PaolaCV14/IOT-SOFIA-2026/presentacion/paper_segundo_corte_texto.txt

--- PÁGINA 1 ---

LABDST SOFIA, ITESO, FALL 2026 1
SOFIA: Modular Robotic Kinetic Surface for Human-Robot
Interaction and Thermal-Constrained Actuator Characterization
Paola M. Covarrubias-Viveros, Lizeth A. M ´endez-Ortiz, Juan Bernardo Orozco-Quirarte, Karen I. S ´anchez-Garc´ıa,
Alan E. Fuentes-Guti ´errez, Jorge A. Lizarraga, Graciela Baca, Luis Enrique Gonz ´alez-Jim´enez and Luis F.
Luque-Vega
Abstract—Modular robotic systems leverage repeatable elec-
tromechanical units to enable flexible, scalable, and reconfig-
urable architectures. In interactive human-robot installations,
spatial tracking of human body posture and gestures provides in-
tuitive stimulus-response dynamics. This paper presents SOFIA,
an interactive modular robotic surface comprising sixteen elec-
tromechanical units, each providing two rotational degrees of
freedom actuated by commercial MG90S servomotors. While
commercial servomotors encapsulate internal closed-loop position
control via pulse-width modulation (PWM), persistent angular
errors caused by mechanical stalls, external disturbances, or
fabrication tolerances induce thermal degradation and excessive
power consumption. To investigate actuator reliability under
persistent position error conditions, this work formulates an
experimental characterization protocol assessing the thermal
response of an MG90S under mechanical stall. Using an LM35
precision temperature sensor and a commanded reference angle,
an empirical first-order thermal model is derived via logarithmic
transformation and linear regression, yielding an estimated
thermal time constant ofτ≈80.6s and a peak temperature
exceeding70 ◦C. The proposed framework couples 3D real-time
visual tracking with closed-loop kinematic control, providing
direct evidence on the operational limits and thermal constraints
required for reliable long-term deployment in modular robotic
surfaces.
Index Terms—Modular robotics, Human-Robot Interaction
(HRI), servomotor characterization, thermal modeling, bang-
bang control, computer vision, kinematics.
I. INTRODUCTION
M
ODULAR robotics enables the design and construction
of complex robotic systems from repeatable functional
units that integrate mechanical, electronic, and control capabil-
ities. This approach significantly streamlines manufacturing,
system reconfiguration, and maintenance, while supporting
distributed architectures where autonomous modules exchange
information and share operational resources [1]. Compared
to monolithic, rigid robotic platforms, modular reconfigurable
robots offer superior adaptability and permit functional units
to be deployed across diverse spatial and kinematic configu-
rations [1].
In parallel, socially interactive and human-robot interaction
(HRI) systems incorporate perception and actuation mech-
anisms to establish continuous, non-verbal dialogue with
human participants. Within this domain, posture, gestures,
and body kinematics constitute vital communication channels
for interpreting user intent and synthesizing reactive robotic
The authors are with the Department of Technological and Industrial
Processes, ITESO, Tlaquepaque 45604, Jalisco, Mexico.
behavior [2]. Consequently, modern kinetic robotic installa-
tions operate not merely as automated spatial mechanisms,
but as interactive expressive surfaces capable of responding
synchronously to multimodal human stimuli.
Within this framework, this paper introduces SOFIA, a mod-
ular robotic installation comprising sixteen electromechanical
units arranged in a kinetic honeycomb array. Each module
provides two rotational degrees of freedom (2-DOF) driven by
dual metal-gear MG90S servomotors. Each unit incorporates
dedicated onboard electronics for signal reception, trajectory
interpolation, and actuator pulse generation. Global supervi-
sory communication is established via Bluetooth Low Energy
(BLE) and Wi-Fi, whereas inter-module synchronization is
supported through an industrial RS-485 / Modbus bus.
The system relies on an ESP32-C3 microcontroller as
the core processing and telemetry engine [3], coupled with
PCA9685 16-channel 12-bit I 2C PWM controllers [?] to syn-
thesize precise control pulses for the servomotors. Although
commercial off-the-shelf (COTS) servomotors simplify spa-
tial positioning, their internal closed-loop controllers remain
completely encapsulated within the actuator housing. Conse-
quently, while the supervisory system commands an angular
setpoint via external 50 Hz PWM duty cycles, the internal
drive strategy utilized to eliminate error between reference and
actual shaft position is inaccessible to the designer.
This characteristic becomes critical when a servomotor
experiences operational constraints where it cannot reach the
commanded angular setpoint. In large-scale kinetic arrays
composed of numerous densely packed modules, mechanical
interference, fabrication tolerances, structural interference, or
physical obstacles produce persistent, non-zero position errors.
Under such conditions, internal driver behavior governs cur-
rent draw, internal thermal dissipation, and long-term hardware
reliability.
A classical control archetype relevant to bounded-input
actuators under persistent saturation is bang-bang (on-off) con-
trol. Bang-bang strategies naturally arise in control problems
subject to bounded actuation limits and represent a fundamen-
tal baseline for analyzing actuator dynamics under persistent
error [4]. However, whether an embedded servomotor driver
exhibits a quasi-bang-bang response cannot be established
solely from external PWM waveforms.
To address this challenge, this paper experimentally char-
acterizes the electromechanical and thermal behavior of the
MG90S servomotor under persistent position error. By impos-
ing a mechanical constraint on the output shaft and monitoring
surface temperature with a precision LM35 sensor, this study

--- PÁGINA 2 ---

LABDST SOFIA, ITESO, FALL 2026 2
extracts empirical first-order thermal models via linear regres-
sion. The primary working hypothesis posits that persistent
angular error induces an observable thermal signature that
quantitatively reflects actuator operational constraints. The
core contribution of this work lies in combining a vision-driven
modular robotic architecture for human-robot interaction with
rigorous experimental actuator characterization, establishing
thermal boundaries to guarantee operational reliability in ki-
netic surfaces.
A. Related Work
Recent advances in interactive surfaces and vision-driven
robotics have accelerated with lightweight machine learning
inference frameworks. Qui ˜nonezet al.[5] demonstrated the
efficacy of MediaPipe solutions for real-time 3D landmark
estimation. Contemporary computer vision implementations
leveraging MediaPipe [6] and OpenCV [7], [8] demonstrate
how 21-point hand topologies and skeletal posture can be
extracted in real time with minimal computational overhead.
In modular and reconfigurable robotics, Seoet al.[1]
established foundational taxonomy and scalability criteria for
autonomous repeatable modules, emphasizing distributed co-
ordination and power distribution challenges. Fonget al.[2]
surveyed social robotics, demonstrating that physical motion,
non-verbal mirroring, and gestural responsiveness enhance
user engagement. Nevertheless, existing kinetic installations
frequently overlook actuator stall dynamics and internal ther-
mal accumulation occurring across densely populated arrays.
Boyd and Barratt [4] established theoretical boundaries for
bounded controller actions; building upon these foundations,
this research bridges the gap between high-level visual track-
ing and low-level physical actuator reliability.
B. Formal Problem Formulation
The SOFIA system requires coordinated spatial orientation
of 32 independent servomotors across 16 electromechanical
modules. Each actuator receives an angular reference setpoint
θd(t)and is commanded to achieve the target physical orien-
tationθ(t).
The angular position errore(t)for any given actuator is
formally defined as:
e(t) =θ d(t)−θ(t),(1)
whereθ d(t)∈[θ min, θmax]corresponds to the desired (com-
manded) angular position, andθ(t)denotes the instantaneous
actual angular position of the output shaft.
Under ideal, unconstrained operation, the internal feedback
loop drivese(t)→0within a settling timet s ∈[75,180]ms.
However, when an external mechanical constraint prevents the
actuator from reachingθ d(t)such thatθ(t) =θ stall ̸=θ d(t),
the error persists indefinitely:
e(t) =θ d(t)−θ stall = ∆θ0 ̸= 0,∀t≥t 0.(2)
Whene(t)persists, the internal H-bridge driver continu-
ously supplies high current to the DC coreless motor in an
attempt to minimize the tracking discrepancy. This condition
causes significant Joule heating (P loss =I 2R) within the
motor armature and driver silicon, inducing rapid thermal
accumulation. Modeling this thermal profile and its associated
time constant provides the quantitative foundation for actuator
risk mitigation in the SOFIA array.
II. MATERIALS ANDMETHODS
Table I summarizes the bill of materials for the SOFIA 16-
module system, including each component’s technical descrip-
tion, manufacturer, and country of origin.
The servomotor operational limits and step response
parameters were experimentally evaluated using
the test protocol recorded in ”docs/experimental-
data/servomotor pruebas caracterizacion.xlsx”. Under
continuous PWM excitation at 50 Hz, the effective angular
deflection spannedθ∈[19.3 ◦,70.2 ◦]with a mean operating
angle of47.9 ◦ and step response times ranging between
75ms and180ms.
A. Experimental Setup: Thermal Characterization under Per-
sistent Error
To investigate the thermal behavior and reliability limits of
the MG90S servomotors within the SOFIA architecture, an
experimental testing apparatus was designed to record ther-
mal dissipation under mechanical restriction. The test bench
comprises:
1) An MG90S metal-gear servomotor powered by a regu-
lated 5.0 V DC supply.
2) A 10 kΩlinear precision potentiometer utilized to set
and modulate the commanded angular setpointθ ref(t).
3) A calibrated LM35 precision centigrade temperature
sensor mechanically thermally coupled to the servomo-
tor casing via thermal interface compound, providing an
analog output of10mV/ ◦C.
4) An acquisition node based on an ESP32 microcontroller
acquiring angular commands and surface temperature
Tservo(t)at a sampling rate of1Hz.
A rigid mechanical boundary stop was rigidly fixed to
the servomotor output horn to physically prevent the output
shaft from reaching the commanded angular referenceθ ref(t),
deliberately maintaining a persistent non-zero error condition:
e(t) =θ ref(t)−θ stall >0. Ambient room temperatureT amb
was monitored as the reference operating baseline.
The experimental characterization protocol was conducted
in two sequential stages:
•Trial 1 (Failure and Degradation Assessment):The
actuator was initialized atT amb = 21.37◦C and subjected
to a persistent stall reference ofθ ref = 180 ◦. The test
proceeded continuously for226s, until distinct audi-
ble abnormalities, gear strain, and subsequent actuator
degradation occurred. The surface temperature climbed
monotonically to a critical peak ofT max = 64.84◦C.
•Trial 2 (Extended Thermal Accumulation and Cool-
ing):In an extended continuous run spanningt∈
[973.1,1654.1]s (682 data points), the actuator thermal
profile was evaluated under varying commanded angular
steps. Starting fromT amb = 19.29◦C, the casing reached

--- PÁGINA 3 ---

LABDST SOFIA, ITESO, FALL 2026 3
TABLE I
BILL OFMATERIALSSUMMARY FOR THESOFIA 16-MODULESYSTEM
Component Qty. Technical description Manufacturer Country / Location
MG90S Servomotor 32 Metal gear micro servo, rated torque 1.8–2.2 kgf·cm at 4.8–6.0 V ,
evaluated angle rangeθ∈[19.3 ◦,70.2 ◦], 50 Hz PWM control TowerPro Shenzhen, China
Module Enclosure 16 3D-printed PLA enclosure, custom SOFIA003 honeycomb design
for 2-DOF module
In-house (LabDST) Mexico City, Mexico
M3 Fasteners (Various) 64 Stainless steel socket head cap screw, M3×10 mm, for servo
and frame mounting
Generic Mexico City, Mexico
PCA9685 Servo Driver 2 16-Channel 12-bit PWM I 2C driver module for 32 servomotors NXP Semiconductors /
Adafruit
Eindhoven, Netherlands
ESP32-C3 Master MCU 1 32-bit RISC-V microcontroller, 2.4 GHz Wi-Fi / Bluetooth 5 LE
for trajectory generation
Espressif Systems Shanghai, China
TABLE II
ESP32-C3TECHNICAL SPECIFICATIONS AND COMPLIANCE ASSESSMENT.
Component Parameter Value Source
ESP32-C3
(Espressif
Systems,
v2.4)
Supply V oltage
(VDDA,
VDD3P3,
VDD3P3 RTC)
3.0–3.6 V; 3.3 V
typical
Datasheet v2.4,
Section 5.2, Table
5-2, p. 54
ESP32-C3 Cumulative
Supply Current
(IVDD)
0.5 A min. Datasheet v2.4,
Section 5.2, Table
5-2, p. 54
ESP32-C3 Peak Wi-Fi
Transmission
Current
276–335 mA, de-
pending on the
operating mode
Datasheet v2.4,
Section 5.6.1,
Table 5-7, p. 56
ESP32-C3 VIH: High-Level
Input V oltage
0.75×VDD min. Datasheet v2.4,
Section 5.4, Table
5-4, p. 55
ESP32-C3 VIL: Low-Level
Input V oltage
−0.3to 0.25×
VDD V
Datasheet v2.4,
Section 5.4, Table
5-4, p. 55
ESP32-C3 Strapping
Pins / Boot
Configuration
Pins
GPIO2, GPIO8,
and GPIO9. Their
logic levels are
sampled during
reset to determine
the boot mode.
Datasheet v2.4,
Section 3, Boot
Configuration, p.
30
ESP32-C3 GPIO8 and
GPIO9 Boot-
Time Levels
SPI Boot: GPIO9
= 1. Joint Down-
load Boot: GPIO8
= 1 and GPIO9
= 0. The GPIO8
= 0, GPIO9 =
0 combination is
not listed as a
valid boot mode
in Table 3-3.
Datasheet v2.4,
Section 3.1, Table
3-3, p. 31
ESP32-C3 Wi-Fi 2.4 GHz, IEEE
802.11 b/g/n
Datasheet v2.4,
Features section,
p. 3
ESP32-C3 Bluetooth Bluetooth 5 Datasheet v2.4,
Features section,
p. 3
ESP32-C3 Operating
Temperature
56 ◦C Datasheet v2.4,
Section 1.2, Table
1-1, p. 12
a steady-state thermal maximum ofT max = 70.21 ◦C
(∆T= 50.92 ◦C) before stabilization and subsequent
cooling upon stall removal.
B. First-Order Thermal Modeling and Parameter Identifica-
tion
For the experimental characterization, the commanded an-
gular position acts as the system input,u(t) =θ d(t), while the
recorded servomotor casing temperature represents the mea-
sured system output,y(t) =T s(t). Room ambient temperature
is denoted asT a.
TABLE III
SERVOMOTORMG90S TECHNICAL SPECIFICATIONS AND COMPLIANCE
ASSESSMENT.
Component Parameter Value Source
MG90s Supply and operating
V oltage
4.8 V – 6.0 V MG90S datasheet,
Tower Pro, p.2
MG90s Stall Torque 1.8 kgf·cm at
4.8V , 2.2 kgf·cm
at 6V
MG90S datasheet,
Tower Pro, p.1
MG90s Operating Speed 0.1 s/60 ◦ at 4.8V ,
0.08 s/60 ◦ at 6V MG90S datasheet,Tower Pro, p.1
MG90s Control Signal PWM, orange
wire; Vcc red;
GND brown;
20 ms (50 Hz)
period, 1–2 ms
duty cycle
MG90S datasheet,
Tower Pro, p.2
MG90s Rotation Range approximately
180 degrees (90 ◦
in each direction)
MG90S datasheet,
Tower Pro, p.2
MG90s Evaluated
Angle Range
(Experimental)
19.3◦ – 70.2 ◦
(mean: 47.9 ◦) LabDST test log(docs/experimental-
data)
MG90s Response Time (Ex-
perimental)
75 – 180 ms LabDST test log
(docs/experimental-
data)
MG90s Dead Band Width 5µs MG90S datasheet,
Tower Pro, p.2
MG90s Operating Tempera-
ture
Not specified in
datasheet
N/A
MG90s Dimension & Weight 22.5×12×35.5
mm approx.; 13.4
g
MG90S datasheet,
Tower Pro, p.1
In accordance with first-order thermal dynamics, the system
is modeled in the Laplace domain by the empirical transfer
function:
GT (s) = Ts(s)Θd(s) = KTτT s+ 1 ,(3)
whereK T represents the thermal steady-state gain ( ◦C/rad or
◦C/◦), andτ T is the thermal time constant of the actuator.
In the time domain, the step response of this first-order
system to a persistent commanded step inputθ d(t)is expressed
as:
Ts(t) =T a + (Tss −T a)

1−e −t/τT

,(4)
whereT ss represents the asymptotic steady-state temperature
reached under continuous stall.
Following the identification methodology presented in the
LabDST course lectures, the non-linear exponential response
is transformed into a linear relationship:
ln (Tss −T s(t)) =− 1τT t+C,(5)

--- PÁGINA 4 ---

LABDST SOFIA, ITESO, FALL 2026 4
TABLE IV
PCA9685TECHNICAL SPECIFICATIONS AND COMPLIANCE ASSESSMENT.
Component Parameter Value Source
PCA9685
(NXP Semi-
conductors,
datasheet
Rev. 4)
Supply V oltage
(VDD)
2.3–5.5 V Datasheet Rev. 4,
Section 2, Table
14, p. 38
PCA9685 PWM Resolution 12 bits (4096
steps)
Datasheet Rev. 4,
Section 1, p. 1
PCA9685 Number of PWM
Channels
16 independent
channels
Datasheet Rev. 4,
Section 1, p. 1
PCA9685 Communication
Interface
I2C Fast-mode
Plus
Datasheet Rev. 4,
Section 2, p. 2
PCA9685 Maximum I 2C
Frequency
Up to 1 MHz Datasheet Rev. 4,
Section 2, p. 2
PCA9685 PWM Frequency
Range
24 Hz – 1526 Hz Datasheet Rev. 4,
Section 7.3.5, p.
25
PCA9685 Default PWM
Frequency
Approximately
200 Hz
Datasheet Rev. 4,
Table 8, p. 25
PCA9685 I2C Address Con-
figuration
A0–A5 pins, up
to 62 devices
Datasheet Rev. 4,
Section 7.1, p. 7
PCA9685 Output Current 25 mA per output Datasheet Rev. 4,
Table 13, p. 38
PCA9685 Total Output Cur-
rent
400 mA maxi-
mum
Datasheet Rev. 4,
Table 13, p. 38
PCA9685
Module
(UNIT
Electronics)
Output Ports 16 PWM outputs
with V+, GND
and PWM signal
UNIT Electronics
product specifica-
tion
PCA9685
Module
(UNIT
Electronics)
Logic V oltage 3–5 V UNIT Electronics
product specifica-
tion
PCA9685
Module
(UNIT
Electronics)
Servo Power Sup-
ply (V+)
External power
supply for
connected
actuators
UNIT Electronics
product specifica-
tion
PCA9685 Operating
Temperature
−40 ◦Cto
+85 ◦C Datasheet Rev. 4,Table 13, p. 38
whereC= ln(T ss −T a)is a constant. Applying linear least-
squares regression betweenln(T ss −T s(t))and timet, the
slope of the fitted linem=−1/τ T provides the estimate of
the thermal time constant:
τT =− 1m .(6)
Evaluating the empirical data from Trial 1 (t∈[1,226]s,
Ta = 21.37 ◦C,T ss ≈64.84 ◦C) yields a regression slope of
m=−0.01241s −1, corresponding to an identified thermal
time constant ofτ T ≈80.6s.
This quantitative identification confirms that when an
MG90S servomotor enters an unmitigated mechanical stall, it
reaches63.2%of its maximum thermal rise in approximately
80s, approaching destructive casing temperatures (>65 ◦C)
within 4 minutes. Because the internal driver continuously
applies peak torque without internal thermal throttling, its be-
havior closely mirrors an unconstrained bang-bang controller
under saturation.
III. DESIGN ANDIMPLEMENTATION OF THE
TECHNOLOGICALSOLUTION
The SOFIA technological solution integrates physical mod-
ular hardware, distributed electronics, and real-time vision-
based kinematic coordination.
0 50 100 150 200
Time t (s)
20
30
40
50
60
70Temperature (∘ C)
(a) Trial 1: Heating under continuous stall
Measured Ts(t)
Peak Tmax = 64.84 ∘ C
Ambient Ta = 21.37 ∘ C
0 100 200 300 400 500 600 700
Time t (s)
20
30
40
50
60
70Temperature (∘ C)
(b) Trial 2: Extended thermal cycle
Measured Ts(t)
Peak Tmax = 70.21 ∘ C
Ambient Ta = 19.29 ∘ C
Fig. 1. Experimental thermal characterization of the MG90S servomotor under
persistent mechanical stall: (a) Trial 1 heating curve until audible failure at
t= 226s (T max = 64.84◦C); (b) Trial 2 extended thermal cycle across 682
data points reaching peak steady-state temperature of70.21 ◦C.
A. System Architecture and Subsystems
The physical and functional architecture of the SOFIA
platform is organized into three primary interconnected sub-
systems:
•Perception and High-Level Control:A host workstation
executes an optimized real-time vision pipeline running
on Python. It captures live camera feeds, performs 3D
upper-body pose estimation and dual 21-point hand topol-
ogy tracking, recognizes static and dynamic interaction
gestures, and translates user coordinatesp(t)∈R 3 into
spatial target orientations.
•Master Communication and Telemetry:An ESP32-
C3 master microcontroller receives spatial setpoints via
low-latency Wi-Fi / BLE communication and broadcasts
synchronized module packets across an isolated RS-485
/ Modbus serial bus.
•Distributed Modular Honeycomb Array:16 indepen-
dent 2-DOF modules receive target angular pairs(q 1, q2).
Actuation pulses are generated locally via PCA9685
12-bit PWM controllers, driving 32 MG90S metal-gear
servomotors.
B. Computer Vision Tracking and Dynamic Gesture Pipeline
The perception layer is developed using Python 3.11 with
MediaPipe Tasks and OpenCV , structured into a modular, low-
latency architecture:
1)Real-Time 3D Landmark Extraction:Using Google
MediaPipe’s Landmarker models in video mode, the
system extracts 33 holistic body landmarks and two sets
of 21 3D hand coordinates (x, y, z) with millisecond-
accurate timestamps, achieving stable 30 FPS through-
put on host CPUs.
2)Rotation-Invariant Hand Topology:Finger states are
computed using 3D Euclidean distances between distal
tips and the wrist base, normalized against palm scale
∥pwrist −p MCP∥. This eliminates perspective distortion
when fists face the camera.
3)Dynamic Gesture Recognition Engine:A modular
coordination layer (GestureDetector) arbitrates between
static and dynamic interactions with strict temporal
priority:
•Dynamic Wave (Saludo):Tracks lateral palm os-
cillations (landmark 9X-coordinate); requires at

--- PÁGINA 5 ---

LABDST SOFIA, ITESO, FALL 2026 5
least 3 direction reversals and amplitude>0.05
normalized units, prioritizing greeting over static
open-hand detection.
•Two-Handed RPS Game Intent (Intenci ´on PPT):
Detects a horizontal flat palm as a reference plane
and records 3 vertical fist-pump impacts using a
finite-state machine (d contact <0.17andd release >
0.20normalized units). A hysteresis hold filter pre-
vents transient flickering with static rock or paper
gestures.
•Static Postures:Detects two-handed heart geome-
tries, scissors, open paper, and closed fists.
C. Electronic Interconnection and Current Hardware Stage
In the current development stage (Corte 1, Discover→
Learn), the physical electronic architecture is validated us-
ing commercial off-the-shelf (COTS) breakout boards on
breadboards, directly interconnecting the ESP32-C3 microcon-
troller, dual PCA9685 PWM drivers, and external 5.0 V power
rails. Custom printed circuit board (PCB) layout, routing, and
fabrication remain open work for subsequent project phases
(Make→Test), once the thermal boundaries and wiring
constraints of the 16-module array are fully validated through
the present prototype.
D. Thermal Protection and Reliability Risk Mitigation
Based on the empirical thermal constant (τ≈80.6s)
derived in Section II-B, software-level watchdog limits are
integrated into the SOFIA kinematic controller:
1)Command Saturation Limiting:Commanded angles
are hard-bounded within the verified operational range
q1, q2 ∈[19.3 ◦,70.2 ◦](mean:47.9 ◦) established in
Table III.
2)Stall Timeout Monitoring:If an actuator target remains
static under continuous high-load deflection for∆t >
15s (<0.2τ), the supervisory controller decrements
the hold torque or enters an idle compliant mode,
preventing cumulative temperature rise above the55 ◦C
safety ceiling.
IV. RESULTS
A. Kinematic Tracking Simulation
To validate the analytical kinematic model, a dynamic track-
ing simulation of the 16-module SOFIA robotic honeycomb
array was conducted in a virtual 3D environment using the
Unity engine [9]. The objective was to evaluate the coordinated
orientation of the modules toward a moving target coordinate
p(t)∈R 3.
For each modulem i, the inverse kinematics procedure
determines the servo variables(q 1, q2)from the relative po-
sition of the target with respect to the module base frame.
The resulting joint angles are constrained according to the
permissible actuator range. The complete inverse kinematics
procedure is summarized in Algorithm 1.
Algorithm 1SOFIA Module Inverse Kinematics
Require:Module base originr 0,2, target coordinatep, joint
angle limits[q 1,min, q1,max]and[q 2,min, q2,max]
Ensure:Joint anglesq 1, q2
1:r 2,p ←p−r 0,2
2:[u x, uy, uz]⊤ ←r 2,p/∥r2,p∥
3:q 2 ←arcsin(u x)
4:q 1 ←atan2(−u y, uz)
5:ifq 1 < q1,min then
6:q 1 ←q 1,min
7:else ifq 1 > q1,max then
8:q 1 ←q 1,max
9:end if
10:ifq 2 < q2,min then
11:q 2 ←q 2,min
12:else ifq 2 > q2,max then
13:q 2 ←q 2,max
14:end if
15:returnq 1, q2
Figure 2 shows six representative frames of the simulated
tracking process. As the target moves through the workspace,
the modules progressively change their orientation, maintain-
ing the direction of their normal vectorsˆr (i)2,3 toward the target
position. The sequence illustrates the coordinated response
of the 16-module array during different stages of the target
trajectory.
(a)
 (b)
(c)
 (d)
(e)
 (f)
Fig. 2. Representative frames of the SOFIA kinematic tracking simulation.
The six frames illustrate the progressive reorientation of the 16-module
honeycomb array as the target coordinatep(t)moves through the workspace,
with the module normal vectorsˆr (i)2,3 oriented toward the target.

--- PÁGINA 6 ---

LABDST SOFIA, ITESO, FALL 2026 6
V. DISCUSSION
The experimental characterization of the MG90S servomo-
tor and the kinematic tracking simulation of the SOFIA kinetic
array provide key insights into the intersection between high-
level human-robot interaction and low-level electromechanical
constraints:
•Actuator Thermal Dynamics and Bang-Bang Anal-
ogy:The empirical thermal response confirms that COTS
servomotors operating under persistent position error
display behavior characteristic of unconstrained satura-
tion. Because the internal microcontroller continuously
activates the H-bridge at full pulse width to overcome
the perceived spatial error, electrical energy is dissipated
as heat with a time constant ofτ≈80.6s. This steep
thermal gradient directly degrades the plastic gear train
retainers and motor brush assemblies when temperatures
exceed65 ◦C.
•Comparison with Established Literature:In contrast
to standard modular robotic architectures [1] that treat
actuators as ideal velocity/position sources, our experi-
mental findings emphasize that thermal accumulation is a
dominant failure mode in densely packed kinetic surfaces.
By incorporating watchdog current and stall thresholds,
SOFIA maintains continuous social interaction [2] with-
out exceeding safe thermal boundaries.
•Methodological Limitations:The LM35 sensor mea-
sures casing surface temperature rather than internal
coreless rotor winding temperature directly. Internal coil
temperatures are higher than outer surface measurements.
Furthermore, while the external 50 Hz PWM command is
known, the internal firmware closed-loop control signals
remain inaccessible. Therefore, these thermal models
serve as an effective macroscopic indicator rather than
an internal algorithm reverse-engineering tool.
VI. CONCLUSIONS
This paper presented the conceptual design, system archi-
tecture, and experimental actuator characterization of SOFIA,
an interactive modular robotic surface comprising sixteen 2-
DOF electromechanical units. By coupling real-time computer
vision (MediaPipe 3D upper-body pose and 21-point hand
tracking) with distributed ESP32-C3 / PCA9685 motion con-
trollers, the platform synthesizes intuitive kinetic responses
to human non-verbal gestures. Experimental evaluation under
persistent position error conditions demonstrated that unmiti-
gated mechanical stalls lead to rapid thermal runaway with an
identified first-order time constant ofτ≈80.6s and casing
temperatures reaching70.2 ◦C. Incorporating angular limits
and thermal watchdog timeouts mitigates actuator burnout risk,
establishing a robust foundation for the physical implementa-
tion and deployment of modular kinetic surfaces.
AUTHORCONTRIBUTIONS
P. M. C.-V . conceived the SOFIA modular platform concept,
designed the physical mechanical assemblies, and coordinated
the experimental protocol. J. B. O.-Q. developed the real-time
computer vision tracking pipeline, MediaPipe gesture recog-
nition engine, and LaTeX documentation. L. A. M.-O. and
K. I. S.-G. conducted the experimental thermal testing, sensor
calibration, and data acquisition logs. A. E. F.-G. contributed
to the distributed electronic architecture and kinematic model
analysis. All authors participated in the experimental data
interpretation, drafting, and final review of the manuscript.
DATAAVAILABILITY
The experimental actuator logs, CAD models, and kinematic
tracking software supporting the findings of this study are
openly available in the GitHub project repository: https://
github.com/PaolaCV14/IOT-SOFIA-2026.
ACKNOWLEDGMENT
The authors thank the Department of Technological and
Industrial Processes and the Laboratory of Distributed Systems
and Telematics (LabDST) at ITESO for providing laboratory
instrumentation, computing resources, and technical support
throughout the development of the SOFIA project.
CONFLICTS OFINTEREST
The authors declare no conflicts of interest.
REFERENCES
[1] J. Seo, J. Paik, and M. Yim, “Modular reconfigurable robotics,”Annual
Review of Control, Robotics, and Autonomous Systems, vol. 2, pp. 63–88,
2019.
[2] T. Fong, I. Nourbakhsh, and K. Dautenhahn, “A survey of socially
interactive robots,”Robotics and Autonomous Systems, vol. 42, no. 3–
4, pp. 143–166, 2003.
[3] Espressif Systems,ESP32-C3 Series Datasheet, Espressif Systems, 2024,
datasheet, v2.4. Available: https://www.espressif.com.
[4] S. Boyd and C. Barratt,Linear Controller Design: Limits of Performance.
Englewood Cliffs, NJ, USA: Prentice Hall, 1991.
[5] Y . Qui ˜nonez, C. Lizarraga, and R. Aguayo, “Machine learning solutions
with MediaPipe,” inProc. 11th Int. Conf. Softw. Process Improv.
(CIMPS), Acapulco, Mexico, 2022, pp. 1–6. [Online]. Available:
https://ieeexplore.ieee.org/stamp/stamp.jsp?arnumber=10035706
[6] Innovatiana, “MediaPipe 101,” https://www.innovatiana.com/es/post/
mediapipe-101, 2026, accessed: Sep. 15, 2026.
[7] OpenCV, “Open source computer vision library,” https://opencv.org/,
2026, accessed: Sep. 15, 2026.
[8] OMES, “Detecci ´on de objetos con MediaPipe, Python y OpenCV,” https:
//omes-va.com/deteccion-de-objetos-con-mediapipe-python-opencv/,
2026, accessed: Sep. 15, 2026.
[9] Unity Technologies, “Unity Real-Time 3D Development Platform,” https:
//unity.com, 2023, version 2022.3 LTS.
