PaolaCV14/IOT-SOFIA-2026/Correcciones Corte 1.docx

Graficas:

Arcchivo: Datos_5grados (representa el servo con un cambio de 2 a 5 grados), de manera repentina:

Archivo: Datos_CHIDOS_DE_FORZADO, representa los datos con el servo forzado a llegar a su posición, se ve como se muere el servo:

Archivo_ datos_901, representa el servo movido de manera rápida a 90 grados:
