PaolaCV14/IOT-SOFIA-2026/presentacion/SOFIA_LabDST_Presentacion.pptx

LABDST · ITESO · EVALUACIÓN DE SEGUNDO CORTE (OTOÑO 2026)

SOFÍA: la pared que te mira

Pared robótica interactiva de paneles que te siguen y hacen rutinas

Diseño 3D de paneles móviles en panal

Equipo 1 · Ingeniería ITESO

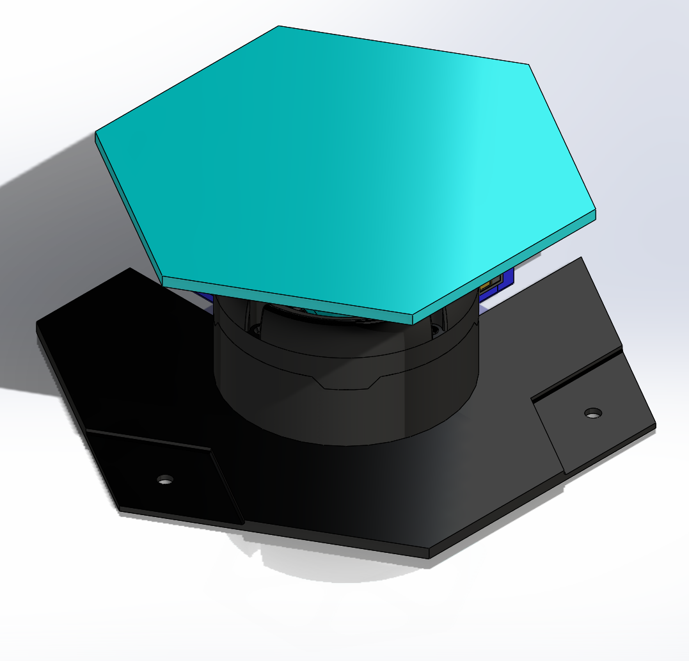
[picture p11: figure]

Prototipo físico montado y funcional

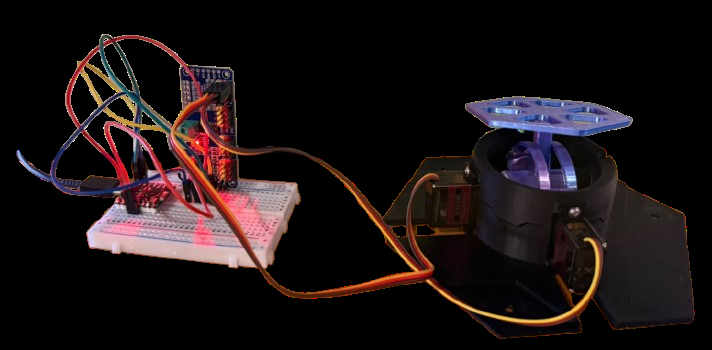
[picture p12: figure]

Notes: Tiempo: 15 s
Buenos días profesores y evaluadores. Presentamos SOFÍA: una pared robótica interactiva con paneles tipo panal que te siguen con la mirada y responden a tus gestos en vivo, junto con nuestras pruebas para operarla de forma segura.

## Slide 2

RÚBRICA: PLANTEAMIENTO Y MARCO (20%)

Las paredes interactivas cuestan millones y se queman

Piezas impresas en 3D

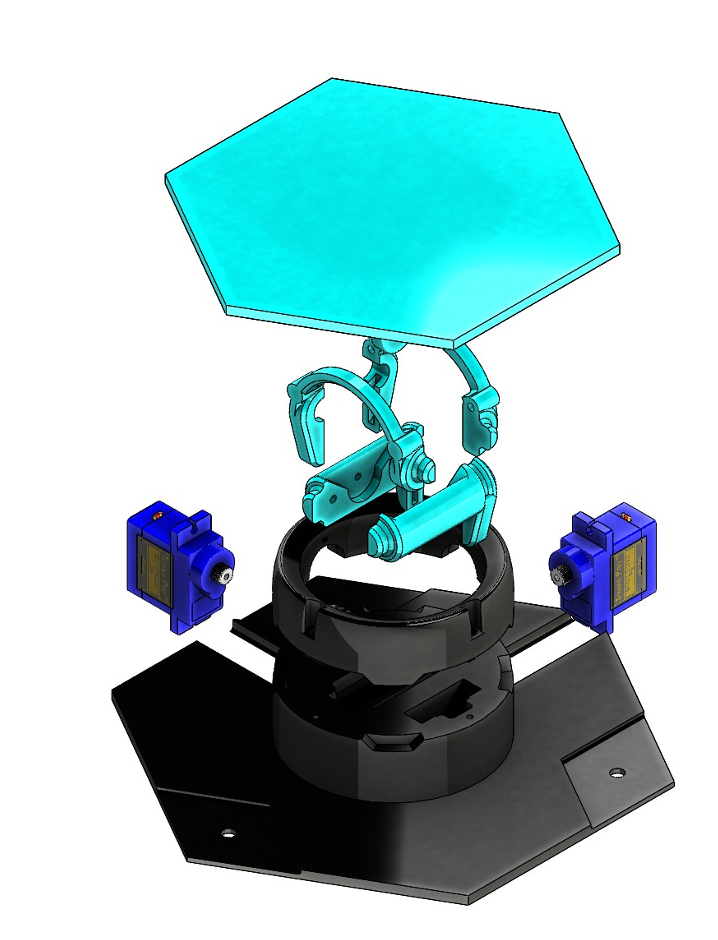
[picture p13: figure]

💰 Carísimas

Cuestan millones

🔒 Motores cerrados

Mecánica inaccesible

🔥 Se sobrecalientan

Riesgo al detenerse

Objetivo: crear una pared robótica accesible que te siga en tiempo real y sea segura.

▸ Paneles modulares en 3D

▸ Sigan y reaccionen a gestos

▸ Protegerse del sobrecalentamiento

Corte 1: Diseño ➔ Corte 2: Prototipo [ESTAMOS AQUÍ] ➔ Corte 3: Pared completa

Materiales: 16 módulos PLA SOFIA003, 32 servos MG90S, 64 tornillos M3, 2 PCA9685, 1 ESP32-C3 y cámara.

2/10

Notes: Tiempo: 45 s
Las paredes cinéticas en museos o aeropuertos cuestan millones de pesos y si alguien las toca se queman. Nuestro objetivo es crear una pared modular accesible que te siga con la mirada y se autoproteja de sobrecalentamientos.

## Slide 3

RÚBRICA: PLANTEAMIENTO Y MARCO (20%)

Hermosas, caras y sin ojos

MIT inFORM

Mesas cinéticas motorizadas

▸ 900 barras móviles
▸ Millones de pesos en costo
▸ Atadas a un laboratorio

Arte Comercial

Esculturas en aeropuertos

▸ Coreografía en bucle fijo
▸ Cero interacción viva
▸ No te ven ni te siguen

SOFÍA (ITESO)

Pared interactiva inteligente

⭐ Te ve y te sigue en vivo
⭐ Modular en 3D (16 módulos)
⭐ Sin sensor interno: medido con láser y osciloscopio

3/10

Notes: Tiempo: 40 s
Las obras existentes como inFORM del MIT o las esculturas de aeropuertos son carísimas o solo repiten videos sin verte. SOFÍA te ve en vivo, es modular y accesible. Nuestro diferenciador clave es el estudio térmico: como el servomotor comercial NO tiene sensor interno de temperatura, medimos su calentamiento en laboratorio con termómetro láser y osciloscopio para diseñar su corte preventivo.

## Slide 4

RÚBRICA: DISEÑO DE LA INVESTIGACIÓN (20%)

Tres cosas medidas, tres líneas rojas

📷 Cámara web

30 FPS

💻 Software PC

Detecta tu mano

📶 Bluetooth

Sin cables LE

⚡ ESP32 + 2x PCA

Control 32 canales

🌸 16 Paneles

32 servos MG90S

1. Qué medimos

▸ Velocidad de cámara
▸ Respuesta al saludo
▸ Calor del motor

2. Con qué

▸ Cámara web HD (30 FPS)
▸ Termómetro láser y osciloscopio
▸ Sin sensor en motor (banco con tope)

3. Aprobamos si

⭐ > 30 FPS y < 100 ms
⭐ Bajo 55 °C
⭐ Corte antes de 15 s

4/10

Notes: Tiempo: 50 s
Medimos velocidad de cámara, respuesta a gestos y calor del motor con termómetro láser, osciloscopio e instrumentos mecatrónicos. Nuestros criterios de aprobación son claros: más de 30 cuadros por segundo, respuesta en menos de 100 milisegundos y corte de seguridad en menos de 15 segundos si algo se atora.

## Slide 5

RÚBRICA: DESARROLLO Y RESULTADOS (20%)

Te sigue la mano a más de 30 cuadros por segundo

Estación de control en tiempo real (PySide6)


30+ FPS

Visión fluida en tiempo real

Gestos reconocidos:

👋 Saludo · 💖 Corazón · 👊 Puño


5/10

Notes: Tiempo: 45 s
Nuestra estación de control procesa la mano a más de 30 cuadros por segundo en tiempo real. Reconoce gestos como saludos y corazones, y simulamos los 16 paneles en Unity para que se muevan coordinados sin chocar.

## Slide 6

RÚBRICA: DESARROLLO Y RESULTADOS (20%)

Saludas, y el panel te contesta

1. Módulo físico

⏱️ Cámara + BLE: ~45–50 ms

2. Gesto detectado

3. Panel oscilando

4. Retorno a centro

🛡️ Corte < 15 s diseñado

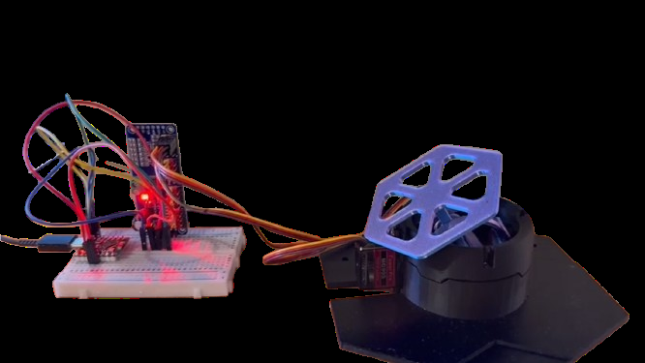
[picture p14: figure]
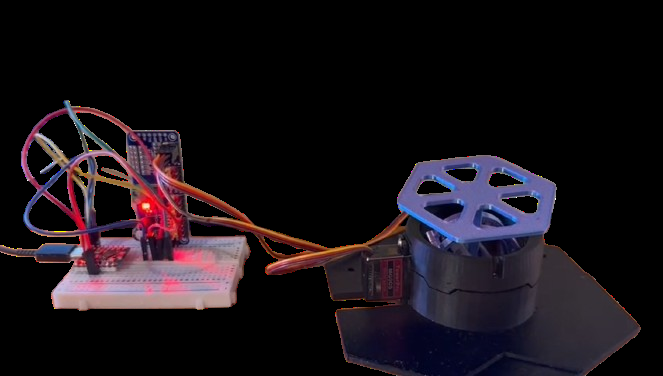
[picture p15: figure]
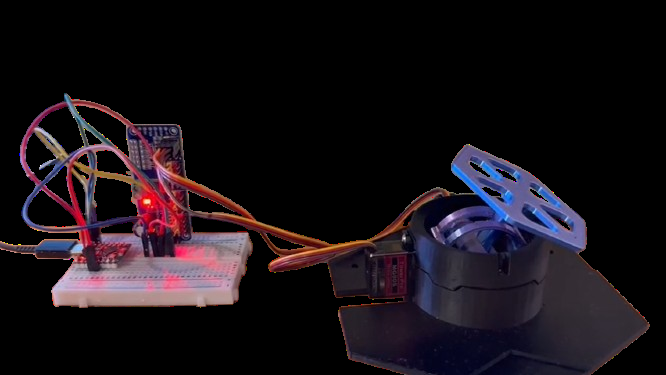
[picture p16: figure]

🔄 Ensayos repetidos (N=10)

6/10

Notes: Tiempo: 40 s
Aquí vemos el prototipo físico real. Cámara y Bluetooth tardan 45 a 50 milisegundos, y el servo 75 a 180 ms en moverse. Ensayos repetidos con N=10 validan la fluidez.

## Slide 7

RÚBRICA: DESARROLLO Y RESULTADOS (20%)

Si un panel se atora, en menos de 4 minutos se quema

Medición en banco con termómetro láser y osciloscopio (el motor no tiene sensor interno)

64.8 °C

a los 226 s (engrane forzado)

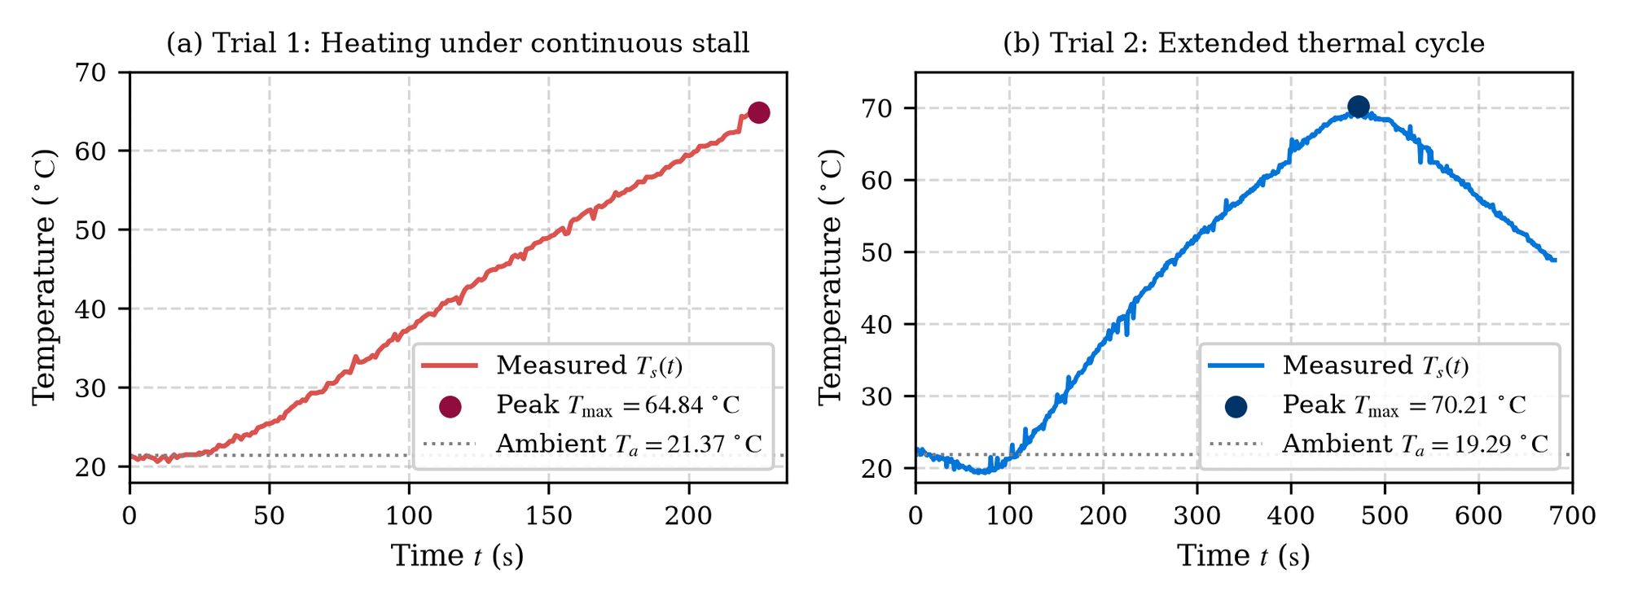
[picture p17: figure]

13 °C/min

a 3 min: 55 °C límite seguro

Con corte a 15 s: sube solo ~3 °C

7/10

Notes: Tiempo: 50 s
Este es nuestro hallazgo experimental más importante: sin carga el motor no se calienta. Pero atorado con un tope, sube unos 13 grados por minuto hasta llegar a 64.8 grados en menos de cuatro minutos; a los 3 minutos ya pasa de 55 grados, entrando a zona de riesgo. Con corte a 15 segundos solo sube unos 3 grados.

## Slide 8

RÚBRICA: BRECHA CON EL ENTORNO REAL (20%)

El laboratorio es fácil. Un museo no

Hoy en Laboratorio

Exigencia de un Museo

👤 1 persona quieta

👥 Multitud de visitantes cruzando manos

💡 Luz controlada

☀️ Sol directo, reflejos y sombras dinámicas

📏 Distancia fija a 1 m

📐 Público pasando a 3 o 5 metros

💻 Laptop con cables

📦 Sistema embebido oculto en el marco

8/10

Notes: Tiempo: 40 s
¿Por qué SOFÍA todavía no puede operar en un museo? En el laboratorio probamos con 1 persona a 1 metro y luz controlada. En un museo hay multitud de personas cruzando manos, luz solar cambiante y se necesita un sistema embebido dentro del marco.

## Slide 9

RÚBRICA: BRECHA CON EL ENTORNO REAL (20%)

10 minutos vs 12 horas

Nuestros Datos de Prueba

Exigencia de un Museo

⏱️ Pruebas de 10 min

⏳ 8 a 12 horas diarias ininterrumpidas

🚫 Nadie toca la pared

👶 Niños jalando pétalos (atasco: 0.9 A y 4.6 W)

🔌 1 módulo probado

⚡ 32 motores: ~23 A al arrancar (fuente 25 A)

🛠️ Reinicia un ingeniero

🔄 Se auto-recupera sola ante fallas

9/10

Notes: Tiempo: 40 s
La segunda brecha se basa en nuestros datos: un museo opera 12 horas seguidas, los niños van a jalar los pétalos demandando 0.9 amperes y disipando 4.6 watts de calor. Los 32 motores piden hasta 23 amperes al arrancar juntos requiriendo fuente de 25 amperes. Aun sin público, los pétalos se rozan por tolerancias de impresión (±0.4 mm); falta un acople mecánico que ceda sin romper engranes.

## Slide 10

RÚBRICA: REVISIÓN Y PASOS (10%)

De prototipo a pared completa

Corregimos del Corte 1

▸ Objetivos claros y delimitados
▸ Mediciones reales: 682 lecturas, 0.9 A atorado
▸ Comparativa con MIT y comercial

Para el Corte 3

▸ PCB de potencia definitiva (25 A)
▸ Apagado automático por software
▸ Colmena completa de 16 paneles

Diseño PCB de potencia para 32 motores

¿Preguntas?

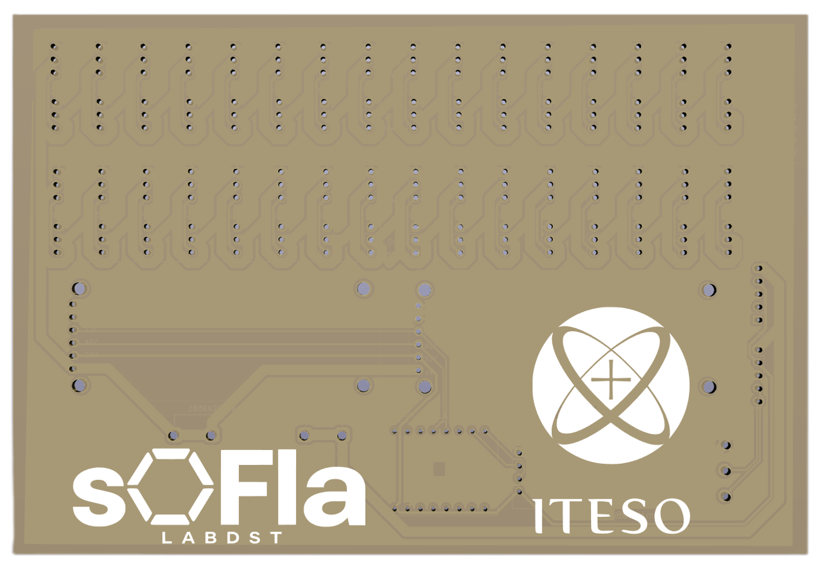
[picture p18: figure]

github.com/PaolaCV14/IOT-SOFIA-2026

10/10

Notes: Tiempo: 40 s
Atendimos las observaciones del Corte 1 con objetivos delimitados y mediciones reales de calor. Para el Corte 3 fabricaremos la PCB de potencia, el corte automático y montaremos los 16 paneles. Muchas gracias, abrimos la sesión de preguntas.

--- PREGUNTAS PROBABLES DE LOS JUECES Y RESPUESTAS BREVES ---
1. ¿Por qué el servomotor MG90S?
R: Por engranaje metálico, bajo costo comercial, accesibilidad y facilidad de reemplazo modular en 32 actuadores.

2. ¿Cómo detecta el atasco si el motor no tiene sensor de temperatura?
R: El motor comercial NO tiene sensor térmico interno ni avisa que está forzado. En laboratorio caracterizamos su curva con termómetro láser y osciloscopio mecatrónico. En la pared final, la placa monitorea la corriente y el ESP32 corta la señal PWM tras 15 s para proteger la estructura de PLA.

3. ¿Cuánto cuesta frente a una pared comercial?
R: Una instalación comercial cuesta cientos de miles de pesos; SOFÍA cuesta una fracción gracias a impresión 3D y componentes IoT accesibles.

4. ¿Qué pasa con varias personas frente a la cámara?
R: Hoy prioriza a la persona más cercana al centro del encuadre; la siguiente etapa filtrará por usuario dominante.

5. ¿Cómo cierran la brecha hacia el espacio público real?
R: Con la PCB de potencia para 25 A, acoples mecánicos de desacople seguro y firmware con auto-recuperación.
