PaolaCV14/IOT-SOFIA-2026/paper/Equipo 1 - segundo corte/documents/Equipo1_Diferenciador.html

# Asignación: Diferenciador tecnológico del proyecto: PAOLA MONSERRAT COVARRUBIAS VIVEROS

A diferencia de sistemas de interacción robótica que utilizan detección de objetos mediante bounding boxes y control discreto de los actuadores, SOFIA integra la estimación geométrica de la mano mediante MediaPipe Hand Landmarker con el control de módulos mediante servomotores MG90S. Además, se analiza experimentalmente si la respuesta de estos servomotores corresponde realmente a un comportamiento bang-bang al seguir cambios de posición. El diferenciador se demostrará mediante pruebas de seguimiento, comparando la posición de la mano, el objetivo calculado y la respuesta angular y temporal de los servomotores.
