PaolaCV14/IOT-SOFIA-2026/plantilla_respuesta_LabDST/Equipo 0 - segundo corte/Equipo 0 - segundo corte.pdf

LABDST ROBOCOFFEE, ITESO, FALL 2026 | 1

# A Load-Cell Cup Detection Module for the RoboCoffee Delivery

# Fleet

Student A, Student B, Student C, Jorge A. Lizarraga and Graciela Baca

Abstract—This paper presents a cup detection module for the RoboCoffee intralogistics fleet. The module measures the load on the cup holder with a strain-gauge load cell and reports placement and removal events to the central platform. A threshold rule with hysteresis is proposed, and a preliminary test of 20 placement–removal cycles is reported.

Index Terms—Service robots, intralogistics, load cell, object detection, mobile robots.

I. INTRODUCTION
D
IFFERENTIAL-DRIVE mobile robots are a mature platform for indoor service tasks, since their kinematics and odometry are well understood [1]. In a coffee-delivery service, however, the robot must also know whether the order is still on board: a delivery is only complete when the client removes the cup.
When several robots share the same pool of orders, the waiting time of each client depends on how quickly a robot is released after each delivery, which can be analyzed with queueing models [2]. A robot that cannot confirm the removal of the cup either waits a fixed time, which wastes fleet capacity, or leaves too early, which risks returning with an undelivered order.
This work addresses the following research question: can a single load cell under the cup holder detect cup placement and removal reliably enough, and fast enough, to release the robot automatically at the end of each delivery?
The contributions of this paper are: (i) a low-cost detection module that uses a load cell and an ESP32 microcontroller; (ii) a threshold rule with hysteresis that rejects the vibration produced while the robot moves; and (iii) a test protocol that quantifies detection reliability and latency.

II. RELATED WORK
Radio-frequency identification (RFID) is a common way to detect tagged objects [3]. However, RFID requires a tag on every cup, which is not compatible with the disposable cups used in a cafeteria. Measuring the weight of the cup does not require any tag and also distinguishes an empty holder from a full or an empty cup.

III. MATERIALS AND METHODS
The architecture of the module is shown in Fig. 1. A 1 kg strain-gauge load cell supports the cup holder; an HX711 amplifier converts its signal at 80 Hz, and an ESP32 applies the detection rule and sends events to the central platform over Wi-Fi.

The authors are with the Department of Technological and Industrial Processes, ITESO, Tlaquepaque 45604, Jalisco, Mexico.

Load cell
1 kg

HX711
80 Hz

ESP32
rule (1)

Central
platform

Wi-Fi

Fig. 1. Architecture of the cup detection module.

TABLE I
TEST PROTOCOL
Cups tested | empty (12 g), full (250 g)
Cycles | 20 (this cut), 100 (next cut)
Metrics | detection rate, false events, latency

Let mk be the filtered mass at sample k. The state sk of 45 the holder changes only when the mass crosses one of two 46
thresholds: | 47

sk =

1, | mk > mon,
0, | mk < moff,
sk−1, otherwise,
(1) 48

with mon = 40 g and moff = 20 g. The gap between both 49 thresholds prevents false events caused by the vibration of the 50
holder while the robot moves. | 51
The test protocol is summarized in Table I. Each cycle 52 consists of placing a cup, moving the robot 3 m, and removing 53 the cup; the latency is the time between the removal and the 54
event received by the platform. | 55
IV. PRELIMINARY RESULTS | 56

In the 20 preliminary cycles with a full cup, all placements 57 and removals were detected and no false events occurred while 58 the robot was moving. The mean removal latency was 0.31 s. 59 These results correspond to a single cup type and a single 60 robot; the complete campaign of 100 cycles with both cup 61
types will be reported in the next cut. | 62
V. DISCUSSION AND LIMITATIONS | 63

An empty disposable cup (12 g) lies below moff, so the 64 current rule cannot distinguish an empty cup from an empty 65 holder. Camera-based detection could identify the cup inde- 66 pendently of its weight, but it would add an image-processing 67 pipeline and lighting requirements outside the scope of this 68
module; it is therefore left as future work. | 69
VI. CONCLUSIONS | 70

A load-cell module with a hysteresis rule detected cup 71 placement and removal in all preliminary cycles with a sub- 72 second latency, which supports its use to release RoboCoffee 73
robots automatically after each delivery. | 74

LABDST ROBOCOFFEE, ITESO, FALL 2026 2

75

REFERENCES

76 | [1] R. Siegwart, I. R. Nourbakhsh, and D. Scaramuzza, Introduction to
77 | Autonomous Mobile Robots, 2nd ed. Cambridge, MA, USA: MIT Press,
78 | 2011.
79 | [2] L. Kleinrock, Queueing Systems, Volume 1: Theory. | New York, NY,
80 | USA: Wiley, 1975.
81 | [3] R. Want, “An introduction to RFID technology,” IEEE Pervasive Com-
82 | puting, vol. 5, no. 1, pp. 25–33, 2006.
