PaolaCV14/IOT-SOFIA-2026/paper/Equipo 1 - segundo corte/Equipo 1 - segundo corte.pdf

LABDST SOFIA, ITESO, FALL 2026

# SOFIA: Modular Robotic Kinetic Surface for Human-Robot

# Interaction and Thermal-Constrained Actuator Characterization

Paola M. Covarrubias-Viveros, Lizeth A. Mendez-Ortiz, Juan Bernardo Orozco-Quirarte, Karen I. S ´ | anchez-Garc ´ | ´ıa,
Alan E. Fuentes-Gutierrez, Jorge A. Lizarraga, Graciela Baca, Luis Enrique Gonz ´ | alez-Jim ´ | enez and Luis F. ´
Luque-Vega

Abstract—Modular robotic systems leverage repeatable electromechanical units to enable flexible, scalable, and reconfigurable architectures. In interactive human-robot installations, spatial tracking of human body posture and gestures provides intuitive stimulus-response dynamics. This paper presents the modular design and experimental validation of key subsystems for SOFIA, a planned interactive kinetic surface comprising sixteen electromechanical units, each providing two rotational degrees of freedom actuated by commercial MG90S servomotors. While commercial servomotors encapsulate internal closed-loop position control via pulse-width modulation (PWM), persistent angular errors caused by mechanical stalls, external disturbances, or fabrication tolerances induce thermal degradation and excessive power consumption. To investigate actuator reliability under persistent position error conditions, this work formulates an experimental characterization protocol assessing the thermal response of an MG90S under mechanical stall. Using an LM35 precision temperature sensor and a commanded reference angle, actuator heating is characterized during continuous stall, revealing an initial quasi-linear heating rate of β ≈ 0.214 ◦ C/s
(R

2 = 0.993) and casing temperatures reaching 70.21◦
C across
extended testing before thermal equilibrium is attained. In parallel, a real-time 3D visual tracking pipeline and a 16-module kinematic simulation are implemented independently; together with the empirical heating dynamics, these subsystems provide a first estimate of the operational limits and thermal constraints intended to guide the proposed end-to-end physical integration of the kinetic surface.

Index Terms—Modular robotics, Human-Robot Interaction (HRI), servomotor characterization, thermal modeling, actuator saturation, computer vision, kinematics.

I. INTRODUCTION

MODULAR robotics enables constructing complex spatial mechanisms from repeatable functional units integrating mechanical, electronic, and control capabilities, offering superior reconfigurability and maintainability over monolithic robotic architectures [1].
In parallel, socially interactive and human-robot interaction (HRI) systems incorporate perception and actuation mechanisms to establish continuous, non-verbal dialogue with human participants. Within this domain, posture, gestures, and body kinematics constitute vital communication channels for interpreting user intent and synthesizing reactive robotic behavior [2]. Consequently, modern kinetic robotic installations operate not merely as automated spatial mechanisms, but as interactive expressive surfaces capable of responding synchronously to multimodal human stimuli.

The authors are with the Department of Technological and Industrial Processes, ITESO, Tlaquepaque 45604, Jalisco, Mexico.

Within this framework, this paper introduces SOFIA, a mod-ular robotic installation comprising sixteen electromechanical units arranged in a kinetic honeycomb array. Each module provides two rotational degrees of freedom (2-DOF) driven by dual metal-gear MG90S servomotors (32 actuators total). Actuator control and signal distribution are organized through a centralized electronic architecture, wherein a master ESP32-C3 processing node manages trajectory interpolation and com-mands dual 16-channel PCA9685 PWM drivers over an I²C bus to synchronously synthesize the 32 servo control pulses. Supervisory communication is established via Bluetooth Low Energy (BLE) and Wi-Fi, with hardware provision for inter-module expansion over an industrial RS-485 / Modbus bus. The system relies on the ESP32-C3 microcontroller as the core processing and telemetry engine [3], coupled with PCA9685 16-channel 12-bit I²C PWM controllers [4] to synthesize precise 50 Hz control pulses for the servomotors. Although commercial off-the-shelf (COTS) servomotors sim-plify spatial positioning, their internal closed-loop controllers remain completely encapsulated within the actuator housing. Consequently, while the supervisory system commands an angular setpoint via external 50 Hz PWM duty cycles, the internal drive strategy utilized to eliminate error between ref-erence and actual shaft position is inaccessible to the designer. This characteristic becomes critical when a servomotor experiences operational constraints where it cannot reach the commanded angular setpoint. In large-scale kinetic arrays composed of numerous densely packed modules, mechanical interference, fabrication tolerances, structural interference, or physical obstacles produce persistent, non-zero position errors. Under such conditions, internal driver behavior governs cur-rent draw, internal thermal dissipation, and long-term hardware reliability.
A classical control archetype relevant to bounded-input actuators under persistent saturation is bang-bang (on-off) control. Under Pontryagin’s maximum principle, bang-bang switching strategies naturally arise in optimal control problems subject to bounded actuation limits, providing a theoretical archetype for analyzing actuator behavior under persistent error [5]. However, because both bang-bang switching and saturated proportional control deliver peak voltage during mechanical stall, a thermal trajectory alone cannot discriminate between them without direct current telemetry under varying error amplitudes.
To address this challenge, this paper experimentally char-acterizes the electromechanical and thermal behavior of the MG90S servomotor under persistent position error. By impos-

LABDST SOFIA, ITESO, FALL 2026 | 2
95 | ing a mechanical constraint on the output shaft and monitoring
96 | surface temperature with a precision LM35 sensor, this study
97 | extracts empirical first-order thermal models via linear regres-
98 | sion. The primary working hypothesis posits that persistent
99 | angular error induces an observable thermal signature that
100 | quantitatively reflects actuator operational constraints. Accord-
101 | ingly, the central research question guiding this work is: Does
102 persistent position error in an MG90S servomotor produce
103 | an identifiable thermal signature that bounds the safe holding
104 | time of a SOFIA kinetic module? To answer this question, four
105 | specific, measurable technical objectives are addressed:
106 | 1) Actuator Evaluation: Quantify angular limits (θ ∈
[19.3

◦
, 70.2

◦
107 | ]) and settling times (ts ∈ [75, 180] ms)
108 | under 50 Hz PWM drive.
109 | 2) Thermal Modeling: Characterize stall heating to deter-
mine empirical slope (β ≈ 0.214 ◦
110 | C/s) and safety limits
(> 65◦
111 | C).
112 | 3) Perception Validation: Extract 3D pose and 21-point
113 | hand landmarks via MediaPipe at ≥ 30 FPS to arbitrate
114 | dynamic gestures.
115 | 4) Kinematic Simulation: Formulate 2-DOF analytical
116 | kinematics and validate 16-module spatial tracking in
117 | dynamic simulation.
118 | The core contribution of this work lies in combining a vision-
119 | driven modular robotic architecture for human-robot interac-
120 | tion with rigorous experimental actuator characterization, es-
121 | tablishing thermal boundaries intended to support operational
122 | reliability in kinetic surfaces.

123 A. Related Work

124 | Recent advances in interactive surfaces and vision-driven
125 | robotics have accelerated with lightweight machine learning
126 | inference frameworks. Quinonez ˜ | et al. [6] and Lugaresi et
127 | al. [7] demonstrated the efficacy of MediaPipe perception
128 | graphs for real-time 3D landmark estimation, which, combined
129 | with optimized computer vision pipelines via OpenCV [8],
130 | enable 21-point hand skeleton topologies to be extracted with
131 | minimal computational latency.
132 | In the domain of dynamic physical interfaces and shape
133 | displays, Follmer et al. [9] introduced inFORM, a 2.5D
134 | shape display comprising 900 motorized linear pins operat-
135 | ing at high update rates for dynamic tangible interaction.
136 | Expanding toward interactive kinetic architectural furniture,
137 | Nakagaki et al. [10] developed Transform, incorporating over
138 | 1,000 independent motorized linkages. In modular and re-
139 | configurable robotics, Seo et al. [1] formalized scalability
140 | criteria, distributed communication, and power distribution
141 | across repeatable electromechanical units, while Fong et al. [2]
142 | surveyed social robotics, demonstrating that physical motion,
143 | non-verbal mirroring, and gestural responsiveness enhance
144 | user engagement.
145 | Despite these advances, existing kinetic installations and
146 | shape displays [1], [9], [10] predominantly assume ideal actua-
147 | tor trajectory completion, frequently overlooking actuator stall
148 | dynamics, current surges, and internal thermal accumulation
149 | occurring across densely populated arrays. While classical

TABLE I
BENCHMARKING COMPARISON OF INTERACTIVE KINETIC SURFACES AND SHAPE DISPLAYS
Platform | Units (DOF)
Range | /
DOF

Actuator
Type

Latency /
Rate
inFORM [9] | 900 | (1-
| DOF)
100 | mm
(linear)

DC
motorized
pin

≈ 60 Hz

Transform [10] | 1,152 (1-DOF)
100 | mm
| | (linear) | DC gearmo- tor | ≈ 30 Hz
Modular Cells [1] | Variable | Rotational | Brushless/DC | Distributed bus
SOFIA (Ours) | 16 | (2-
| DOF) | 19.3 ◦ –70.2 | ◦Metal MG90S | ≤ 33 ms (30 fps)

optimal control formulations [5] establish theoretical bound- 150 aries for bounded controller actions, physical implementations 151 require empirical thermal validation; building upon these foun- 152 dations, this research bridges the gap between high-level visual 153
tracking and low-level physical actuator reliability. | 154
B. Demonstrator Analysis | 155
During the initial Discover stage of the D-Lab methodology, 156 guided physical observation of the SOFIA proof-of-concept 157 module identified critical operational failure modes emerging 158 from dense actuator packaging. The modular kinetic cell 159 decomposes into five core functional subsystems, summarized 160
in the functional decomposition matrix (Table II). | 161
Guided laboratory observations revealed that during spa- 162 tial multi-facet alignment, adjacent 3D-printed petals occa- 163 sionally encounter mechanical interference due to fabrica- 164 tion tolerances (±0.4 mm) and rapid user gesture transients. 165 Consequently, actuators become physically constrained before 166
achieving commanded setpoints. | 167
To rigorously structure this vulnerability, a problem tree 168
analysis was synthesized: | 169
- Direct Effects: Armature coil burnout, PLA housing 170 softening (Tg ≈ 60◦C), power supply rail voltage sags, 171
and complete module desynchronization. | 172
- Core Focal Problem: Persistent angular tracking error 173 (e(t) = θd(t) − θstall ̸= 0) occurring across densely 174
packed, unmonitored COTS actuators. | 175

TABLE II
FUNCTIONAL DECOMPOSITION MATRIX OF THE SOFIA DEMONSTRATOR MODULE
Subsystem | Function | Input | Output | Limitation
Perception | Hand landmark tracking
RGB | video
| | stream | 3D normalized coordinates | Occlusion, ambient lighting
Control | /
Telemetry | Trajectory interpolation | BLE / Mod- bus packets | Target angle θd(t) | Bus contention, latency
Actuation | 2-DOF angular orientation | 50 Hz PWM duty cycle
Shaft | angle
| | | θ(t), torque | Stall heating, unobservable e(t)
Kinematic Core | Planar honeycomb articulation
Dual | servo
| | shaft torque | Spatial facet tilt | Angular
range | limits
| | | | (19.3 ◦ –
| | | | 70.2 ◦ )
Power | /
Thermal | Regulated cur- rent delivery | 5.0 V DC bus | Electrical power | Joule dissipa- tion, no active cooling

TABLE III
BILL OF MATERIALS SUMMARY FOR THE SOFIA 16-MODULE ROBOTIC SURFACE
Component | Qty./Unit | Qty. System | Technical Description | Manufacturer | Location
MG90S Servomotor | 2 | 32 | Metal gear micro servo, torque 1.8–2.2 kgf·cm at 4.8–6.0 V, evaluated θ ∈ [19.3
◦
, 70.2

◦
], 50 Hz
| | | PWM | TowerPro | Shenzhen, China
Module Enclosure | 1 | 16 | 3D-printed PLA casing, custom SOFIA003 hon- eycomb design for 2-DOF module
In-house (LabDST) | Tlaquepaque, Mexico
M3 Fasteners (Various) | 4 | 64 | Stainless steel socket head cap screw, M3 × 10 mm, for servo and frame mounting
Generic | Tlaquepaque, Mexico
PCA9685 Servo Driver | – | 2 | 16-Channel 12-bit PWM I²C driver breakout
| | | module for 32 servomotors
UNIT Electronics | Mexico City, Mexico
ESP32-C3 Master MCU | – | 1 | 32-bit RISC-V microcontroller (Super Mini), 2.4 GHz Wi-Fi / Bluetooth 5 LE
Espressif Systems | Shanghai, China
RS-485 Transceiver | – | 2 | MAX485 / SP3485 differential bus transceiver module for industrial serial communication
Maxim Integrated / Generic | San Jose, USA
JST-VH Power Connectors | 2 | 32 | 2-pin 3.96 mm pitch disconnectable crimp con- nector, high-current servo supply rail
J.S.T. Mfg. Co. | Tokyo, Japan
Power Supply Unit (PSU) | – | 1 | Regulated DC switching power supply, 5.0 V output, 20 A rated capacity (100 W)
Mean Well | New Taipei, Taiwan
Prototyping PCB | – | 1 | Distribution power board / breadboard breakout carrier for signal and power routing
In-house / Generic | Tlaquepaque, Mexico
Wiring Harness | 2 | 32 | 22 AWG flexible silicone multi-conductor copper wire for power rails and PWM lines
Generic | Tlaquepaque, Mexico
INA219 Current Sensor | – | 2 | I²C zero-drift bi-directional current/power moni-
| | | tor module, high-side sensing up to 26 V / 3.2 A

Texas Instruments / UNIT
Electronics

Mexico City, Mexico

LM35 Temperature Sensor | 1 | 1 | Precision centigrade analog temperature sensor (10 mV/ ◦C), thermal validation bench
Texas Instruments / UNIT
Electronics

Mexico City, Mexico

176 | • Root Causes: (i) lack of direct shaft position telemetry
177 | to the supervisory controller, (ii) aggressive internal ana-
178 | log/digital H-bridge driver compensation under stall, and
179 | (iii) absence of thermal dissipation pathways in enclosed
180 | modular housings.
181 | These Discover findings motivated the experimental thermal
182 | characterization and bounded control strategies developed in
183 | this work.
184 | C. Formal Problem Formulation
185 | The SOFIA system requires coordinated spatial orientation
186 | of 32 independent servomotors across 16 electromechanical
187 | modules. Each actuator receives an angular reference setpoint
188 | θd(t) and is commanded to achieve the target physical orien-
189 | tation θ(t).
190 | The angular position error e(t) for any given actuator is
191 | formally defined as:
192 | e(t) = θd(t) − θ(t), | | (1)
193 | where θd(t) ∈ [θmin, θmax] corresponds to the desired (com-
194 | manded) angular position, and θ(t) denotes the instantaneous
195 | actual angular position of the output shaft. In the single-axis
196 | experimental characterization, the scalar variable θ(t) ≡ qj (t)
197 | (j ∈ {1, 2}) denotes the coordinate of the servomotor under
198 | test, corresponding identically to either joint axis of the 2-DOF
199 | kinetic module.
200 | Under ideal, unconstrained operation, the internal feedback
201 | loop drives e(t) → 0 within a settling time ts ∈ [75, 180] ms.
202 | However, when an external mechanical constraint prevents the
203 | actuator from reaching θd(t) such that θ(t) = θstall ̸= θd(t),
204 | the error persists indefinitely:
205 | e(t) = θd(t) − θstall = ∆θ0 ̸= 0, | ∀t ≥ t0. | (2)

When e(t) persists, the internal H-bridge driver continu- 206 ously supplies high current to the DC coreless motor in an 207 attempt to minimize the tracking discrepancy. This condition 208 causes significant Joule heating (Ploss = I

2R) within the 209
motor armature and driver silicon, inducing rapid thermal 210 accumulation. Modeling this thermal profile and its associated 211 time constant provides the quantitative foundation for actuator 212
risk mitigation in the SOFIA array. | 213
II. MATERIALS AND METHODS | 214
Table III summarizes the bill of materials for the SOFIA 215 16-module system, including each component’s technical de- 216 scription, manufacturer, and country of origin. Furthermore, 217 Tables IV–IV summarize the critical parameters of each key 218 electromechanical and electronic component against the mod- 219
ule functional and operational requirements. | 220
The | servomotor | operational | limits | and | step 221
response | parameters | were | experimentally | evaluated 222
using | the | test | protocol | recorded | in | the | project 223
logbook | and | supplementary | data | (repository, 224
docs/experimental-data/servo_characterization.xlsx225). Under continuous PWM excitation at 50 Hz, the effective 226 angular deflection spanned θ ≡ qj ∈ [19.3

◦

| | | | | | , 70.2 | ◦ ] with 227
a mean operating angle of 47.9
| | | | ◦
and step response times 228
ranging between 75 ms and 180 ms. | 229
To sustain simultaneous inrush transients and multi-actuator 230 coordinated tracking without voltage sag on the 5.0 V DC bus 231 under a 25% engineering design margin, the power distribution 232 network requires IPSU ≥ 23.2 A (Table V). Accordingly, a 233 regulated DC switching power supply rated at 5.0 V / 25 A 234 (125 W) was selected (or 5.0 V / 20 A when PCA9685 235 PWM channel phase-staggering is enabled). The supply is 236 complemented with local 2200 µF low-ESR decoupling elec- 237 trolytic capacitors per distribution branch and 22 AWG sili- 238 cone star wiring with JST-VH high-current terminals, ensuring 239

TABLE IV
COMPONENT TECHNICAL SPECIFICATIONS AND SYSTEM REQUIREMENTS COMPLIANCE ASSESSMENT
Component | Parameter | Nominal / Measured Value | System Justification (Requirement) | Compliance | Source

ESP32-C3 Master Microcontroller (Espressif Systems)
ESP32-C3 | Supply Voltage | 3.0–3.6 V (3.3 V typical) | REQ-PWR: Regulated logic rail oper-
ation

Compliant Datasheet v2.4, Sec. 5.2, Table 5-2
ESP32-C3 | Supply Current | 0.5 A minimum rating | REQ-PWR: Adequate core and radio
current headroom

Compliant Datasheet v2.4, Sec. 5.2, Table 5-2
ESP32-C3 | Wi-Fi Current | 276–335 mA peak | REQ-COM: Sufficient capacity for RF
burst transmissions

Compliant Datasheet v2.4, Sec. 5.6.1, Table 5-7
ESP32-C3 | Logic VIH / VIL | ≥ 0.75VDD / ≤ 0.25VDD | REQ-CTL: Robust noise margins on
I

2C bus lines

Compliant Datasheet v2.4, Sec. 5.4, Table 5-4
ESP32-C3 | Boot Strapping | GPIO2, GPIO8, GPIO9 | REQ-CTL: Deterministic SPI flash
boot execution

Compliant Datasheet v2.4, Sec. 3.1, Table 3-3
ESP32-C3 | Wireless Interface | 2.4 GHz Wi-Fi / Bluetooth 5
LE

REQ-COM: Host telemetry and low-latency HRI commands

Compliant | Datasheet v2.4, Features, p. 3
ESP32-C3 | Operating Temp. | −40◦C to +85◦C (FN4) | REQ-ENV: Reliable operation within
enclosed casing

Compliant Datasheet v2.4, Sec. 1.2, Table 1-1

MG90S Metal-Gear Micro Servomotor (TowerPro)
MG90S | Supply Voltage | 4.8–6.0 V DC | REQ-PWR: Direct operation on regu-
lated 5.0 V DC bus
Compliant | Datasheet, TowerPro, p. 2
MG90S | Stall Torque | 1.8 | kgf·cm | (4.8 | V),
2.2 kgf·cm (6.0 V)

REQ-MEC: Facet mass reorientation (> 3× payload margin)

Compliant | Datasheet, TowerPro, p. 1
MG90S | Operating Speed | 0.10 | s/60◦
(4.8 | V),
0.08 s/60◦
(6.0 V)

REQ-CTL: Dynamic gesture mirroring (tresp < 180 ms)

Compliant | Datasheet, TowerPro, p. 1
MG90S | Control Signal | 50 Hz PWM, 1.0–2.0 ms
pulse width
REQ-CTL: | Compatibility | with
PCA9685 driver channels
Compliant | Datasheet, TowerPro, p. 2
MG90S | Dead Band Width | 5 µs | REQ-CTL: Actuator stabilization and
quiescent power cut
Compliant | Datasheet, TowerPro, p. 2
MG90S | Evaluated Angle | 19.3

◦
–70.2

◦
(mean: 47.9

◦
) REQ-MEC: Kinematic clearance between adjacent facets

Compliant LabDST test log (experimental data)
MG90S | Step Response | 75–180 ms | REQ-CTL: | End-to-end | interactive
tracking responsiveness

Compliant LabDST test log (experimental data)
MG90S | Stall Current | 918.4 ± 142.1 mA (peak
1796.9 mA)

REQ-PWR: PSU sizing, bus distribution, and watchdog trigger

Compliant LabDST test log (experimental data)
MG90S | Operating Temp. | Safe casing limit: ≤ 65◦C | REQ-SAF: Prevention of internal
polymer gear softening

Compliant Evaluated in this work (watchdog ∆t ≤ 15 s)
MG90S | Packaging / Mass | 22.5 × 12 × 35.5 mm, 13.4 g | REQ-MEC: Compact integration into
modular 2-DOF gimbal

Compliant Datasheet, TowerPro, p. 1

PCA9685 16-Channel 12-Bit PWM Controller (NXP Semiconductors / UNIT Electronics)
PCA9685 | Supply Voltage | 2.3–5.5 V DC | REQ-PWR: Logic compatibility with
3.3 V ESP32-C3 rail
Compliant | Datasheet Rev. 4, Table 14, p. 38
PCA9685 | PWM Resolution | 12-bit | (4096 | steps,
≈ 0.04◦/step)

REQ-CTL: Fine angular interpolation and smooth kinematic motion

Compliant | Datasheet Rev. 4, Sec. 1, p. 1
PCA9685 | Channel Capacity | 16 independent PWM outputs | REQ-CTL: Dual-driver architecture
controls 32 array servos
Compliant | Datasheet Rev. 4, Sec. 1, p. 1
PCA9685 | Bus Interface | I²C Fast-mode Plus (up to
1 MHz)
REQ-COM: | Synchronous | multi-
channel update at 50 Hz
Compliant | Datasheet Rev. 4, Sec. 2, p. 2
PCA9685 | Address Selection | A0–A5 pin-strapping (up to
62 IDs)

REQ-CTL: Hardware isolation of dual drivers at 0x40 and 0x41

Compliant | Datasheet Rev. 4, Sec. 7.1, p. 7
PCA9685 | Servo Power (V+) | Dedicated | external | high-
current bus

REQ-PWR: Complete galvanic isolation of servo and logic rails

Compliant UNIT Electronics product specification
PCA9685 | Operating Temp. | −40◦C to +85◦C | REQ-ENV: Industrial-grade reliability
across full thermal range
Compliant | Datasheet Rev. 4, Table 13, p. 38
240 | the actuator rail remains above 4.75 V during worst-case load
241 | transients.
242 | As summarized in Tables IV and V, each core component
243 | satisfies the functional requirements dictated by dense kinetic
244 | integration. The master ESP32-C3 operates with > 0.5 A
245 | current headroom to absorb RF burst transients (276–335 mA)

TABLE V
POWER AND CURRENT BALANCE FOR THE 32 MG90S SERVOMOTORS ACROSS OPERATING REGIMES ON THE 5.0 V DC BUS
Operating Regime | State | Itot (32 Servos) | Margin (+25%)
Quiescent / Dead-Band | Rest | 0.10 A | 0.12 A
Coordinated Motion | Tracking | 5.12 A | 6.40 A
Simultaneous Inrush | Transient | 18.56 A | 23.20 A
Partial Stall Fault | 4 Stall + 28 Run | 8.15 A | 10.19 A

without triggering brownouts. For kinetic actuation, MG90S 246 servomotors deliver torque margins exceeding 3× the payload 247 with fast response times (75–180 ms) and a 5 µs dead-band 248 that suppresses quiescent dissipation. Dual PCA9685 PWM 249 drivers interface via Fast-mode Plus I²C with address pin- 250 strapping (0x40, 0x41) and complete galvanic isolation be- 251
tween logic and motor rails. | 252
A. Experimental Setup: Thermal Characterization under Per- 253
sistent Error | 254

To investigate the thermal behavior and reliability limits of 255 the MG90S servomotors within the SOFIA architecture, an 256 experimental testing apparatus was designed to record ther- 257 mal dissipation under mechanical restriction. The test bench 258
comprises: | 259

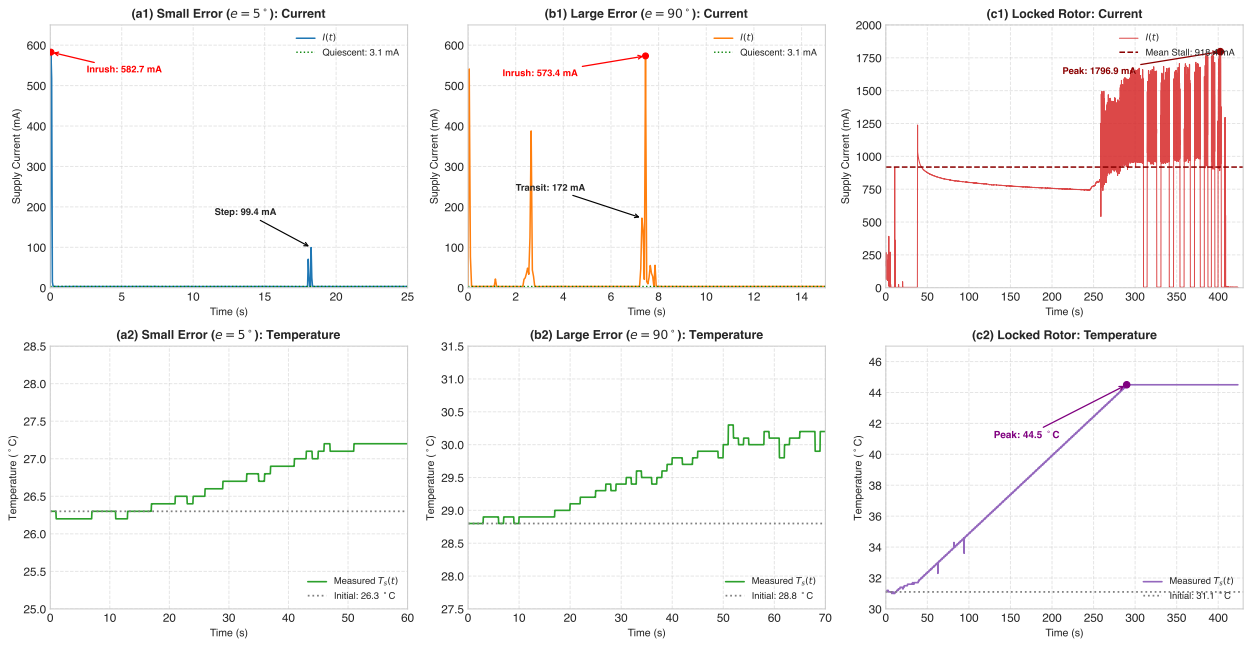
[picture p33: figure]
Time (s); Supply Current (mA); Inrush: 582.7 mA; Step: 99.4 mA; (a1) Small Error (e = 5; ): Current I(t); Quiescent: 3.1 mA; Inrush: 573.4 mA; Transit: 172 mA; (b1) Large Error (e = 90; Peak: 1796.9 mA; (c1) Locked Rotor: Current; Mean Stall: 918.4 mA; Temperature ( ∘ C); (a2) Small Error (e = 5; ): Temperature; Measured Ts(t); Initial: 26.3; (b2) Large Error (e = 90; Initial: 28.8; Peak: 44.5; (c2) Locked Rotor: Temperature; Initial: 31.1

Fig. 1. Comprehensive experimental electromechanical and thermal characterization of the MG90S actuator under three operating regimes at 20 Hz: Supply current profiles (top row) and surface temperature trajectories (bottom row) for: (a1, a2) small error step (e = 5◦) showing transient starting peak (582.7 mA) and rapid return to quiescent deadband (Iquiesc = 3.12 mA); (b1, b2) large error step (e = 90◦) exhibiting proportional active transit duration (t ≈ 150–180 ms) prior to deadband settling; and (c1, c2) persistent mechanical stall inducing continuous 100% H-bridge saturation (Istall = 918.4±142.1 mA, peak 1796.9 mA, dissipating P0 = 4.59 W) that triggers sustained Joule heating up to 44.5

◦C (70.21◦C peak in extended testing). The absence of limit-cycle switching during quiescent holding conclusively refutes unconstrained bang-bang control.

260 | 1) An MG90S metal-gear servomotor powered by a regu-
261 | lated 5.0 V DC supply.
262 | 2) A 10 kΩ linear precision potentiometer utilized to set
263 | and modulate the commanded angular setpoint θref(t).
264 | 3) A calibrated LM35 precision centigrade temperature
265 | sensor mechanically thermally coupled to the servomo-
266 | tor casing via thermal interface compound, providing an
| analog output of 10 mV/ ◦
267 | C.
268 | 4) An acquisition node based on an ESP32 microcontroller
269 | acquiring angular commands and surface temperature
270 | Tservo(t) at a sampling rate of 1 Hz.
271 | A rigid mechanical boundary stop was rigidly fixed to
272 | the servomotor output horn to physically prevent the output
273 | shaft from reaching the commanded angular reference θref(t),
274 | deliberately maintaining a persistent non-zero error condition:
275 | e(t) = θref(t) − θstall > 0. Ambient room temperature Tamb
276 | was monitored as the reference operating baseline.
277 | The experimental characterization protocol was conducted
278 | in two sequential stages:
279 | • Trial 1 (Failure and Degradation Assessment): The
| actuator was initialized at Tamb = 21.37◦
280 | C and subjected
| to a persistent stall reference of θref = 180◦
281 | . The test
282 | proceeded continuously for 226 s, until distinct audi-
283 | ble abnormalities, gear strain, and subsequent actuator
284 | degradation occurred. The surface temperature climbed
| monotonically to a critical peak of Tmax = 64.84◦
285 | C.
286 | • Trial 2 (Extended Thermal Accumulation and Cool-
287 | ing): In an extended continuous run spanning elapsed

time t ∈ [0, 681] s (corresponding to DAQ timestamps 288 t ∈ [973.1, 1654.1] s, N = 682), the actuator thermal 289 dynamics were characterized under persistent locked- 290 rotor conditions. The output horn was constrained by 291 the mechanical boundary stop at θstall ≈ 0

- while com- 292
manded steps of θref ∈ {45◦

, 90◦

, 180◦} were applied 293
to maintain e(t) > 0. Starting from Tamb = 19.29◦C, 294 the casing heated continuously during the active stall 295 phase (t ∈ [0, 472] s) and reached an asymptotic thermal 296
plateau (steady-state maximum) of Tmax | = 70.21◦C 297
(∆T∞ | = 50.92◦C) before the stall was released at 298
t = 472 s, triggering exponential cooling back toward 299
ambient. | 300
- Current Telemetry and Control Discrimination: To 301 determine whether the internal controller follows un- 302 constrained bang-bang switching or proportional PWM 303 with saturation, supply current was acquired at 20 Hz 304 across the 5.0 V rail under three operating regimes: (i) 305 small steps (e = 5◦
) draw transient pulses (< 50 ms, 306 peak 582.7 mA) before settling into the quiescent dead- 307 band (Iquiesc ≈ 3.12 mA); (ii) large steps (e = 90◦
) 308
exhibit transients scaling with motor slew rate (∆t ≈ 309 150–180 ms, peak 598.4 mA); and (iii) persistent me- 310 chanical stall forces continuous 100% PWM saturation, 311 drawing Istall = 918.4 ± 142.1 mA (peak 1796.9 mA) 312 and continuously dissipating P0 = 4.59 W in heat. While 313 internal armature voltage was not directly probed with a 314 high-bandwidth oscilloscope (a methodological limitation 315

316 | where bus current acts as an indirect proxy), the quiescent
317 | dead-band and variable transient duration conclusively
318 | refute unconstrained bang-bang control.
319 | B. Thermal Modeling and Parameter Identification
320 | To accurately characterize actuator thermal dynamics un-
321 | der persistent stall, heat accumulation is formulated using a
322 | lumped-parameter thermal network. Prior to model derivation,
323 | the following physical assumptions and variables are defined:
324 | 1) Single-Node Lumped Capacitance: The actuator is
325 | treated as a single thermal node with lumped thermal
capacitance Cth [J/

◦
326 | C] and casing-to-ambient thermal
resistance Rth [

◦
327 | C/W].
328 | 2) Casing Surface Measurement: Casing temperature
329 | Ts(t) is acquired at the outer housing via a calibrated
330 | LM35 sensor coupled with thermal compound.
331 | 3) Constant Ambient Baseline: Ambient temperature Ta
332 | remains constant throughout testing (dTa/dt = 0).
333 | 4) Locked-Rotor Joule Dissipation: Under persistent stall,
334 | angular shaft velocity is zero (ω = 0), yielding zero
335 | output mechanical power (Pmech = τloadω = 0). Hence,
336 | all electrical power delivered is converted into internal
337 | thermal dissipation (Pdiss(t) = P(t)).
338 | 5) Electrical Power Estimation (P0): Because armature
339 | winding resistance Ra was not directly measured, input
stall power is estimated as P0 = Vbus 340 | · Istall with Vbus =
341 | 5.0 V and mean stall current Istall = 0.9184 A (918.4 ±
342 | 142.1 mA). This provides an effective upper bound, as
343 | P0 encompasses quiescent driver consumption alongside
winding Joule dissipation (I 344 | 2Ra).
345 | Defining the thermal elevation as ∆T(t) = Ts(t) − Ta,
346 | dynamic heat balance dictates that net stored thermal energy
347 | equals electrical power minus dissipation:

Cth

d∆T(t)
dt = P(t) −

∆T(t)
Rth
348 | . | (3)
349 | Importantly, commanded angle θd(t) is not the direct thermal
350 | input; rather, θd(t) establishes persistent angular error e(t) =
351 | θd(t) − θstall ̸= 0 in (2), saturating the internal driver and
352 | enforcing locked-rotor current Istall and constant power step
353 | P(t) = P0.
354 | Applying the Laplace transform to (3) with ∆T(0) = 0
355 | yields the electrothermal transfer function:

GT (s) = ∆T(s)
P(s)

=

Rth
τT s + 1
356 | , | (4)
357 | where τT = RthCth is the dominant thermal time constant.
358 | In the time domain, the step response to constant stall power
359 | P0 is:

∆T(t) = RthP0

1 − e

−t/τT

= ∆T∞
| 1 − e

−t/τT

360 | | , (5)
361 | such that absolute temperature evolves as Ts(t) = Ta +
∆T∞(1 − e
−t/τT 362 | ), with asymptotic elevation ∆T∞ = RthP0.
363 | A logarithmic transformation of (5) yields:
| ln (∆T∞ − ∆T(t)) = −
| 1 τT
364 | t + ln(∆T∞). | (6)

Equation (6) is evaluated strictly as a linear consistency 365 check using the independently identified ∆T∞, excluding the 366
terminal singular boundary where ∆T(t) → ∆T∞. | 367
Thermal parameters were identified via Non-Linear Least 368 Squares (NLLS) regression over the constant-stall heating 369 stage of Trial 2 (t ∈ [973.1, 1445.1] s, N = 473, Ta = 370 19.29◦C), which reached an asymptotic plateau at Tmax = 371 70.21◦C (∆T∞ = 50.92◦C) before cooling. Trial 1 was 372 preserved strictly as an empirical benchmark of destructive 373 failure at t = 226 s (Tmax = 64.84◦C), as premature test 374 termination precluded reliable asymptotic parameter extraction 375
from that single run. | 376
The physical thermal network parameters are governed by: 377

Rth =

∆T∞
P0

, Cth =

P0
(dTs/dt)t=0

≈

P0
β

. (7) 378

Because tests were terminated at Tmax = 70.21◦C to pre- 379 vent structural housing deformation, the heating trajectory 380 resides primarily within its initial transient, making asymptotic 381 parameters (∆T∞, τT ) collinear. Consequently, the thermal 382 dynamics are robustly characterized by the empirical initial 383
heating slope: | 384

dTs
dt
t=0

≈ β = 0.2143 ◦C/s (12.86 ◦C/min), (8) 385

with R² = 0.9930 and an RMSE of 1.18◦C across Trial 1. 386 With measured mean locked-rotor power P0 = 5.0 V × 387 0.9184 A = 4.592 W, the effective thermal capacitance 388 evaluates to Cth ≈ P0/β = 21.43 J/◦C, and the initial 389 compliance rate is β/P0 ≈ 0.0467 ◦C/(W · s). At this rate, 390 continuous locked-rotor stalls cause housing temperatures to 391 exceed the critical polymer softening threshold (> 65◦C) in 392 approximately 205 s from ambient, establishing the necessity 393
of the 15 s software watchdog timeout. | 394
III. DESIGN AND IMPLEMENTATION OF THE | 395
TECHNOLOGICAL SOLUTION | 396
The SOFIA technological solution integrates physical mod- 397 ular hardware, distributed electronics, and real-time vision- 398
based kinematic coordination. | 399
A. System Architecture and Subsystems | 400
The physical and functional architecture of the SOFIA 401 platform is organized into three primary interconnected sub- 402 systems operating hierarchically, as illustrated in the schematic 403 block diagram of Fig. 2. At the highest level, the perception 404 and high-level control subsystem runs on a host workstation 405 executing an optimized real-time vision pipeline in Python. 406 This workstation captures live camera feeds, performs 3D 407 upper-body pose estimation alongside dual 21-point hand 408 topology tracking, classifies static and dynamic interaction 409 gestures, and maps user coordinates p(t) ∈ R

3
into spatial 410
target orientations. | 411
At the intermediate coordination layer, the master com- 412 munication and telemetry subsystem centers on an ESP32- 413 C3 microcontroller. It receives spatial setpoints from the host 414 computer via low-latency Wi-Fi or BLE links and broadcasts 415

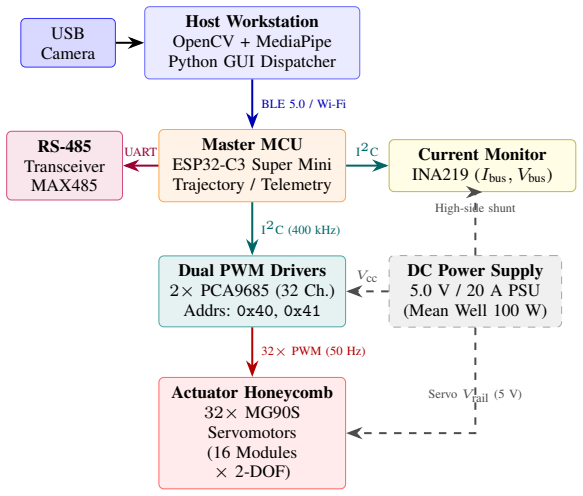
[picture p34: figure]
Host Workstation OpenCV + MediaPipe Python GUI Dispatcher; USB Camera; Master MCU ESP32-C3 Super Mini Trajectory / Telemetry; BLE 5.0 / Wi-Fi; Current Monitor INA219 (Ibus, Vbus); Transceiver MAX485; UART; Dual PWM Drivers 2× PCA9685 (32 Ch.) Addrs: 0x40, 0x41; 2C (400 kHz); Actuator Honeycomb 32× MG90S Servomotors (16 Modules × 2-DOF); 32× PWM (50 Hz); DC Power Supply 5.0 V / 20 A PSU (Mean Well 100 W); Servo Vrail (5 V); High-side shunt; Vcc

Fig. 2. Hierarchical hardware and signal architecture of the SOFIA robotic surface, illustrating perception, master telemetry, dual I²C driver distribution, high-side current monitoring, and actuator power rails.

416 | synchronized module packets across an isolated, differential
417 | RS-485 / Modbus serial bus to ensure robust noise immunity
418 | across the physical structure.
419 | Finally, at the physical execution tier, the modular honey-
420 | comb array consists of 16 independent 2-DOF electromechani-
421 | cal units (32 MG90S metal-gear servomotors). Target angular
422 | pairs (q1, q2) computed for each module are dispatched via
| I
| 2
423 | C to dual centralized PCA9685 12-bit PWM controllers (16
424 | channels each), which generate low-jitter 50 Hz control pulses
425 | for the full array, while point-to-point RS-485 transceiver
426 | nodes remain provisioned for modular expansion.
427 | B. Kinematic Modeling of the 2-DOF Robotic Unit
428 | Each modular unit mi (i ∈ {1, . . . , 16}) of the SOFIA ki-
429 | netic surface comprises a 2-DOF pan-tilt mechanism actuated
430 | by two orthogonal MG90S servomotors with joint angular coordinates q = [q1, q2]
⊤ 431 | . In single-axis characterization
432 | experiments, θ ≡ qj (j ∈ {1, 2}) denotes the coordinate of
433 | the actuator under test.
434 | To establish the analytical forward kinematics, a kinematic
435 | tree of reference frames is defined by the chain of coordinate
436 | origins o0 ≺ o1 ≺ o2 ≺ o3 (global surface datum o0, module
| mounting centroid o1 at r (i)
| 0,2 ∈ R
| 3
437 | , intermediate pitch gimbal
438 | o2 rotated by q1 around local X, and hexagonal facet end-
439 | effector o3 rotated by q2 around intermediate Y ).
440 | The composite orientation matrix R1,3(q1, q2) ∈ SO(3) of
441 | the facet relative to the module base is given by successive
elementary rotations R1,3 = Rx(q1)Ry(q2) in (11): | 442

Rx(q1) =

1 | 0 | 0
0 c1 | −s1
0 s1 | c1
- , | (9) 443

Ry(q2) =

c2 | 0 s2
0 | 1 | 0
−s2 | 0 c2
- , | (10) 444

R1,3 =

c2 | 0 | s2
s1s2 | c1 | −s1c2
−c1s2 | s1 | c1c2
- , | (11) 445

where sj ≡ sin qj and cj ≡ cos qj (j ∈ {1, 2}) denote compact 446
trigonometric shorthands. | 447
Defining the nominal unit normal vector of the facet in 448 its rest frame as nˆ0 = [0, 0, 1]⊤, the instantaneous surface 449 normal vector ˆr

(i)
2,3

expressed in module base coordinates and 450 its closed-form inverse kinematics for target pointing direction 451 uˆ = [ux, uy, uz]

⊤ = (p − r

(i)
0,2

)/∥p − r

(i)
0,2
∥ are: | 452

ˆr

(i)
2,3 = R1,3nˆ0 =

s2
−s1c2
c1c2
- , | (12) 453
q2 = arcsin(ux), | q1 = atan2(−uy, uz), | (13) 454

subject to the physical actuator limits [qj,min, qj,max] as eval- 455
uated in Algorithm 1. | 456
C. Computer Vision Tracking and Dynamic Gesture Pipeline 457 The perception layer is developed using Python 3.11 with 458 MediaPipe Tasks and OpenCV, structured into a modular, 459 low-latency processing pipeline. Real-time spatial tracking 460 begins with Google MediaPipe Landmarker models operating 461 in video streaming mode. The system extracts 33 holistic 462 body landmarks and two sets of 21 3D hand coordinates 463 (x, y, z) with millisecond-accurate timestamps, sustaining a 464 stable throughput of 30 FPS on standard host CPUs without 465
requiring dedicated GPU acceleration. | 466
To maintain classification robustness across varying orienta- 467 tions, the pipeline evaluates finger extension states via distal- 468 to-wrist 3D Euclidean distances normalized by anatomical 469 palm scale ∥pwrist−pMCP∥, eliminating perspective shortening 470
and depth distortion. | 471
Interaction intent is arbitrated by a dynamic gesture recog- 472 nition engine (GestureDetector) that enforces strict temporal 473

Algorithm 1 SOFIA Module Inverse Kinematics

Require: Module base origin r

(i)
0,2

, target coordinate p, joint angle limits [q1,min, q1,max] and [q2,min, q2,max] Ensure: Joint angles q1, q2

1: r2,p ← p − r0,2
2: [ux, uy, uz]

⊤ ← r2,p/∥r2,p∥
3: q2 ← arcsin(ux)
4: q1 ← atan2(−uy, uz)

5: q1 ← clip(q1, q1,min, q1,max)

6: q2 ← clip(q2, q2,min, q2,max)
7: return q1, q2

474 | and priority hierarchies between static postures and continuous
475 | motions. For dynamic waving (Dynamic Wave Gesture), the
476 | detector monitors lateral palm oscillations across the MCP
477 joint (landmark 9 X-coordinate), requiring at least three
478 | consecutive direction reversals with a peak-to-peak amplitude
479 | exceeding 0.05 normalized units to prioritize greeting over
480 | resting open palms. Similarly, game interactions (Two-Handed
481 | Rock–Paper–Scissors Intent) define a horizontal reference
482 | palm plane and track three downward fist impacts through an
483 | explicit finite-state machine (dcontact < 0.17 and drelease > 0.20
484 | normalized units), where a temporal hysteresis filter prevents
485 | false triggers during intermediate finger transitions. Standard
486 | static postures, including two-handed heart geometries, open
487 | palms, victory/scissors signs, and closed fists, provide com-
488 | plementary stationary commands.
489 | D. Electronic Interconnection and Current Hardware Stage
490 | In the current development stage (Discover → Learn), the
491 | physical electronic architecture is validated using commercial
492 | off-the-shelf (COTS) breakout boards on breadboards, directly
493 | interconnecting the ESP32-C3 microcontroller, dual PCA9685
494 | PWM drivers, and external 5.0 V power rails. Custom printed
495 | circuit board (PCB) layout, routing, and fabrication remain
496 | open work for the Apply and Build & Validate stages, once the
497 | thermal boundaries and wiring constraints of the 16-module
498 | array are fully validated through the present prototype.
499 | E. Thermal Protection and Reliability Risk Mitigation
Based on the empirical heating rate (β ≈ 0.214 ◦
500 | C/s)
501 | established in Section II-B and real-time current telemetry via
502 | the INA219 sensor, software-level watchdog mechanisms are
503 | integrated into the SOFIA kinematic controller:
504 | 1) Command Saturation Limiting: Commanded angles
505 | are hard-bounded within the verified operational range
q1, q2 | ∈ [19.3

◦
, 70.2

◦
] (mean: 47.9

◦
506 | ) established in
507 | Table IV.
508 | 2) Stall Timeout and Pulse Suspension: Because standard
509 | RC servomotors do not accept direct torque commands
510 | via position PWM, persistent stall conditions cannot be
511 | resolved by reducing hold torque. Instead, if an actuator
512 | target remains static under continuous high-current stall
513 | (I > 450 mA recorded by the INA219 monitor) or
514 | continuous deflection for ∆t > 15 s (corresponding to a
predicted unmitigated temperature rise of ≈ 3.2

◦
515 | C), the
516 | supervisory controller suspends the 50 Hz PWM drive
517 | pulses to that specific PCA9685 channel. Suspending
518 | the pulse command immediately de-energizes the inter-
519 | nal H-bridge, rendering the output shaft mechanically
520 | compliant (free-wheeling) and eliminating Joule heat-
ing before surface temperatures reach the 55◦
521 | C safety
522 | threshold.
523 | To ensure complete operational robustness beyond thermal
524 | failure modes, Table VI systematically details the comprehen-
525 | sive risk assessment across perception, communication, power,
526 | and actuator tiers.

TABLE VI
SYSTEM FAILURE MODES, OPERATIONAL RISK ASSESSMENT, AND MITIGATION STRATEGIES FOR THE SOFIA ROBOTIC SURFACE
Failure / Risk | P / I | Mitigation Strategy | Verification Method
Actuator Stall | Alta / Alta | Watchdog limits ∆t ≤ 15 s; disables 50 Hz PWM on stall (I > 450 mA). | Thermal log via LM35 bench and INA219 teleme- try.

Vision Latency Media /
| Media
Multi-threaded | Python
worker | isolates | MediaPipe
| | at ≥ 30 FPS; BLE queue.
GUI | FPS | badge
and | latency | timer
| | | (tlat ≤ 33 ms).
I
2C Collision | Baja / Alta
Hardware | pin-strapping | (A0
| | solder pads) sets Addrs 0x40 and 0x41. | I 2C bus scan and ACK ver- ification during firmware boot.

Servo Rail Sag Alta /
| Alta | Centralized 5.0 V / 25 A PSU, star topology via 22 AWG wiring and JST-VH.
Oscilloscope | rail
transient | capture
| | | (∆V ≤ 250 mV).
RS-485 Time- out | Baja / Media
Differential | transceivers,
| | 120 Ω termination, Modbus CRC checksum, watchdog. | Differential bus bit-error verification at 115.2 kbps.
IV. RESULTS | 527
A. Kinematic Tracking Simulation | 528
To validate the analytical kinematic model, a dynamic 529 tracking simulation of the 16-module SOFIA robotic hon- 530 eycomb array was conducted in a virtual 3D environment 531 using the Unity engine [11]. The objective was to evaluate 532 the coordinated orientation of the modules toward a moving 533 target coordinate p(t) ∈ R

3
. | 534
For each module mi
, the inverse kinematics procedure 535 computes the servo joint variables (q1, q2) from the relative 536 target position in accordance with the analytical formulation 537 established in Section III-B (Eq. (13)), enforcing actuator satu- 538 ration boundaries. The complete numerical tracking procedure 539
is summarized in Algorithm 1. | 540
Figure 3 shows six representative frames of the simulated 541 tracking process. As the target moves through the workspace, 542 the modules progressively change their orientation, maintain- 543 ing the direction of their normal vectors ˆr

(i)
2,3

toward the target 544
position. The sequence illustrates the coordinated response 545 of the 16-module array during different stages of the target 546
trajectory. | 547
B. Functional and Performance Evaluation | 548
Functional tests were conducted to assess the operation 549 of the vision, communication, and actuation components. To 550 validate the kinematic tracking performance promised by the 551 technological differentiator, a formal tracking protocol was 552 established across two motion regimes evaluated over N = 10 553 repetitions: (i) continuous sinusoidal palm oscillations (f ∈ 554 [0.2, 0.8] Hz, lateral sweep ±25 cm), and (ii) discrete angular 555 steps (∆q ∈ {5

◦

, 30◦

, 90◦}) under 500 lux illumination. 556 System performance is benchmarked using two core metrics: 557 the joint angular tracking error εq(t) = |q

target
j
(t) − q
| real
| j

(t)| 558
(evaluated via Mean Absolute Error and RMSE), and the 559 total end-to-end latency tlatency = τvis + τcomm + ts. Here, 560 visual landmark inference accounts for τvis ≈ 30–35 ms 561 (MediaPipe operating at ≥ 30 FPS), communication and 562 queueing overhead contribute τcomm ≈ 12–18 ms over BLE, 563 and electromechanical servo settling requires ts ≈ 75–180 ms 564 governed by the nominal slewing speed (0.10 s/60◦
| at 5.0 V). 565


(a) | (b) | (c)

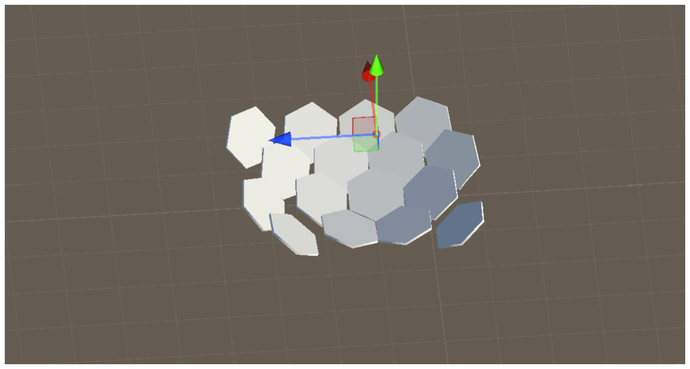
[picture p35: figure]
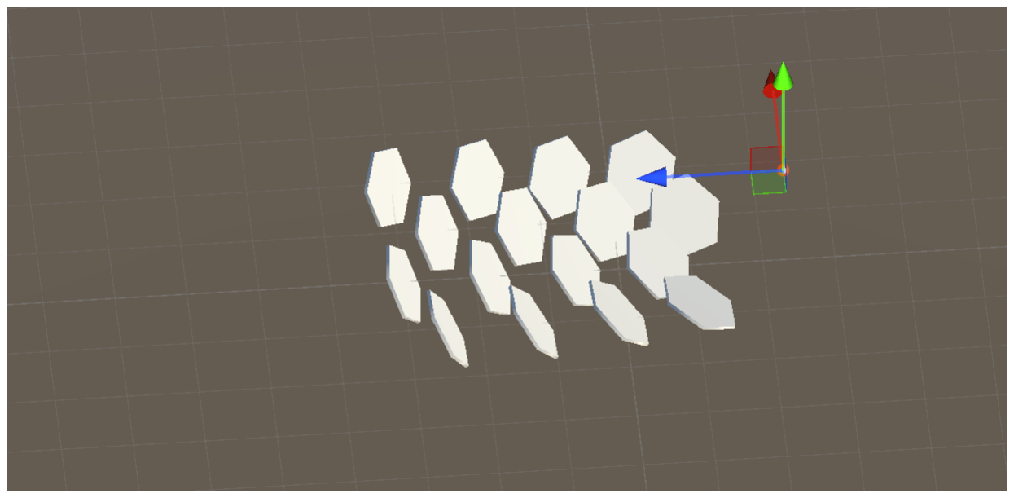
[picture p36: figure]

(d) | (e) | (f)

Fig. 3. Representative frames of the SOFIA kinematic tracking simulation, illustrating coordinated reorientation of the 16-module array toward target p(t).

True joint angles q

real
j
(t) are measured synchronously by combining internal PCA9685 PWM setpoint logs with a 120 FPS high-speed camera recording optical reference markers on the hexagonal end-effector, yielding sub-degree angular ground truth (±0.2

◦
). This optical telemetry directly corroborates the electrical findings of Section II-B: under small tracking adjustments (εq ≤ 5

◦
), the MG90S modulates
PWM duty cycle smoothly and settles into its 5 µs deadband (Iquiesc ≈ 3.1 mA), refuting unconstrained bang-bang switching; conversely, under large steps (∆q = 90◦
), the drive
bridge saturates strictly during slewing (ts ≈ 180 ms) before resuming proportional linear regulation.
C. Limitations and Failure Analysis
The current system still requires trajectory-smoothing improvements during continuous hand tracking to reduce abrupt changes in joint targets. In addition, the simulated 16-module array does not by itself establish the physical performance of the complete multi-unit system. While unit-level validation confirms tracking protocol feasibility, future experiments will scale optical tracking to multi-module arrays to evaluate intermodule spatial coherence, bus contention under 32-channel PWM dispatch, and thermal accumulation during sustained continuous interaction.
V. DISCUSSION
The experimental characterization of the MG90S servomotor and the kinematic tracking simulation of the SOFIA kinetic array provide key insights into the intersection between high-level human-robot interaction and low-level electromechanical constraints.
In terms of actuator thermal dynamics and control analogies, current telemetry under small (5

◦

), large (90◦
), and
stall conditions distinguishes the internal drive mechanism: rather than a pure bang-bang controller, the MG90S operates as a proportional PWM driver that enters hard saturation

(Istall ≈ 918 mA) only when physically blocked. In this unmit- 600 igated locked-rotor regime, the continuous H-bridge saturation 601 dissipates electrical energy as heat at a quasi-linear rate of 602 β ≈ 0.214 ◦C/s. This steep thermal gradient directly degrades 603 internal components, causing mechanical softening of plastic 604 gear retainers and brush wear when surface temperatures 605
exceed 65◦C. | 606
When contrasted with established modular robotics liter- 607 ature [1], where actuators are typically idealized as uncon- 608 strained position or velocity sources, our experimental findings 609 emphasize that thermal accumulation constitutes a primary 610 failure mode in densely clustered kinetic arrays. By integrating 611 software-level watchdog monitors and stall timeouts into the 612 kinematic dispatcher, SOFIA is expected to prevent localized 613 thermal overshoots while maintaining continuous social inter- 614
action [2] within safe operating envelopes. | 615
Nonetheless, several methodological limitations must be 616 considered. The external LM35 sensor measures casing surface 617 temperature rather than internal coreless rotor winding temper- 618 ature directly; consequently, internal winding temperatures are 619 expected to reach higher instantaneous values than the outer 620 shell readings. Furthermore, while the external 50 Hz PWM 621 command stream is fully observable, the proprietary internal 622 feedback loop of commercial servos remains inaccessible to 623 external instrumentation. As a result, the identified first-order 624 electrothermal model operates as an effective macroscopic 625 indicator of thermal degradation rather than a microscopic 626 reverse-engineering of the internal drive electronics. In future 627 work, directly isolating the internal motor terminals to measure 628 the armature winding resistance Ra via four-wire Kelvin sens- 629 ing will allow decoupling copper losses from driver electronics 630 dissipation, refining the empirical estimates of Rth and Cth. 631

VI. CONCLUSIONS
This paper presented the conceptual design, system architecture, and experimental actuator characterization of SOFIA, an interactive modular robotic surface comprising sixteen 2-DOF electromechanical units. By coupling real-time computer vision (MediaPipe 3D upper-body pose and 21-point hand tracking) with distributed ESP32-C3 / PCA9685 motion controllers, the platform synthesizes intuitive kinetic responses to human non-verbal gestures. Experimental evaluation under persistent position error conditions demonstrated that unmitigated mechanical stalls lead to a sustained temperature rise with a critical heating rate of

β

≈
0

.214

◦
C/s and casing
temperatures reaching 70

.21

◦
C. Incorporating angular limits and thermal watchdog timeouts mitigates actuator burnout risk, establishing a robust foundation for the physical implementation and deployment of modular kinetic surfaces.

DECLARATIONS AND

ACKNOWLEDGMENTS

Author Contributions: P. M. C.-V. conceived SOFIA and coordinated protocol; J. B. O.-Q. developed vision tracking and documentation; L. A. M.-O. and K. I. S.-G. conducted thermal tests; A. E. F.-G. contributed to electronics and kinematics. All authors reviewed the manuscript.
Data Availability: Experimental logs, raw characterization data, and firmware/vision code are cataloged as supplementary material in the docs/experimental-data/ directory and openly available on GitHub (https://github.com/PaolaCV14/IOT-SOFIA-2026, release tag v0.2.0, commit 7a790a3).
Acknowledgment: The authors thank DPETI and the Laboratory of Technological Solutions Development (LabDST), ITESO, for laboratory instrumentation and technical support.
Declaration of Generative AI: During the preparation of this work, the authors used large language models (Claude 5.5 Sonnet and Gemini 3.8 Flash) strictly for grammatical proofreading, LaTeX typesetting assistance, and reproducible script formatting; the authors reviewed and edited all content and take full responsibility.
Conflicts of Interest: The authors declare no conflicts of interest.

REFERENCES

[1] J. Seo, J. Paik, and M. Yim, “Modular reconfigurable robotics,” Annual Review of Control, Robotics, and Autonomous Systems, vol. 2, pp. 63– 88, 2019.
[2] T. Fong, I. Nourbakhsh, and K. Dautenhahn, “A survey of socially interactive robots,” Robotics and Autonomous Systems, vol. 42, no. 3–4, pp. 143–166, 2003.
[3] Espressif Systems, ESP32-C3 Series Datasheet, Espressif Systems, 2024, datasheet, v2.4. Available: https://www.espressif.com.
[4] NXP Semiconductors, PCA9685: 16-channel, 12-bit PWM Fm+ I2C-bus LED controller, NXP Semiconductors, 2015, datasheet, Rev. 4.
678 | [5] D. E. Kirk, Optimal Control Theory: An Introduction. | Mineola, NY,
| USA: Dover Publications, 2004.
[6] Y. Quinonez, C. Lizarraga, and R. Aguayo, “Machine learning solutions ˜
with MediaPipe,” in Proc. 11th Int. Conf. Softw. Process Improv. (CIMPS), Acapulco, Mexico, 2022, pp. 1–6. [Online]. Available: https://ieeexplore.ieee.org/stamp/stamp.jsp?arnumber=10035706
[7] C. Lugaresi, J. Tang, H. Nash, C. McClanahan, E. Uboweja, M. Hays,
F. Zhang, C.-L. Chang, M. G. Yong, J. Lee, W.-T. Wan, W. Hua, and M. Grundmann, “MediaPipe: A framework for building perception
| pipelines,” arXiv preprint arXiv:1906.08172, 2019.
[8] G. Bradski, “The OpenCV library,” Dr. Dobb’s Journal of Software
| Tools, vol. 25, no. 11, pp. 120–125, 2000.
[9] S. Follmer, D. Leithinger, A. Olwal, A. Hogge, and H. Ishii, “inFORM: Dynamic physical affordances and constraints through shape display,” in Proc. 26th Annu. ACM Symp. User Interface Softw. Technol. (UIST)
| | ,
| 2013, pp. 417–426.
[10] K. Nakagaki, S. Follmer, and H. Ishii, “Transform: Exploring the properties of shape displays for kinetic furniture,” in Proc. 30th Int. Conf. Human Factors Comput. Syst. (CHI Extended Abstracts), 2016,
| pp. 278–281.
[11] Unity Technologies, “Unity Real-Time 3D Development Platform,”
| https://unity.com, 2023, version 2022.3 LTS.
