PaolaCV14/IOT-SOFIA-2026/paper/Equipo 1 - segundo corte/figures/DIAGRAMA PCB.png

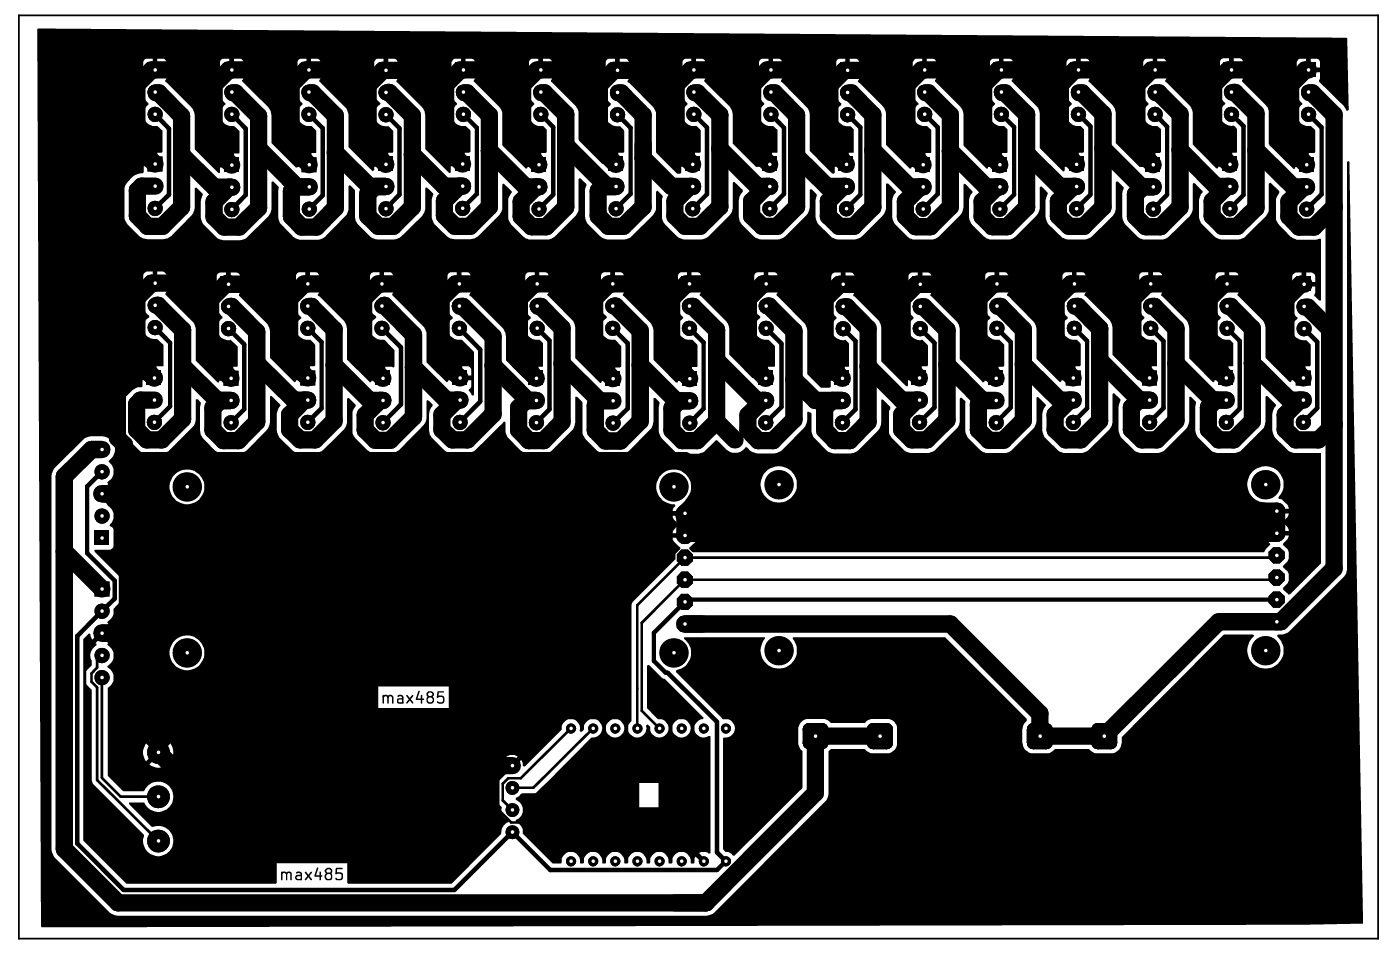
paper/Equipo 1 - segundo corte/figures/DIAGRAMA PCB.png
