PaolaCV14/IOT-SOFIA-2026/paper/Equipo 1 - segundo corte/figures/sofia solid 2.png

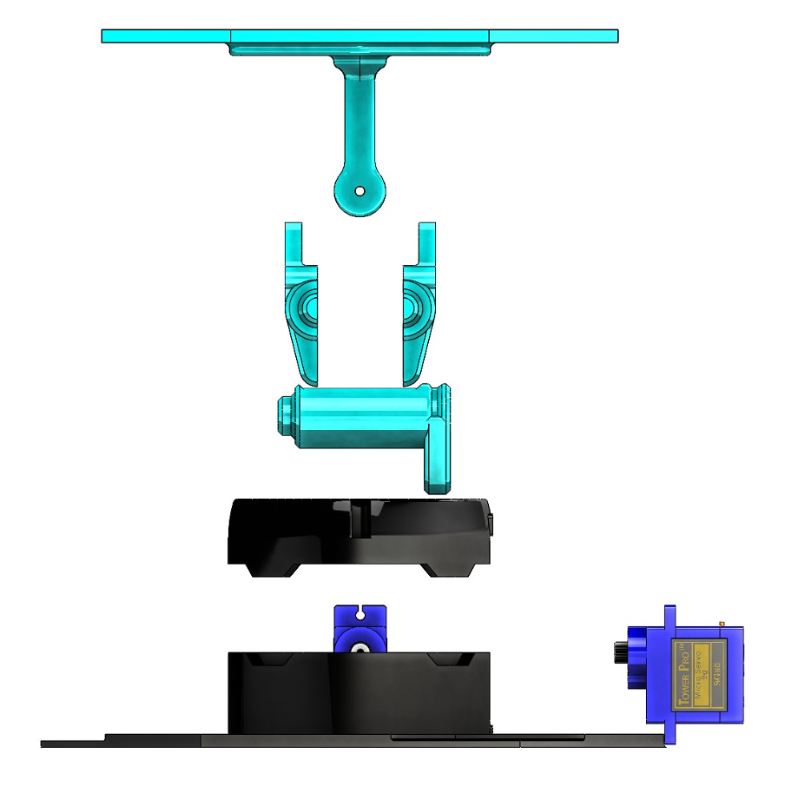
paper/Equipo 1 - segundo corte/figures/sofia solid 2.png
