PaolaCV14/IOT-SOFIA-2026/WEBOT SOFIA/webots/worlds/.sofia_world.jpg

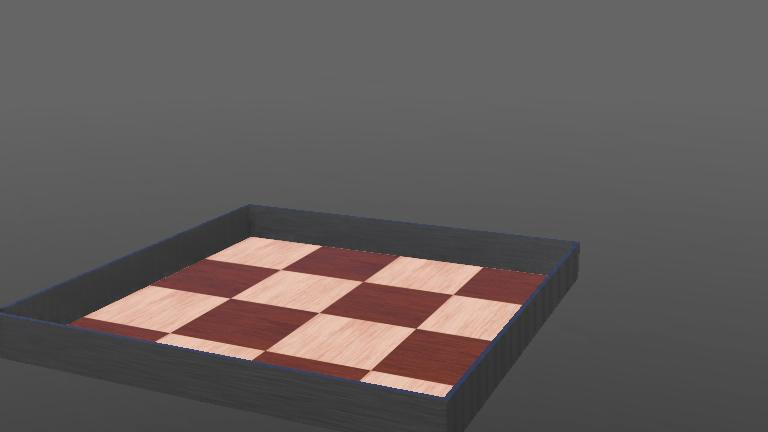
WEBOT SOFIA/webots/worlds/.sofia_world.jpg
