PaolaCV14/IOT-SOFIA-2026/WEBOT SOFIA/cad/EJE y.STL

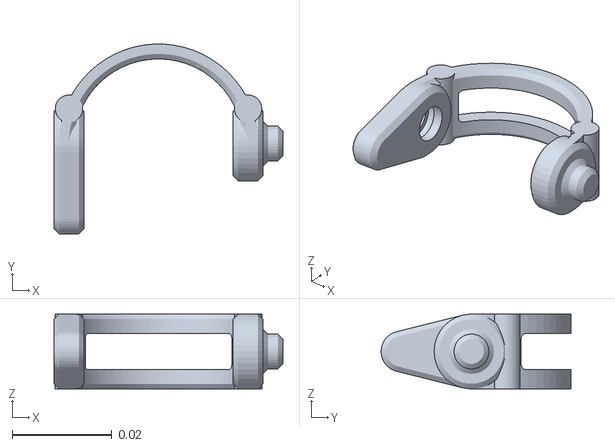
[picture p66: CAD file, 2026-10-13]
WEBOT SOFIA/cad/EJE y.STL
0.046 x 0.0381 x 0.015
