PaolaCV14/IOT-SOFIA-2026/WEBOT SOFIA/webots/protos/meshes/EJE X.STL

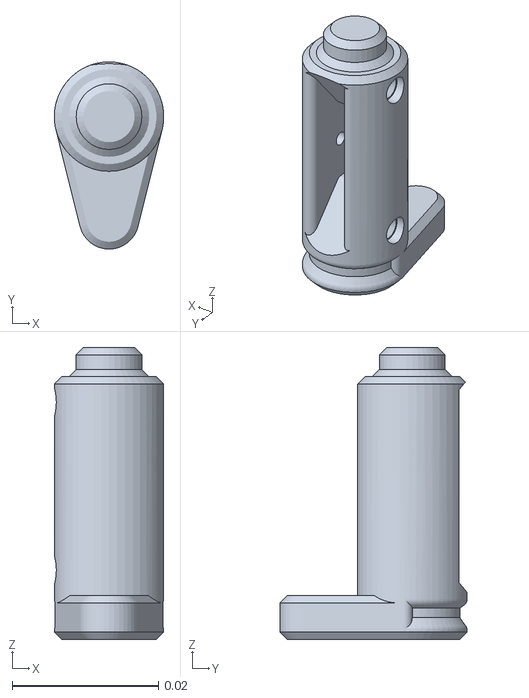
[picture p67: CAD file, 2026-10-13]
WEBOT SOFIA/webots/protos/meshes/EJE X.STL
0.015 x 0.0257 x 0.04
