PaolaCV14/IOT-SOFIA-2026/WEBOT SOFIA/cad/hexagono.STL

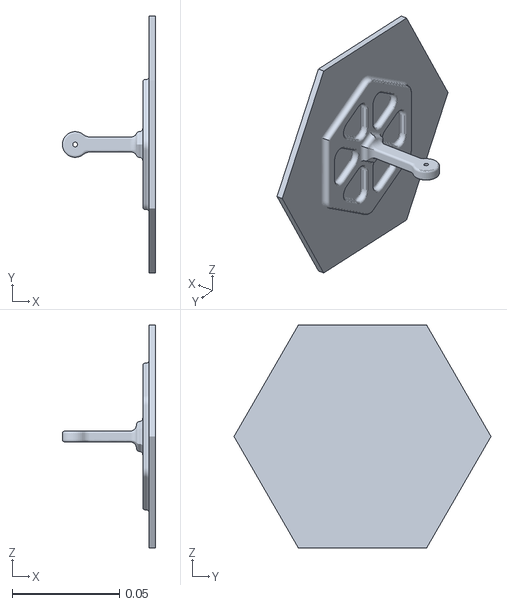
[picture p68: CAD file, 2026-10-13]
WEBOT SOFIA/cad/hexagono.STL
0.0435 x 0.12 x 0.104
