PaolaCV14/IOT-SOFIA-2026/WEBOT SOFIA/webots/protos/meshes/BASE.STL

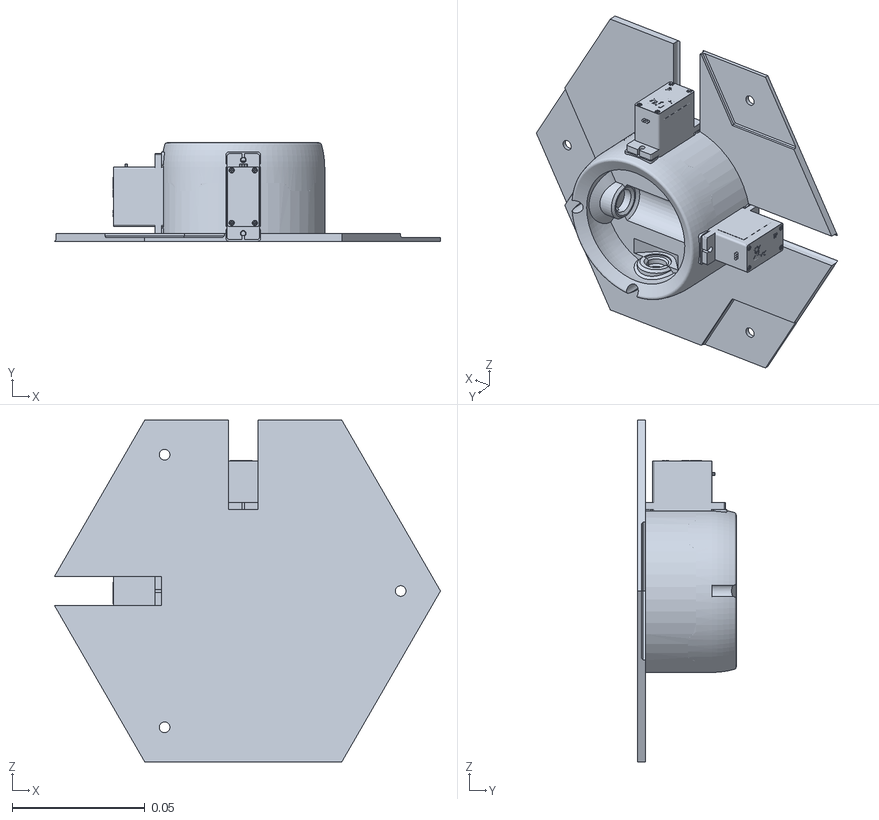
[picture p69: CAD file, 2026-10-13]
WEBOT SOFIA/webots/protos/meshes/BASE.STL
0.145 x 0.0371 x 0.129
