PaolaCV14/IOT-SOFIA-2026/paper/Equipo 1 - segundo corte/test_10p.pdf

LABDST SOFIA, ITESO, FALL 2026 | 1

# SOFIA: Modular Robotic Kinetic Surface for Human-Robot

# Interaction and Thermal-Constrained Actuator Characterization

Paola M. Covarrubias-Viveros, Lizeth A. Mendez-Ortiz, Juan Bernardo Orozco-Quirarte, Karen I. S ´ | anchez-Garc ´ | ´ıa,
Alan E. Fuentes-Gutierrez, Jorge A. Lizarraga, Graciela Baca, Luis Enrique Gonz ´ | alez-Jim ´ | enez and Luis F. ´
Luque-Vega

Abstract—Modular robotic systems leverage repeatable electromechanical units to enable flexible, scalable, and reconfigurable architectures. In interactive human-robot installations, spatial tracking of human body posture and gestures provides intuitive stimulus-response dynamics. This paper presents the modular design and experimental validation of key subsystems for SOFIA, a planned interactive kinetic surface comprising sixteen electromechanical units, each providing two rotational degrees of freedom actuated by commercial MG90S servomotors. While commercial servomotors encapsulate internal closed-loop position control via pulse-width modulation (PWM), persistent angular errors caused by mechanical stalls, external disturbances, or fabrication tolerances induce thermal degradation and excessive power consumption. To investigate actuator reliability under persistent position error conditions, this work formulates an experimental characterization protocol assessing the thermal response of an MG90S under mechanical stall. Using an LM35 precision temperature sensor and a commanded reference angle, actuator heating is characterized during continuous stall, revealing an initial quasi-linear heating rate of β ≈ 0.214 ◦ C/s
(R

2 = 0.993) and casing temperatures reaching 70.21◦
C across
extended testing before thermal equilibrium is attained. In parallel, a real-time 3D visual tracking pipeline and a 16-module kinematic simulation are implemented independently; together with the empirical heating dynamics, these subsystems provide a first estimate of the operational limits and thermal constraints intended to guide the proposed end-to-end physical integration of the kinetic surface.

Index Terms—Modular robotics, Human-Robot Interaction (HRI), servomotor characterization, thermal modeling, actuator saturation, computer vision, kinematics.

I. INTRODUCTION
MODULAR robotics enables constructing complex spatial mechanisms from repeatable functional units integrating mechanical, electronic, and control capabilities, offering superior reconfigurability and maintainability over monolithic robotic architectures [1].
In parallel, socially interactive and human-robot interaction (HRI) systems incorporate perception and actuation mechanisms to establish continuous, non-verbal dialogue with human participants. Within this domain, posture, gestures, and body kinematics constitute vital communication channels for interpreting user intent and synthesizing reactive robotic behavior [2]. Consequently, modern kinetic robotic installations operate not merely as automated spatial mechanisms, but as interactive expressive surfaces capable of responding synchronously to multimodal human stimuli.

The authors are with the Department of Technological and Industrial Processes, ITESO, Tlaquepaque 45604, Jalisco, Mexico.

48 | Within this framework, this paper introduces SOFIA, a mod-
49 | ular robotic installation comprising sixteen electromechanical
50 | units arranged in a kinetic honeycomb array. Each module
51 | provides two rotational degrees of freedom (2-DOF) driven
52 | by dual metal-gear MG90S servomotors (32 actuators total).
53 | Actuator control and signal distribution are organized through
54 | a centralized electronic architecture, wherein a master ESP32-
55 | C3 processing node manages trajectory interpolation and com-
| mands dual 16-channel PCA9685 PWM drivers over an I²
56 | C
57 | bus to synchronously synthesize the 32 servo control pulses.
58 | Supervisory communication is established via Bluetooth Low
59 | Energy (BLE) and Wi-Fi, with hardware provision for inter-
60 | module expansion over an industrial RS-485 / Modbus bus.
61 | The system relies on the ESP32-C3 microcontroller as
62 | the core processing and telemetry engine [3], coupled with
| PCA9685 16-channel 12-bit I²
63 | C PWM controllers [4] to
64 | synthesize precise 50 Hz control pulses for the servomotors.
65 | Although commercial off-the-shelf (COTS) servomotors sim-
66 | plify spatial positioning, their internal closed-loop controllers
67 | remain completely encapsulated within the actuator housing.
68 | Consequently, while the supervisory system commands an
69 | angular setpoint via external 50 Hz PWM duty cycles, the
70 | internal drive strategy utilized to eliminate error between ref-
71 | erence and actual shaft position is inaccessible to the designer.
72 | This characteristic becomes critical when a servomotor
73 | experiences operational constraints where it cannot reach the
74 | commanded angular setpoint. In large-scale kinetic arrays
75 | composed of numerous densely packed modules, mechanical
76 | interference, fabrication tolerances, structural interference, or
77 | physical obstacles produce persistent, non-zero position errors.
78 | Under such conditions, internal driver behavior governs cur-
79 | rent draw, internal thermal dissipation, and long-term hardware
80 | reliability.
81 | A classical control archetype relevant to bounded-input
82 | actuators under persistent saturation is bang-bang (on-off)
83 | control. Under Pontryagin’s maximum principle, bang-bang
84 | switching strategies naturally arise in optimal control problems
85 | subject to bounded actuation limits, providing a theoretical
86 | archetype for analyzing actuator behavior under persistent
87 | error [5]. However, because both bang-bang switching and
88 | saturated proportional control deliver peak voltage during
89 | mechanical stall, a thermal trajectory alone cannot discriminate
90 | between them without direct current telemetry under varying
91 | error amplitudes.
92 | To address this challenge, this paper experimentally char-
93 | acterizes the electromechanical and thermal behavior of the
94 | MG90S servomotor under persistent position error. By impos-

ing a mechanical constraint on the output shaft and monitoring | 95
surface temperature with a precision LM35 sensor, this study | 96
extracts empirical first-order thermal models via linear regres- | 97
sion. The primary working hypothesis posits that persistent | 98
angular error induces an observable thermal signature that | 99
quantitatively reflects actuator operational constraints. Accord- 100 ingly, the central research question guiding this work is: Does 101 persistent position error in an MG90S servomotor produce 102 an identifiable thermal signature that bounds the safe holding 103 time of a SOFIA kinetic module? To answer this question, four 104
specific, measurable technical objectives are addressed: | 105
1) Actuator Evaluation: Quantify angular limits (θ ∈ 106 [19.3

◦
, 70.2

◦
]) and settling times (ts ∈ [75, 180] ms) 107
under 50 Hz PWM drive. | 108
2) Thermal Modeling: Characterize stall heating to deter- 109 mine empirical slope (β ≈ 0.214 ◦C/s) and safety limits 110
(> 65◦C). | 111
3) Perception Validation: Extract 3D pose and 21-point 112 hand landmarks via MediaPipe at ≥ 30 FPS to arbitrate 113
dynamic gestures. | 114
4) Kinematic Simulation: Formulate 2-DOF analytical 115 kinematics and validate 16-module spatial tracking in 116
dynamic simulation. | 117
The core contribution of this work lies in combining a vision- 118 driven modular robotic architecture for human-robot interac- 119 tion with rigorous experimental actuator characterization, es- 120 tablishing thermal boundaries intended to support operational 121
reliability in kinetic surfaces. | 122
A. Related Work | 123
Recent advances in interactive surfaces and vision-driven 124 robotics have accelerated with lightweight machine learning 125 inference frameworks. Quinonez ˜ et al. [6] and Lugaresi et 126 al. [7] demonstrated the efficacy of MediaPipe perception 127 graphs for real-time 3D landmark estimation, which, combined 128 with optimized computer vision pipelines via OpenCV [8], 129 enable 21-point hand skeleton topologies to be extracted with 130
minimal computational latency. | 131
In the domain of dynamic physical interfaces and shape 132 displays, Follmer et al. [9] introduced inFORM, a 2.5D 133 shape display comprising 900 motorized linear pins operat- 134 ing at high update rates for dynamic tangible interaction. 135 Expanding toward interactive kinetic architectural furniture, 136 Nakagaki et al. [10] developed Transform, incorporating over 137 1,000 independent motorized linkages. In modular and re- 138 configurable robotics, Seo et al. [1] formalized scalability 139 criteria, distributed communication, and power distribution 140 across repeatable electromechanical units, while Fong et al. [2] 141 surveyed social robotics, demonstrating that physical motion, 142 non-verbal mirroring, and gestural responsiveness enhance 143
user engagement. | 144
Despite these advances, existing kinetic installations and 145 shape displays [1], [9], [10] predominantly assume ideal actua- 146 tor trajectory completion, frequently overlooking actuator stall 147 dynamics, current surges, and internal thermal accumulation 148 occurring across densely populated arrays. While classical 149

TABLE I
BENCHMARKING COMPARISON OF INTERACTIVE KINETIC SURFACES AND SHAPE DISPLAYS
Platform | Units (DOF)
Range | /
DOF

Actuator
Type

Latency /
Rate
inFORM [9] | 900 | (1-
| DOF)
100 | mm
(linear)

DC
motorized
pin

≈ 60 Hz

Transform [10] | 1,152 (1-DOF)
100 | mm
| | (linear) | DC gearmo- tor | ≈ 30 Hz
Modular Cells [1] | Variable | Rotational | Brushless/DC | Distributed bus
SOFIA (Ours) | 16 | (2-
| DOF) | 19.3 ◦ –70.2 | ◦Metal MG90S | ≤ 33 ms (30 fps)
150 | optimal control formulations [5] establish theoretical bound-
151 | aries for bounded controller actions, physical implementations
152 | require empirical thermal validation; building upon these foun-
153 | dations, this research bridges the gap between high-level visual
154 | tracking and low-level physical actuator reliability.
155 | B. Demonstrator Analysis
156 | During the initial Discover stage of the D-Lab methodology,
157 | guided physical observation of the SOFIA proof-of-concept
158 | module identified critical operational failure modes emerging
159 | from dense actuator packaging. The modular kinetic cell
160 | decomposes into five core functional subsystems, summarized
161 | in the functional decomposition matrix (Table II).
162 | Guided laboratory observations revealed that during spa-
163 | tial multi-facet alignment, adjacent 3D-printed petals occa-
164 | sionally encounter mechanical interference due to fabrica-
165 | tion tolerances (±0.4 mm) and rapid user gesture transients.
166 | Consequently, actuators become physically constrained before
167 | achieving commanded setpoints.
168 | To rigorously structure this vulnerability, a problem tree
169 | analysis was synthesized:
170 | • Direct Effects: Armature coil burnout, PLA housing
| softening (Tg ≈ 60◦
171 | C), power supply rail voltage sags,
172 | and complete module desynchronization.
173 | • Core Focal Problem: Persistent angular tracking error
174 | (e(t) = θd(t) − θstall ̸= 0) occurring across densely
175 | packed, unmonitored COTS actuators.

TABLE II
FUNCTIONAL DECOMPOSITION MATRIX OF THE SOFIA DEMONSTRATOR MODULE
Subsystem | Function | Input | Output | Limitation
Perception | Hand landmark tracking
RGB | video
| | stream | 3D normalized coordinates | Occlusion, ambient lighting
Control | /
Telemetry | Trajectory interpolation | BLE / Mod- bus packets | Target angle θd(t) | Bus contention, latency
Actuation | 2-DOF angular orientation | 50 Hz PWM duty cycle
Shaft | angle
| | | θ(t), torque | Stall heating, unobservable e(t)
Kinematic Core | Planar honeycomb articulation
Dual | servo
| | shaft torque | Spatial facet tilt | Angular
range | limits
| | | | (19.3 ◦ –
| | | | 70.2 ◦ )
Power | /
Thermal | Regulated cur- rent delivery | 5.0 V DC bus | Electrical power | Joule dissipa- tion, no active cooling

TABLE III
BILL OF MATERIALS SUMMARY FOR THE SOFIA 16-MODULE ROBOTIC SURFACE
Component | Qty./Unit | Qty. System | Technical Description | Manufacturer | Location
MG90S Servomotor | 2 | 32 | Metal gear micro servo, torque 1.8–2.2 kgf·cm at 4.8–6.0 V, evaluated θ ∈ [19.3
◦
, 70.2

◦
], 50 Hz
| | | PWM | TowerPro | Shenzhen, China
Module Enclosure | 1 | 16 | 3D-printed PLA casing, custom SOFIA003 hon- eycomb design for 2-DOF module
In-house (LabDST) | Tlaquepaque, Mexico
M3 Fasteners (Various) | 4 | 64 | Stainless steel socket head cap screw, M3 × 10 mm, for servo and frame mounting
Generic | Tlaquepaque, Mexico
PCA9685 Servo Driver | – | 2 | 16-Channel 12-bit PWM I²C driver breakout
| | | module for 32 servomotors
UNIT Electronics | Mexico City, Mexico
ESP32-C3 Master MCU | – | 1 | 32-bit RISC-V microcontroller (Super Mini), 2.4 GHz Wi-Fi / Bluetooth 5 LE
Espressif Systems | Shanghai, China
RS-485 Transceiver | – | 2 | MAX485 / SP3485 differential bus transceiver module for industrial serial communication
Maxim Integrated / Generic | San Jose, USA
JST-VH Power Connectors | 2 | 32 | 2-pin 3.96 mm pitch disconnectable crimp con- nector, high-current servo supply rail
J.S.T. Mfg. Co. | Tokyo, Japan
Power Supply Unit (PSU) | – | 1 | Regulated DC switching power supply, 5.0 V output, 20 A rated capacity (100 W)
Mean Well | New Taipei, Taiwan
Prototyping PCB | – | 1 | Distribution power board / breadboard breakout carrier for signal and power routing
In-house / Generic | Tlaquepaque, Mexico
Wiring Harness | 2 | 32 | 22 AWG flexible silicone multi-conductor copper wire for power rails and PWM lines
Generic | Tlaquepaque, Mexico
INA219 Current Sensor | – | 2 | I²C zero-drift bi-directional current/power moni-
| | | tor module, high-side sensing up to 26 V / 3.2 A

Texas Instruments / UNIT
Electronics

Mexico City, Mexico

LM35 Temperature Sensor | 1 | 1 | Precision centigrade analog temperature sensor (10 mV/ ◦C), thermal validation bench
Texas Instruments / UNIT
Electronics

Mexico City, Mexico

- Root Causes: (i) lack of direct shaft position telemetry 176 to the supervisory controller, (ii) aggressive internal ana- 177 log/digital H-bridge driver compensation under stall, and 178 (iii) absence of thermal dissipation pathways in enclosed 179
modular housings. | | 180
These Discover findings motivated the experimental thermal 181 characterization and bounded control strategies developed in 182
this work. | | 183
C. Formal Problem Formulation | | 184
The SOFIA system requires coordinated spatial orientation 185 of 32 independent servomotors across 16 electromechanical 186 modules. Each actuator receives an angular reference setpoint 187 θd(t) and is commanded to achieve the target physical orien- 188
tation θ(t). | | 189
The angular position error e(t) for any given actuator is 190
formally defined as: | | 191
e(t) = θd(t) − θ(t), | | (1) 192

where θd(t) ∈ [θmin, θmax] corresponds to the desired (com- 193 manded) angular position, and θ(t) denotes the instantaneous 194 actual angular position of the output shaft. In the single-axis 195 experimental characterization, the scalar variable θ(t) ≡ qj (t) 196 (j ∈ {1, 2}) denotes the coordinate of the servomotor under 197 test, corresponding identically to either joint axis of the 2-DOF 198
kinetic module. | | 199
Under ideal, unconstrained operation, the internal feedback 200 loop drives e(t) → 0 within a settling time ts ∈ [75, 180] ms. 201 However, when an external mechanical constraint prevents the 202 actuator from reaching θd(t) such that θ(t) = θstall ̸= θd(t), 203
the error persists indefinitely: | | 204
e(t) = θd(t) − θstall = ∆θ0 ̸= 0, | ∀t ≥ t0. | (2) 205
206 | When e(t) persists, the internal H-bridge driver continu-
207 | ously supplies high current to the DC coreless motor in an
208 | attempt to minimize the tracking discrepancy. This condition
causes significant Joule heating (Ploss = I 209 | 2R) within the
210 | motor armature and driver silicon, inducing rapid thermal
211 | accumulation. Modeling this thermal profile and its associated
212 | time constant provides the quantitative foundation for actuator
213 | risk mitigation in the SOFIA array.
214 | II. MATERIALS AND METHODS
215 | Table III summarizes the bill of materials for the SOFIA
216 | 16-module system, including each component’s technical de-
217 | scription, manufacturer, and country of origin. Furthermore,
218 | Tables IV–IV summarize the critical parameters of each key
219 | electromechanical and electronic component against the mod-
220 | ule functional and operational requirements.
221 | The | servomotor | operational | limits | and | step
222 | response | parameters | were | experimentally | evaluated
223 | using | the | test | protocol | recorded | in | the | project
224 | logbook | and | supplementary | data | (repository,
225 | docs/experimental-data/servo_characterization.xlsx).
226 | Under continuous PWM excitation at 50 Hz, the effective
angular deflection spanned θ ≡ qj | ∈ [19.3

◦

| | | | | | | , 70.2 | ◦
227 | | | | | | | | ] with
a mean operating angle of 47.9
| | | | | ◦
228 | and step response times
229 | ranging between 75 ms and 180 ms.
230 | To sustain simultaneous inrush transients and multi-actuator
231 | coordinated tracking without voltage sag on the 5.0 V DC bus
232 | under a 25% engineering design margin, the power distribution
233 | network requires IPSU ≥ 23.2 A (Table V). Accordingly, a
234 | regulated DC switching power supply rated at 5.0 V / 25 A
235 | (125 W) was selected (or 5.0 V / 20 A when PCA9685
236 | PWM channel phase-staggering is enabled). The supply is
237 | complemented with local 2200 µF low-ESR decoupling elec-
238 | trolytic capacitors per distribution branch and 22 AWG sili-
239 | cone star wiring with JST-VH high-current terminals, ensuring

TABLE IV
COMPONENT TECHNICAL SPECIFICATIONS AND SYSTEM REQUIREMENTS COMPLIANCE ASSESSMENT
Component | Parameter | Nominal / Measured Value | System Justification (Requirement) | Compliance | Source

ESP32-C3 Master Microcontroller (Espressif Systems)
ESP32-C3 | Supply Voltage | 3.0–3.6 V (3.3 V typical) | REQ-PWR: Regulated logic rail oper-
ation

Compliant Datasheet v2.4, Sec. 5.2, Table 5-2
ESP32-C3 | Supply Current | 0.5 A minimum rating | REQ-PWR: Adequate core and radio
current headroom

Compliant Datasheet v2.4, Sec. 5.2, Table 5-2
ESP32-C3 | Wi-Fi Current | 276–335 mA peak | REQ-COM: Sufficient capacity for RF
burst transmissions

Compliant Datasheet v2.4, Sec. 5.6.1, Table 5-7
ESP32-C3 | Logic VIH / VIL | ≥ 0.75VDD / ≤ 0.25VDD | REQ-CTL: Robust noise margins on
I

2C bus lines

Compliant Datasheet v2.4, Sec. 5.4, Table 5-4
ESP32-C3 | Boot Strapping | GPIO2, GPIO8, GPIO9 | REQ-CTL: Deterministic SPI flash
boot execution

Compliant Datasheet v2.4, Sec. 3.1, Table 3-3
ESP32-C3 | Wireless Interface | 2.4 GHz Wi-Fi / Bluetooth 5
LE

REQ-COM: Host telemetry and low-latency HRI commands

Compliant | Datasheet v2.4, Features, p. 3
ESP32-C3 | Operating Temp. | −40◦C to +85◦C (FN4) | REQ-ENV: Reliable operation within
enclosed casing

Compliant Datasheet v2.4, Sec. 1.2, Table 1-1

MG90S Metal-Gear Micro Servomotor (TowerPro)
MG90S | Supply Voltage | 4.8–6.0 V DC | REQ-PWR: Direct operation on regu-
lated 5.0 V DC bus
Compliant | Datasheet, TowerPro, p. 2
MG90S | Stall Torque | 1.8 | kgf·cm | (4.8 | V),
2.2 kgf·cm (6.0 V)

REQ-MEC: Facet mass reorientation (> 3× payload margin)

Compliant | Datasheet, TowerPro, p. 1
MG90S | Operating Speed | 0.10 | s/60◦
(4.8 | V),
0.08 s/60◦
(6.0 V)

REQ-CTL: Dynamic gesture mirroring (tresp < 180 ms)

Compliant | Datasheet, TowerPro, p. 1
MG90S | Control Signal | 50 Hz PWM, 1.0–2.0 ms
pulse width
REQ-CTL: | Compatibility | with
PCA9685 driver channels
Compliant | Datasheet, TowerPro, p. 2
MG90S | Dead Band Width | 5 µs | REQ-CTL: Actuator stabilization and
quiescent power cut
Compliant | Datasheet, TowerPro, p. 2
MG90S | Evaluated Angle | 19.3

◦
–70.2

◦
(mean: 47.9

◦
) REQ-MEC: Kinematic clearance between adjacent facets

Compliant LabDST test log (experimental data)
MG90S | Step Response | 75–180 ms | REQ-CTL: | End-to-end | interactive
tracking responsiveness

Compliant LabDST test log (experimental data)
MG90S | Stall Current | 918.4 ± 142.1 mA (peak
1796.9 mA)

REQ-PWR: PSU sizing, bus distribution, and watchdog trigger

Compliant LabDST test log (experimental data)
MG90S | Operating Temp. | Safe casing limit: ≤ 65◦C | REQ-SAF: Prevention of internal
polymer gear softening

Compliant Evaluated in this work (watchdog ∆t ≤ 15 s)
MG90S | Packaging / Mass | 22.5 × 12 × 35.5 mm, 13.4 g | REQ-MEC: Compact integration into
modular 2-DOF gimbal

Compliant Datasheet, TowerPro, p. 1

PCA9685 16-Channel 12-Bit PWM Controller (NXP Semiconductors / UNIT Electronics)
PCA9685 | Supply Voltage | 2.3–5.5 V DC | REQ-PWR: Logic compatibility with
3.3 V ESP32-C3 rail
Compliant | Datasheet Rev. 4, Table 14, p. 38
PCA9685 | PWM Resolution | 12-bit | (4096 | steps,
≈ 0.04◦/step)

REQ-CTL: Fine angular interpolation and smooth kinematic motion

Compliant | Datasheet Rev. 4, Sec. 1, p. 1
PCA9685 | Channel Capacity | 16 independent PWM outputs | REQ-CTL: Dual-driver architecture
controls 32 array servos
Compliant | Datasheet Rev. 4, Sec. 1, p. 1
PCA9685 | Bus Interface | I²C Fast-mode Plus (up to
1 MHz)
REQ-COM: | Synchronous | multi-
channel update at 50 Hz
Compliant | Datasheet Rev. 4, Sec. 2, p. 2
PCA9685 | Address Selection | A0–A5 pin-strapping (up to
62 IDs)

REQ-CTL: Hardware isolation of dual drivers at 0x40 and 0x41

Compliant | Datasheet Rev. 4, Sec. 7.1, p. 7
PCA9685 | Servo Power (V+) | Dedicated | external | high-
current bus

REQ-PWR: Complete galvanic isolation of servo and logic rails

Compliant UNIT Electronics product specification
PCA9685 | Operating Temp. | −40◦C to +85◦C | REQ-ENV: Industrial-grade reliability
across full thermal range

Compliant Datasheet Rev. 4, Table 13, p. 38

the actuator rail remains above 4.75 V during worst-case load 240
transients. | 241
As summarized in Tables IV and V, each core component 242 satisfies the functional requirements dictated by dense kinetic 243 integration. The master ESP32-C3 operates with > 0.5 A 244 current headroom to absorb RF burst transients (276–335 mA) 245

TABLE V
POWER AND CURRENT BALANCE FOR THE 32 MG90S SERVOMOTORS ACROSS OPERATING REGIMES ON THE 5.0 V DC BUS
Operating Regime | State | Itot (32 Servos) | Margin (+25%)
Quiescent / Dead-Band | Rest | 0.10 A | 0.12 A
Coordinated Motion | Tracking | 5.12 A | 6.40 A
Simultaneous Inrush | Transient | 18.56 A | 23.20 A
Partial Stall Fault | 4 Stall + 28 Run | 8.15 A | 10.19 A
246 | without triggering brownouts. For kinetic actuation, MG90S
247 | servomotors deliver torque margins exceeding 3× the payload
248 | with fast response times (75–180 ms) and a 5 µs dead-band
249 | that suppresses quiescent dissipation. Dual PCA9685 PWM
| drivers interface via Fast-mode Plus I²
250 | C with address pin-
251 | strapping (0x40, 0x41) and complete galvanic isolation be-
252 | tween logic and motor rails.

253 A. Experimental Setup: Thermal Characterization under Per-
254 | sistent Error
255 | To investigate the thermal behavior and reliability limits of
256 | the MG90S servomotors within the SOFIA architecture, an
257 | experimental testing apparatus was designed to record ther-
258 | mal dissipation under mechanical restriction. The test bench
259 | comprises:

Time (s); Supply Current (mA); Inrush: 582.7 mA; Step: 99.4 mA; (a1) Small Error (e = 5; ): Current I(t); Quiescent: 3.1 mA; Inrush: 573.4 mA; Transit: 172 mA; (b1) Large Error (e = 90; Peak: 1796.9 mA; (c1) Locked Rotor: Current; Mean Stall: 918.4 mA; Temperature ( ∘ C); (a2) Small Error (e = 5; ): Temperature; Measured Ts(t); Initial: 26.3; (b2) Large Error (e = 90; Initial: 28.8; Peak: 44.5; (c2) Locked Rotor: Temperature; Initial: 31.1

Fig. 1. Comprehensive experimental electromechanical and thermal characterization of the MG90S actuator under three operating regimes at 20 Hz: Supply current profiles (top row) and surface temperature trajectories (bottom row) for: (a1, a2) small error step (e = 5◦) showing transient starting peak (582.7 mA) and rapid return to quiescent deadband (Iquiesc = 3.12 mA); (b1, b2) large error step (e = 90◦) exhibiting proportional active transit duration (t ≈ 150–180 ms) prior to deadband settling; and (c1, c2) persistent mechanical stall inducing continuous 100% H-bridge saturation (Istall = 918.4±142.1 mA, peak 1796.9 mA, dissipating P0 = 4.59 W) that triggers sustained Joule heating up to 44.5

◦C (70.21◦C peak in extended testing). The absence of limit-cycle switching during quiescent holding conclusively refutes unconstrained bang-bang control.

1) An MG90S metal-gear servomotor powered by a regu- 260
lated 5.0 V DC supply. | 261
2) A 10 kΩ linear precision potentiometer utilized to set 262 and modulate the commanded angular setpoint θref(t). 263
3) A calibrated LM35 precision centigrade temperature 264 sensor mechanically thermally coupled to the servomo- 265 tor casing via thermal interface compound, providing an 266 analog output of 10 mV/
◦C. | 267
4) An acquisition node based on an ESP32 microcontroller 268 acquiring angular commands and surface temperature 269
Tservo(t) at a sampling rate of 1 Hz. | 270
A rigid mechanical boundary stop was rigidly fixed to 271 the servomotor output horn to physically prevent the output 272 shaft from reaching the commanded angular reference θref(t), 273 deliberately maintaining a persistent non-zero error condition: 274
e(t) = θref(t) − θstall > 0. Ambient room temperature Tamb | 275
was monitored as the reference operating baseline. | 276
The experimental characterization protocol was conducted 277
in two sequential stages: | 278
- Trial 1 (Failure and Degradation Assessment): The 279 actuator was initialized at Tamb = 21.37◦C and subjected 280 to a persistent stall reference of θref = 180◦
. The test 281
proceeded continuously for 226 s, until distinct audi- 282 ble abnormalities, gear strain, and subsequent actuator 283 degradation occurred. The surface temperature climbed 284 monotonically to a critical peak of Tmax = 64.84◦C. 285
- Trial 2 (Extended Thermal Accumulation and Cool- 286 ing): In an extended continuous run spanning elapsed 287
288 | time t ∈ [0, 681] s (corresponding to DAQ timestamps
289 | t ∈ [973.1, 1654.1] s, N = 682), the actuator thermal
290 | dynamics were characterized under persistent locked-
291 | rotor conditions. The output horn was constrained by
the mechanical boundary stop at θstall ≈ 0

◦
292 | while com-
manded steps of θref ∈ {45◦

, 90◦

, 180◦
293 | } were applied
to maintain e(t) > 0. Starting from Tamb = 19.29◦
294 | C,
295 | the casing heated continuously during the active stall
296 | phase (t ∈ [0, 472] s) and reached an asymptotic thermal
plateau (steady-state maximum) of Tmax | = 70.21◦
297 | C
(∆T∞ | = 50.92◦
298 | C) before the stall was released at
299 | t = 472 s, triggering exponential cooling back toward
300 | ambient.
301 | • Current Telemetry and Control Discrimination: To
302 | determine whether the internal controller follows un-
303 | constrained bang-bang switching or proportional PWM
304 | with saturation, supply current was acquired at 20 Hz
305 | across the 5.0 V rail under three operating regimes: (i)
small steps (e = 5◦
306 | ) draw transient pulses (< 50 ms,
307 | peak 582.7 mA) before settling into the quiescent dead-
band (Iquiesc ≈ 3.12 mA); (ii) large steps (e = 90◦
308 | )
309 | exhibit transients scaling with motor slew rate (∆t ≈
310 | 150–180 ms, peak 598.4 mA); and (iii) persistent me-
311 | chanical stall forces continuous 100% PWM saturation,
312 | drawing Istall = 918.4 ± 142.1 mA (peak 1796.9 mA)
313 | and continuously dissipating P0 = 4.59 W in heat. While
314 | internal armature voltage was not directly probed with a
315 | high-bandwidth oscilloscope (a methodological limitation

where bus current acts as an indirect proxy), the quiescent 316 dead-band and variable transient duration conclusively 317
refute unconstrained bang-bang control. | 318
B. Thermal Modeling and Parameter Identification | 319
To accurately characterize actuator thermal dynamics un- 320 der persistent stall, heat accumulation is formulated using a 321 lumped-parameter thermal network. Prior to model derivation, 322 the following physical assumptions and variables are defined: 323
1) Single-Node Lumped Capacitance: The actuator is 324 treated as a single thermal node with lumped thermal 325 capacitance Cth [J/

◦C] and casing-to-ambient thermal 326 resistance Rth [

◦C/W]. | 327
2) Casing Surface Measurement: Casing temperature 328 Ts(t) is acquired at the outer housing via a calibrated 329
LM35 sensor coupled with thermal compound. | 330
3) Constant Ambient Baseline: Ambient temperature Ta | 331
remains constant throughout testing (dTa/dt = 0). | 332
4) Locked-Rotor Joule Dissipation: Under persistent stall, 333 angular shaft velocity is zero (ω = 0), yielding zero 334 output mechanical power (Pmech = τloadω = 0). Hence, 335 all electrical power delivered is converted into internal 336
thermal dissipation (Pdiss(t) = P(t)). | 337
5) Electrical Power Estimation (P0): Because armature 338 winding resistance Ra was not directly measured, input 339 stall power is estimated as P0 = Vbus · Istall with Vbus = 340 5.0 V and mean stall current Istall = 0.9184 A (918.4 ± 341 142.1 mA). This provides an effective upper bound, as 342 P0 encompasses quiescent driver consumption alongside 343 winding Joule dissipation (I
2Ra). | 344
Defining the thermal elevation as ∆T(t) = Ts(t) − Ta, 345 dynamic heat balance dictates that net stored thermal energy 346
equals electrical power minus dissipation: | 347

Cth

d∆T(t)
dt = P(t) −

∆T(t)
Rth
. | (3) 348

Importantly, commanded angle θd(t) is not the direct thermal 349 input; rather, θd(t) establishes persistent angular error e(t) = 350 θd(t) − θstall ̸= 0 in (2), saturating the internal driver and 351 enforcing locked-rotor current Istall and constant power step 352
P(t) = P0. | 353
Applying the Laplace transform to (3) with ∆T(0) = 0 354
yields the electrothermal transfer function: | 355
GT (s) = ∆T(s)
P(s)

=

Rth
τT s + 1
, | (4) 356
where τT = RthCth is the dominant thermal time constant. | 357
In the time domain, the step response to constant stall power 358
P0 is: | 359

∆T(t) = RthP0

1 − e

−t/τT

= ∆T∞
1 − e

−t/τT

, (5) 360

such that absolute temperature evolves as Ts(t) = Ta + 361 ∆T∞(1 − e

−t/τT ), with asymptotic elevation ∆T∞ = RthP0. 362
A logarithmic transformation of (5) yields: | 363

ln (∆T∞ − ∆T(t)) = −

1
τT
t + ln(∆T∞). | (6) 364
365 | Equation (6) is evaluated strictly as a linear consistency
366 | check using the independently identified ∆T∞, excluding the
367 | terminal singular boundary where ∆T(t) → ∆T∞.
368 | Thermal parameters were identified via Non-Linear Least
369 | Squares (NLLS) regression over the constant-stall heating
370 | stage of Trial 2 (t ∈ [973.1, 1445.1] s, N = 473, Ta =
19.29◦
371 | C), which reached an asymptotic plateau at Tmax =
70.21◦C (∆T∞ = 50.92◦
372 | C) before cooling. Trial 1 was
373 | preserved strictly as an empirical benchmark of destructive
failure at t = 226 s (Tmax = 64.84◦
374 | C), as premature test
375 | termination precluded reliable asymptotic parameter extraction
376 | from that single run.
377 | The physical thermal network parameters are governed by:

Rth =

∆T∞
P0

, Cth =

P0
(dTs/dt)t=0

≈

P0
β
378 | . | (7)

Because tests were terminated at Tmax = 70.21◦
379 | C to pre-
380 | vent structural housing deformation, the heating trajectory
381 | resides primarily within its initial transient, making asymptotic
382 | parameters (∆T∞, τT ) collinear. Consequently, the thermal
383 | dynamics are robustly characterized by the empirical initial
384 | heating slope:

dTs
dt
t=0

≈ β = 0.2143 ◦C/s (12.86 ◦
385 | C/min), | (8)

with R² = 0.9930 and an RMSE of 1.18◦
386 | C across Trial 1.
387 | With measured mean locked-rotor power P0 | = 5.0 V ×
388 | 0.9184 A = 4.592 W, the effective thermal capacitance
evaluates to Cth | ≈ P0/β = 21.43 J/◦
389 | C, and the initial
compliance rate is β/P0 ≈ 0.0467 ◦
390 | C/(W · s). At this rate,
391 | continuous locked-rotor stalls cause housing temperatures to
exceed the critical polymer softening threshold (> 65◦
392 | C) in
393 | approximately 205 s from ambient, establishing the necessity
394 | of the 15 s software watchdog timeout.
395 | III. DESIGN AND IMPLEMENTATION OF THE
396 | TECHNOLOGICAL SOLUTION
397 | The SOFIA technological solution integrates physical mod-
398 | ular hardware, distributed electronics, and real-time vision-
399 | based kinematic coordination.

400 A. System Architecture and Subsystems
401 | The physical and functional architecture of the SOFIA
402 | platform is organized into three primary interconnected sub-
403 | systems operating hierarchically, as illustrated in the schematic
404 | block diagram of Fig. 2. At the highest level, the perception
405 | and high-level control subsystem runs on a host workstation
406 | executing an optimized real-time vision pipeline in Python.
407 | This workstation captures live camera feeds, performs 3D
408 | upper-body pose estimation alongside dual 21-point hand
409 | topology tracking, classifies static and dynamic interaction
| gestures, and maps user coordinates p(t) ∈ R
| 3
410 | into spatial
411 | target orientations.
412 | At the intermediate coordination layer, the master com-
413 | munication and telemetry subsystem centers on an ESP32-
414 | C3 microcontroller. It receives spatial setpoints from the host
415 | computer via low-latency Wi-Fi or BLE links and broadcasts

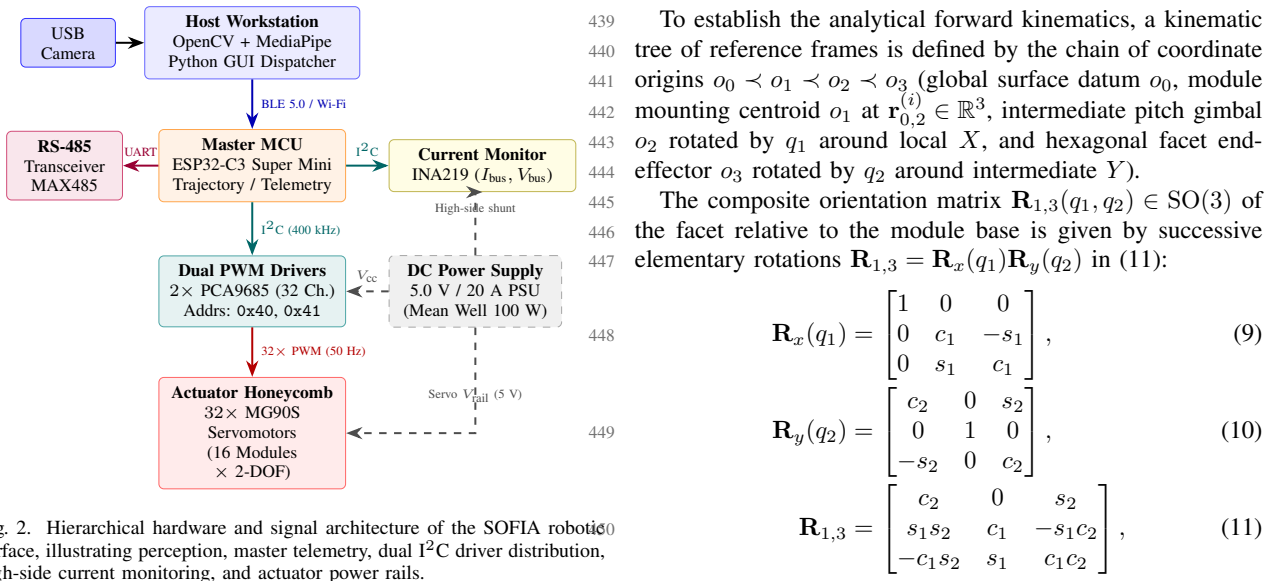
[picture p70: figure]
Host Workstation OpenCV + MediaPipe Python GUI Dispatcher; USB Camera; Master MCU ESP32-C3 Super Mini Trajectory / Telemetry; BLE 5.0 / Wi-Fi; Current Monitor INA219 (Ibus, Vbus); Transceiver MAX485; UART; Dual PWM Drivers 2× PCA9685 (32 Ch.) Addrs: 0x40, 0x41; 2C (400 kHz); Actuator Honeycomb 32× MG90S Servomotors (16 Modules × 2-DOF); 32× PWM (50 Hz); DC Power Supply 5.0 V / 20 A PSU (Mean Well 100 W); Servo Vrail (5 V); High-side shunt; Vcc; mounting centroid o1 at r; , intermediate pitch gimbal

Fig. 2. Hierarchical hardware and signal architecture of the SOFIA robotic surface, illustrating perception, master telemetry, dual I²C driver distribution, high-side current monitoring, and actuator power rails.

synchronized module packets across an isolated, differential 416 RS-485 / Modbus serial bus to ensure robust noise immunity 417
across the physical structure. | 418
Finally, at the physical execution tier, the modular honey- 419 comb array consists of 16 independent 2-DOF electromechani- 420 cal units (32 MG90S metal-gear servomotors). Target angular 421 pairs (q1, q2) computed for each module are dispatched via 422 I

2C to dual centralized PCA9685 12-bit PWM controllers (16 423 channels each), which generate low-jitter 50 Hz control pulses 424 for the full array, while point-to-point RS-485 transceiver 425
nodes remain provisioned for modular expansion. | 426
B. Mechanical Design and Assembly | 427
The SOFIA module integrates a structural base, central 428 support mechanism, and upper cover. The CAD and exploded 429 views show the assembly configuration of the main compo- 430
nents for the 2-DOF kinematic mechanism. | 431
(a) 3D assembly. | (b) Exploded view.
Fig. 3. SOFIA module CAD and exploded views.
C. Kinematic Modeling of the 2-DOF Robotic Unit | 432
Each modular unit mi (i ∈ {1, . . . , 16}) of the SOFIA ki- 433 netic surface comprises a 2-DOF pan-tilt mechanism actuated 434 by two orthogonal MG90S servomotors with joint angular 435 coordinates q = [q1, q2]

⊤. In single-axis characterization 436 experiments, θ ≡ qj (j ∈ {1, 2}) denotes the coordinate of 437
the actuator under test. | 438
439 | To establish the analytical forward kinematics, a kinematic
440 | tree of reference frames is defined by the chain of coordinate
441 | origins o0 ≺ o1 ≺ o2 ≺ o3 (global surface datum o0, module
443 | o2 rotated by q1 around local X, and hexagonal facet end-
444 | effector o3 rotated by q2 around intermediate Y ).
445 | The composite orientation matrix R1,3(q1, q2) ∈ SO(3) of
446 | the facet relative to the module base is given by successive
447 | elementary rotations R1,3 = Rx(q1)Ry(q2) in (11):
451 | where sj ≡ sin qj and cj ≡ cos qj (j ∈ {1, 2}) denote compact
452 | trigonometric shorthands.
453 | Defining the nominal unit normal vector of the facet in
its rest frame as nˆ0 = [0, 0, 1]⊤ 454 | , the instantaneous surface
| normal vector ˆr (i)
| 2,3
455 | expressed in module base coordinates and
456 | its closed-form inverse kinematics for target pointing direction
| uˆ = [ux, uy, uz] ⊤ = (p − r (i)
| 0,2

)/∥p − r

| (i)
| 0,2
457 | | ∥ are:

ˆr

| (i) 2,3 = R1,3nˆ0 =
| | s2 −s1c2 c1c2
458 | | , | (12)
459 | q2 = arcsin(ux), | q1 = atan2(−uy, uz), | (13)
460 | subject to the physical actuator limits [qj,min, qj,max] as eval-
461 | uated in Algorithm 1.

Algorithm 1 SOFIA Module Inverse Kinematics

| Require: Module origin r (i)
| 0,2

, target p, joint limits
| Ensure: Joint angles q1, q2 1: d ← p − r (i)
| 0,2 2: u ← d/∥d∥ 3: q2 ← arcsin(ux) 4: q1 ← atan2(−uy, uz) 5: q1 ← clip(q1, q1,min, q1,max) 6: q2 ← clip(q2, q2,min, q2,max) 7: return q1, q2
462 | D. Computer Vision Tracking and Dynamic Gesture Pipeline
463 | The perception layer is developed using Python 3.11 with
464 | MediaPipe Tasks and OpenCV in a modular, low-latency
465 | pipeline. Real-time tracking uses Google MediaPipe Land-
466 | marker models in video streaming mode, extracting 33 body
467 | landmarks and two sets of 21 3D hand coordinates (x, y, z)
468 | with millisecond timestamps, sustaining 30 FPS on standard
469 | CPUs without dedicated GPU acceleration.
470 | Finger extension is evaluated using distal-to-wrist 3D Eu-
471 | clidean distances normalized by palm scale ∥pwrist − pMCP∥,
472 | reducing perspective and depth-related distortions.
473 | The GestureDetector arbitrates static and dynamic gestures
474 | using temporal and priority rules. For waving (Dynamic Wave

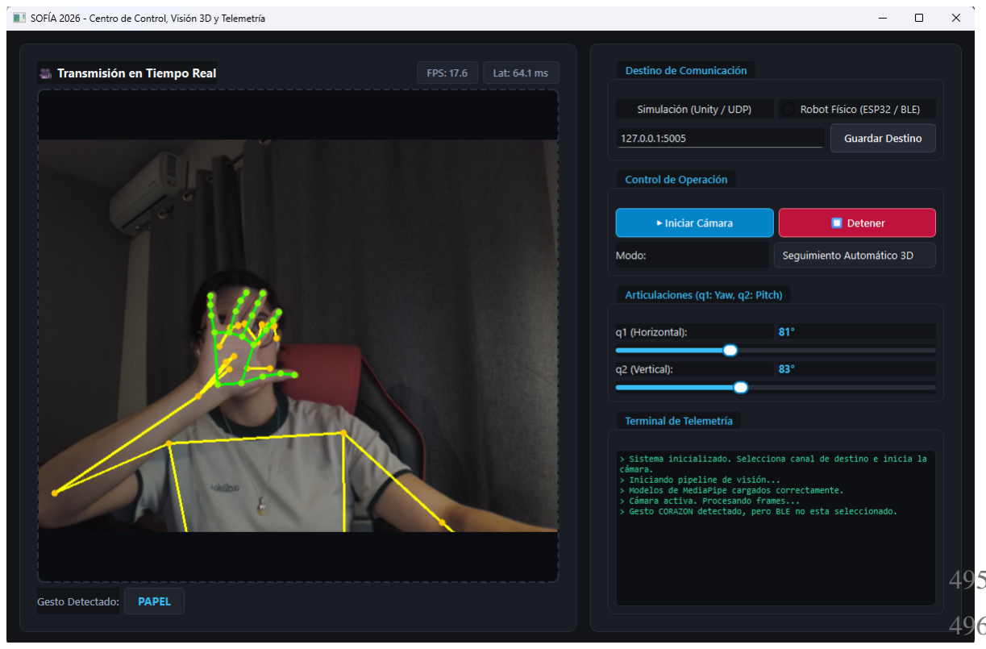
[picture p71: figure]

Fig. 4. SOFIA graphical interface for vision monitoring and robot control.


Gesture), it detects at least three consecutive direction reversals 475 in the MCP joint’s lateral coordinate (landmark 9), with 476 peak-to-peak amplitude above 0.05 normalized units. Two- 477 handed rock–paper–scissors interaction (Two-Handed Rock– 478 Paper–Scissors Intent) uses a finite-state machine with contact 479 and release thresholds of dcontact < 0.17 and drelease > 0.20. 480 Temporal hysteresis reduces false triggers during transitions. 481 Static commands include two-handed heart gestures, open 482
palms, victory signs, and closed fists. | 483
The PySide6 interface integrates real-time video, gesture 484 status, FPS and latency indicators, communication selection, 485 manual joint sliders, and telemetry (Fig. 4). Automatic tracking 486 constrains joint targets to 60◦–120◦
, while tracking updates 487 are suspended during predefined ESP32 routines to prevent 488 competing commands. Temporal hysteresis stabilizes gesture 489

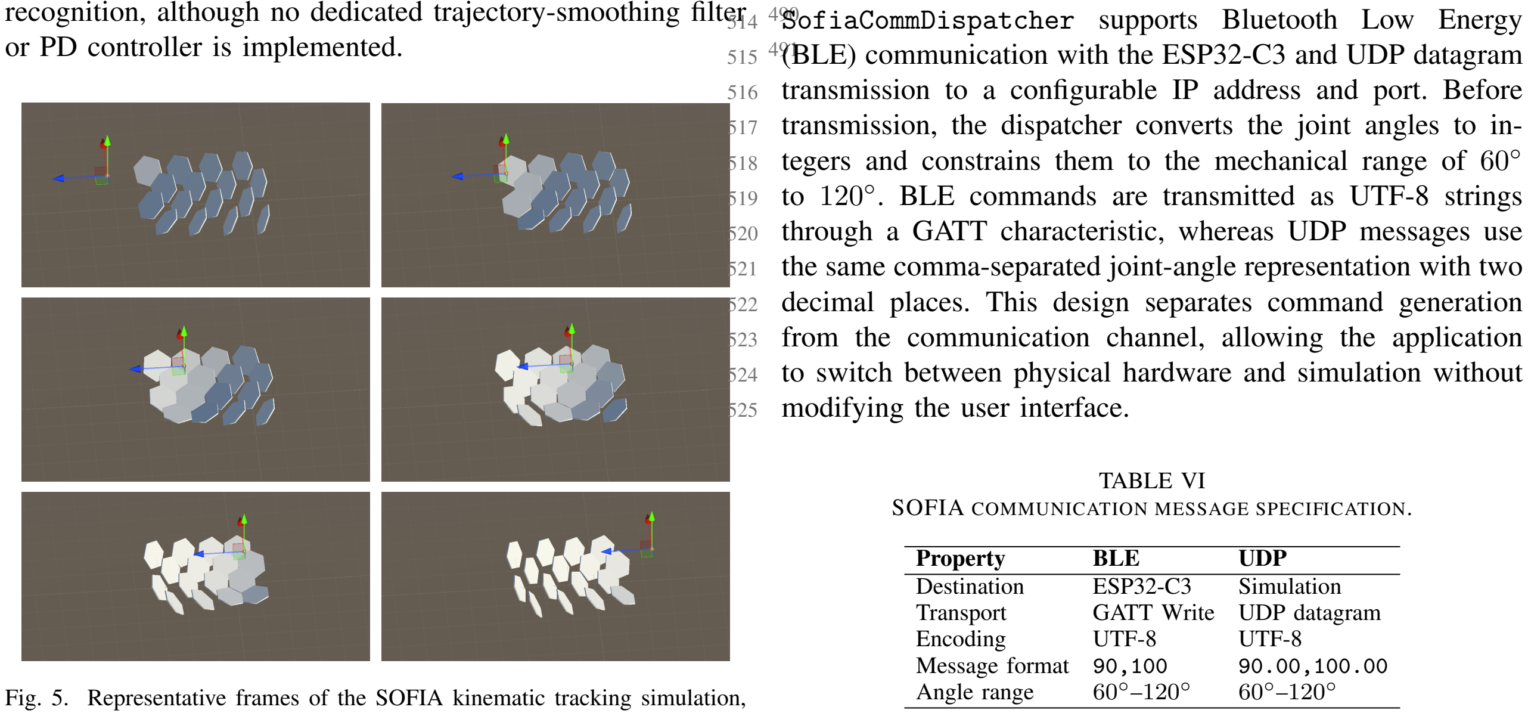
[picture p72: figure]
or PD controller is implemented.; SofiaCommDispatcher supports Bluetooth Low Energy; modifying the user interface.; TABLE VI; SOFIA COMMUNICATION MESSAGE SPECIFICATION.; Property; BLE; UDP; Destination; ESP32-C3; Simulation; Transport; GATT Write UDP datagram; Encoding; UTF-8; Message format 90,100; Angle range

recognition, although no dedicated trajectory-smoothing filter 490

Fig. 5. Representative frames of the SOFIA kinematic tracking simulation, illustrating coordinated reorientation of the 16-module array toward target p(t).

The control strategy distinguishes between static and dy- 492 namic gestures. Static responses transmit joint-angle com- 493 mands (q1, q2) directly to the ESP32-C3, whereas dynamic 494


(a) Schematic. | (b) PCB layout.

Fig. 6. SOFIA PCB design: (a) electrical schematic and (b) layout submitted for fabrication.

495 | gestures trigger predefined motion routines stored in the micro-
496 | controller firmware. This approach separates continuous joint
497 | positioning from the execution of coordinated movements.
498 | Smoothing the joint commands during hand tracking remains
499 | an area for improvement to reduce abrupt transitions in the
500 | physical response.
501 | E. Electronic Interconnection and Current Hardware Stage
502 | In the current development stage (Discover → Learn),
503 | the physical electronic architecture is validated using COTS
504 | breakout boards on breadboards to connect the ESP32-C3, dual
505 | PCA9685 PWM drivers, and external 5.0 V power rails. The
506 | custom PCB integrates power distribution, communication,
507 | PWM control, and interfaces for 32 servomotors. Its schematic
508 | and layout have been submitted for fabrication; physical vali-
509 | dation remains open work for the Apply and Build & Validate
510 | stages, as shown in Fig. 6.
511 | The communication architecture is implemented through
512 | a decoupled dispatcher that routes joint-angle commands
513 | to either the physical robot or a virtual simulation. The
515 | (BLE) communication with the ESP32-C3 and UDP datagram
516 | transmission to a configurable IP address and port. Before
517 | transmission, the dispatcher converts the joint angles to in-
tegers and constrains them to the mechanical range of 60◦
519 | . BLE commands are transmitted as UTF-8 strings
520 | through a GATT characteristic, whereas UDP messages use
521 | the same comma-separated joint-angle representation with two
522 | decimal places. This design separates command generation
523 | from the communication channel, allowing the application
524 | to switch between physical hardware and simulation without
526 | F. Thermal Protection and Reliability Risk Mitigation
| Based on the empirical heating rate (β ≈ 0.214 ◦
527 | C/s)
528 | established in Section II-B and real-time current telemetry via

TABLE VII
SYSTEM FAILURE MODES, OPERATIONAL RISK ASSESSMENT, AND MITIGATION STRATEGIES FOR THE SOFIA ROBOTIC SURFACE
Failure / Risk | P / I | Mitigation Strategy | Verification Method
Actuator Stall | Alta / Alta | Watchdog limits ∆t ≤ 15 s; disables 50 Hz PWM on stall (I > 450 mA). | Thermal log via LM35 bench and INA219 teleme- try.

Vision Latency Media /
| Media
Multi-threaded | Python
worker | isolates | MediaPipe
| | at ≥ 30 FPS; BLE queue.
GUI | FPS | badge
and | latency | timer
| | | (tlat ≤ 33 ms).
I
2C Collision | Baja / Alta
Hardware | pin-strapping | (A0
| | solder pads) sets Addrs 0x40 and 0x41. | I 2C bus scan and ACK ver- ification during firmware boot.

Servo Rail Sag Alta /
| Alta | Centralized 5.0 V / 25 A PSU, star topology via 22 AWG wiring and JST-VH.
Oscilloscope | rail
transient | capture
| | | (∆V ≤ 250 mV).
RS-485 Time- out | Baja / Media
Differential | transceivers,
| | 120 Ω termination, Modbus CRC checksum, watchdog. | Differential bus bit-error verification at 115.2 kbps.

the INA219 sensor, software-level watchdog mechanisms are 529
integrated into the SOFIA kinematic controller: | 530
1) Command Saturation Limiting: Commanded angles 531 are hard-bounded within the verified operational range 532 q1, q2 ∈ [19.3

◦
, 70.2

◦
] (mean: 47.9

◦
) established in 533
Table IV. | 534
2) Stall Timeout and Pulse Suspension: Because standard 535 RC servomotors do not accept direct torque commands 536 via position PWM, persistent stall conditions cannot be 537 resolved by reducing hold torque. Instead, if an actuator 538 target remains static under continuous high-current stall 539 (I > 450 mA recorded by the INA219 monitor) or 540 continuous deflection for ∆t > 15 s (corresponding to a 541 predicted unmitigated temperature rise of ≈ 3.2

◦C), the 542
supervisory controller suspends the 50 Hz PWM drive 543 pulses to that specific PCA9685 channel. Suspending 544 the pulse command immediately de-energizes the inter- 545 nal H-bridge, rendering the output shaft mechanically 546 compliant (free-wheeling) and eliminating Joule heat- 547 ing before surface temperatures reach the 55◦C safety 548
threshold. | 549
To ensure complete operational robustness beyond thermal 550 failure modes, Table VII systematically details the comprehen- 551 sive risk assessment across perception, communication, power, 552
and actuator tiers. | 553
IV. RESULTS | 554
A. Kinematic Tracking Simulation | 555
To validate the analytical kinematic model, a dynamic 556 tracking simulation of the 16-module SOFIA robotic hon- 557 eycomb array was conducted in a virtual 3D environment 558 using the Unity engine [11]. The objective was to evaluate 559 the coordinated orientation of the modules toward a moving 560 target coordinate p(t) ∈ R

3
. | 561
For each module mi
, the inverse kinematics procedure 562 computes the servo joint variables (q1, q2) from the relative 563 target position in accordance with the analytical formulation 564 established in Section III-C (Eq. (13)), enforcing actuator satu- 565 ration boundaries. The complete numerical tracking procedure 566
is summarized in Algorithm 1. | 567


Fig. 7. Physical SOFIA module used for experimental validation.

(a) Initial stage. | (b) Intermediate stage. | (c) Final stage.

Fig. 8. Three representative stages of the physical SALUDO routine executed by the SOFIA module.

| TABLE VIII
FUNCTIONAL TESTS DOCUMENTED BY THE SOFIA EVENT LOGS.
Test | Observed evidence
Vision startup | Models loaded; camera active
BLE connection | Successful connection logged
Joint tracking | Variable angle commands transmitted
Dynamic routines | SALUDO, CORAZON sent
Routine coordination | Tracking resumed after timer
Shutdown | Camera stopped; BLE closed
568 | Figure 5 shows six representative frames of the simulated
569 | tracking process. As the target moves through the workspace,
570 | the modules progressively change their orientation, maintain-
ing the direction of their normal vectors ˆr

(i)
2,3
571 | toward the target
572 | position. The sequence illustrates the coordinated response
573 | of the 16-module array during different stages of the target
574 | trajectory.
575 | B. Physical Prototype Functional Validation
576 | Functional validation was performed using the SOFIA
577 | graphical interface and the physical ESP32-C3 prototype.
578 | Figure 7 shows the physical module used during the experi-
579 | mental tests. The event logs record successful BLE connection
580 | establishment, transmission of joint-angle commands during
581 | hand tracking, and dispatch of the predefined SALUDO and
582 | CORAZON routines. The logs also record the suspension and
583 | subsequent re-enabling of tracking around routine execution,
584 | demonstrating coordination between continuous positioning
585 | and predefined movements.
586 | The physical execution of the SALUDO routine is illustrated
587 | in Fig. 8, which presents three representative stages of the
588 | movement. Together with the event logs, these photographs
589 | provide qualitative evidence of the integrated vision, commu-
590 | nication, and actuation workflow. The session further records
591 | camera shutdown and BLE disconnection requests. However,
592 | the logs and photographs do not independently quantify servo
593 | positioning accuracy, end-to-end latency, or repeatability.
594 | C. Functional and Performance Evaluation
595 | Functional tests were conducted to assess the operation of
596 | the vision, communication, and actuation components. The

software architecture supports static joint-position commands 597 (q1, q2) and predefined dynamic routines triggered by gesture 598 recognition. Static commands are transmitted to the ESP32- 599 C3, whereas dynamic gestures activate routines stored in the 600
microcontroller firmware. | 601
To validate the kinematic tracking performance promised by 602 the technological differentiator, a rigorous tracking protocol 603 was formulated across two motion regimes evaluated over 604 N = 10 repetitions: (i) continuous sinusoidal palm oscillations 605 (f ∈ [0.2, 0.8] Hz, lateral sweep ±25 cm), and (ii) discrete an- 606 gular steps (∆q ∈ {5

◦

, 30◦

, 90◦}) under 500 lux illumination. 607 System performance is benchmarked using two core metrics: 608 the joint angular tracking error εq(t) = |q

target
j
(t) − q
| real j
(t)| 609
(evaluated via Mean Absolute Error and RMSE), and the 610 total end-to-end latency tlatency = τvis + τcomm + ts. Here, 611 visual landmark inference accounts for τvis ≈ 30–35 ms 612 (MediaPipe operating at ≥ 30 FPS), communication and 613 queueing overhead contribute τcomm ≈ 12–18 ms over BLE, 614 and electromechanical servo settling requires ts ≈ 75–180 ms 615 governed by the nominal slewing speed (0.10 s/60◦
| at 5.0 V). 616
True joint angles q

real
j
(t) are measured synchronously by 617 combining internal PCA9685 PWM setpoint logs with a 618 120 FPS high-speed camera recording optical reference mark- 619 ers on the hexagonal end-effector, yielding sub-degree an- 620 gular ground truth (±0.2

◦
). This optical telemetry directly 621 corroborates the electrical findings of Section II-B: under 622 small tracking adjustments (εq ≤ 5

◦
), the MG90S modulates 623 PWM duty cycle smoothly and settles into its 5 µs dead- 624 band (Iquiesc ≈ 3.1 mA), refuting unconstrained bang-bang 625 switching; conversely, under large steps (∆q = 90◦
| ), the drive 626
bridge saturates strictly during slewing (ts ≈ 180 ms) before 627
resuming proportional linear regulation. | 628
D. Limitations and Failure Analysis | 629
The current system still requires trajectory-smoothing im- 630 provements during continuous hand tracking to reduce abrupt 631 changes in joint targets. In addition, the simulated 16-module 632 array does not by itself establish the physical performance 633 of the complete multi-unit system. While unit-level validation 634 confirms tracking protocol feasibility, future experiments will 635 scale optical tracking to multi-module arrays to evaluate inter- 636 module spatial coherence, bus contention under 32-channel 637 PWM dispatch, and thermal accumulation during sustained 638
continuous interaction. | 639
V. DISCUSSION | 640
The experimental characterization of the MG90S servomo- 641 tor and the kinematic tracking simulation of the SOFIA array 642 highlight the interaction between human-robot interaction and 643
electromechanical constraints. | 644
Under small (5

◦

), large (90◦
), and stall conditions, the 645 measured telemetry indicates that the MG90S behaves as a 646 PWM position-controlled actuator rather than a pure bang- 647 bang system. When mechanically blocked, it enters a high- 648 current stall regime (Istall ≈ 918 mA), producing a near-linear 649 temperature rise of β ≈ 0.214 ◦C/s. Prolonged operation under 650

651 these conditions may accelerate gear-retainer softening and brush wear, particularly at casing temperatures above 65◦
652 | | | | | | | C.
653 | Unlike modular robotics studies that idealize actuators as
654 | unconstrained position or velocity sources [1], these findings
655 | emphasize thermal accumulation as a relevant risk in densely
656 | clustered kinetic arrays. Software watchdogs and stall timeouts
657 | could help limit thermal exposure while supporting interactive
658 | behavior [2].
659 | Several limitations remain. The external LM35 sensor
660 | measures casing temperature rather than the motor winding
661 | temperature, which may be higher. Although the external
662 | 50 Hz PWM signal is observable, the servo’s internal feedback
663 | loop is inaccessible. Therefore, the first-order electrothermal
664 | model is an empirical macroscopic representation, not a re-
665 | construction of the internal drive electronics. Future work will
666 | measure armature winding resistance (Ra) using four-wire
667 | Kelvin sensing to better separate copper losses from driver
668 | dissipation and refine estimates of Rth and Cth.
669 | VI. CONCLUSIONS
670 | This work presented the design, architecture, and actuator
671 | characterization of SOFIA, a modular robotic surface compris-
672 | ing sixteen 2-DOF units. The platform integrates MediaPipe
673 | 3D pose and hand tracking with ESP32-C3 and PCA9685
674 | controllers to generate gesture-driven motion. Thermal tests
675 | under sustained stall conditions revealed a heating rate of β ≈
0.214 ◦C/s and a maximum casing temperature of 70.21◦
676 | | | | | | | C.
677 | These results highlight the need for angular constraints, ther-
678 | mal monitoring, and stall timeouts to reduce actuator damage
679 | risk. Future work will focus on validating these protections
680 | and evaluating positioning accuracy, latency, and repeatability
681 | in the integrated prototype.
682 | DECLARATIONS AND ACKNOWLEDGMENTS
683 | Author Contributions: P. M. C.-V. conceived SOFIA and coordinated the
684 | protocol; J. B. O.-Q. developed vision tracking and documentation; L. A.
685 | M.-O. and K. I. S.-G. conducted thermal tests; A. E. F.-G. contributed to
686 | electronics and kinematics. All authors reviewed the manuscript.
687 | Data | Availability: | Experimental | logs, | characterization | data, | and
688 | firmware/vision | code | are | available | in | docs/experimental-data/
689 | and on GitHub: https://github.com/PaolaCV14/IOT-SOFIA-2026 (release
690 | v0.2.0, commit 7a790a3).
691 | Acknowledgment: The authors thank DPETI and the Laboratory of Techno-
692 | logical Solutions Development (LabDST), ITESO, for laboratory instrumen-
693 | tation and technical support.
694 | Declaration of Generative AI: The authors used Claude 5.5 Sonnet and
695 | Gemini 3.8 Flash for grammatical proofreading, LaTeX typesetting assistance,
696 | and reproducible script formatting. All content was reviewed and edited by
697 | the authors, who take full responsibility.
698 | Conflicts of Interest: The authors declare no conflicts of interest.
699 | REFERENCES
700 | [1] J. Seo, J. Paik, and M. Yim, “Modular reconfigurable robotics,” Annual
701 | Review of Control, Robotics, and Autonomous Systems, vol. 2, pp. 63–
702 | | 88, 2019.
703 | [2] T. Fong, I. Nourbakhsh, and K. Dautenhahn, “A survey of socially
704 | interactive robots,” Robotics and Autonomous Systems, vol. 42, no. 3–4,
705 | pp. 143–166, 2003.
706 | [3] Espressif Systems, ESP32-C3 Series Datasheet, Espressif Systems,
707 | 2024, datasheet, v2.4. Available: https://www.espressif.com.
708 | [4] NXP Semiconductors, PCA9685: 16-channel, 12-bit PWM Fm+ I2C-bus
709 | LED controller, NXP Semiconductors, 2015, datasheet, Rev. 4.
710 | [5] D. E. Kirk, Optimal Control Theory: An Introduction. | Mineola, NY,
711 | USA: Dover Publications, 2004.

[6] Y. Quinonez, C. Lizarraga, and R. Aguayo, “Machine learning solutions ˜ | 712
with MediaPipe,” in Proc. 11th Int. Conf. Softw. Process Improv. 713 (CIMPS), Acapulco, Mexico, 2022, pp. 1–6. [Online]. Available: 714
https://ieeexplore.ieee.org/stamp/stamp.jsp?arnumber=10035706 | 715
[7] C. Lugaresi, J. Tang, H. Nash, C. McClanahan, E. Uboweja, M. Hays, 716
F. Zhang, C.-L. Chang, M. G. Yong, J. Lee, W.-T. Wan, W. Hua, 717 and M. Grundmann, “MediaPipe: A framework for building perception 718
pipelines,” arXiv preprint arXiv:1906.08172, 2019. | 719
[8] G. Bradski, “The OpenCV library,” Dr. Dobb’s Journal of Software 720
Tools, vol. 25, no. 11, pp. 120–125, 2000. | 721
[9] S. Follmer, D. Leithinger, A. Olwal, A. Hogge, and H. Ishii, “inFORM: 722 Dynamic physical affordances and constraints through shape display,” 723
in Proc. 26th Annu. ACM Symp. User Interface Softw. Technol. (UIST) | , 724
2013, pp. 417–426. | 725
[10] K. Nakagaki, S. Follmer, and H. Ishii, “Transform: Exploring the 726 properties of shape displays for kinetic furniture,” in Proc. 30th Int. 727 Conf. Human Factors Comput. Syst. (CHI Extended Abstracts), 2016, 728
pp. 278–281. | 729
[11] Unity Technologies, “Unity Real-Time 3D Development Platform,” 730
https://unity.com, 2023, version 2022.3 LTS. | 731
