PaolaCV14/IOT-SOFIA-2026/docs/experimental-data/servo_characterization.xlsx

Sheet: ROTO 1
Tiempo (s) | Ángulo (°) | Temperatura (°C)
1 | 180 | 21.37
2 | 140 | 21.25
3 | 125 | 21.12
4 | 168 | 20.88
5 | 180 | 21.12
6 | 180 | 21
7 | 180 | 21.37
8 | 180 | 21.25
9 | 180 | 21.12
10 | 180 | 21
11 | 180 | 20.63
12 | 180 | 20.88
13 | 180 | 21.25
14 | 180 | 21.12
15 | 180 | 20.63
16 | 180 | 21.12
17 | 180 | 21.49
18 | 180 | 21.12
19 | 180 | 21.37
20 | 180 | 21.37
21 | 180 | 21.49
22 | 180 | 21.49
23 | 180 | 21.49
24 | 180 | 21.49
25 | 180 | 21.49
26 | 180 | 21.73
27 | 180 | 21.61
28 | 180 | 21.86
29 | 180 | 21.86
30 | 180 | 21.73
31 | 180 | 22.1
32 | 180 | 22.22
33 | 180 | 22.71
34 | 180 | 22.59
35 | 180 | 22.59
36 | 180 | 22.83
37 | 180 | 23.2
38 | 180 | 23.2
39 | 180 | 23.93
40 | 180 | 23.81
41 | 180 | 23.44
42 | 180 | 23.93
43 | 180 | 24.05
44 | 180 | 23.93
45 | 180 | 24.3
46 | 180 | 24.3
47 | 180 | 24.91
48 | 180 | 25.03
49 | 180 | 25.15
50 | 180 | 25.4
51 | 180 | 25.4
52 | 180 | 25.52
53 | 180 | 25.76
54 | 180 | 25.76
55 | 180 | 26.25
56 | 180 | 26.13
57 | 180 | 26.86
58 | 180 | 27.11
59 | 180 | 27.47
60 | 180 | 27.72
61 | 180 | 28.08
62 | 180 | 28.08
63 | 180 | 28.45
64 | 180 | 28.33
65 | 180 | 28.94
66 | 180 | 29.3
67 | 180 | 29.3
68 | 180 | 29.3
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
