PaolaCV14/IOT-SOFIA-2026/docs/experimental-data/datos_5grados.csv

Tiempo_s | Angulo_deg | Temperatura_C | Corriente_mA | Voltaje_V
1.03 | 69 | 26.3 | 2.9 | 5.02
1.08 | 69 | 26.3 | 582.7 | 4.87
1.13 | 69 | 26.3 | 517.5 | 4.9
1.18 | 69 | 26.3 | 14.4 | 5.01
1.23 | 69 | 26.3 | 3.4 | 5.02
1.28 | 69 | 26.3 | 3 | 5.01
1.33 | 69 | 26.3 | 3.2 | 5.01
1.38 | 69 | 26.3 | 3.2 | 5.01
1.43 | 69 | 26.3 | 3.1 | 5.01
1.48 | 69 | 26.3 | 3 | 5.02
1.53 | 69 | 26.3 | 3 | 5.02
1.58 | 69 | 26.3 | 3.3 | 5.01
1.63 | 69 | 26.3 | 2.8 | 5.02
1.68 | 69 | 26.3 | 2.8 | 5.02
1.73 | 69 | 26.3 | 3.1 | 5.02
1.78 | 69 | 26.3 | 2.8 | 5.02
1.83 | 69 | 26.3 | 3.2 | 5.01
1.88 | 69 | 26.3 | 3.2 | 5.02
1.93 | 69 | 26.3 | 2.7 | 5.02
1.98 | 69 | 26.3 | 2.9 | 5.01
2.03 | 69 | 26.2 | 3.1 | 5.02
2.08 | 69 | 26.2 | 2.9 | 5.02
2.13 | 69 | 26.2 | 3.2 | 5.02
2.18 | 69 | 26.2 | 3.1 | 5.02
2.23 | 69 | 26.2 | 2.9 | 5.01
2.28 | 69 | 26.2 | 2.9 | 5.02
2.33 | 69 | 26.2 | 3.2 | 5.02
2.38 | 69 | 26.2 | 3.1 | 5.02
2.43 | 69 | 26.2 | 3.1 | 5.02
2.48 | 69 | 26.2 | 2.9 | 5.02
2.53 | 69 | 26.2 | 3 | 5.02
2.58 | 69 | 26.2 | 3.2 | 5.01
2.63 | 69 | 26.2 | 3.3 | 5.01
2.68 | 69 | 26.2 | 3.3 | 5.01
2.73 | 69 | 26.2 | 3.2 | 5.02
2.78 | 69 | 26.2 | 3 | 5.01
2.83 | 69 | 26.2 | 3 | 5.02
2.88 | 69 | 26.2 | 3 | 5.02
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
