PaolaCV14/IOT-SOFIA-2026/docs/experimental-data/datos_901.csv

Tiempo_s | Angulo_deg | Temperatura_C | Corriente_mA | Voltaje_V
1.03 | 47 | 28.8 | 3.3 | 5.01
1.08 | 47 | 28.8 | 541.1 | 4.82
1.13 | 47 | 28.8 | 76.6 | 5
1.18 | 47 | 28.8 | 2.8 | 5.01
1.23 | 47 | 28.8 | 3.2 | 5.02
1.28 | 47 | 28.8 | 3.2 | 5.02
1.33 | 47 | 28.8 | 3.1 | 5.02
1.38 | 47 | 28.8 | 3.1 | 5.02
1.43 | 47 | 28.8 | 3.1 | 5.01
1.48 | 47 | 28.8 | 3 | 5.02
1.53 | 47 | 28.8 | 3.1 | 5.02
1.58 | 47 | 28.8 | 2.9 | 5.02
1.63 | 47 | 28.8 | 3.2 | 5.01
1.68 | 47 | 28.8 | 3 | 5.02
1.73 | 47 | 28.8 | 3.1 | 5.01
1.78 | 47 | 28.8 | 3.1 | 5.02
1.83 | 47 | 28.8 | 3.1 | 5.02
1.88 | 47 | 28.8 | 3.3 | 5.02
1.93 | 47 | 28.8 | 3 | 5.01
1.98 | 47 | 28.8 | 3.2 | 5.01
2.03 | 47 | 28.8 | 3.2 | 5.02
2.08 | 47 | 28.8 | 3.3 | 5.02
2.13 | 47 | 28.8 | 3.6 | 5.02
2.18 | 47 | 28.8 | 21.7 | 5.02
2.23 | 47 | 28.8 | 2.9 | 5.01
2.28 | 47 | 28.8 | 3.1 | 5.02
2.33 | 47 | 28.8 | 3.1 | 5.01
2.38 | 47 | 28.8 | 3.2 | 5.02
2.43 | 47 | 28.8 | 2.9 | 5.02
2.48 | 47 | 28.8 | 3.1 | 5.01
2.53 | 47 | 28.8 | 3.3 | 5.02
2.58 | 47 | 28.8 | 2.9 | 5.01
2.63 | 47 | 28.8 | 3.2 | 5.01
2.68 | 47 | 28.8 | 3 | 5.01
2.73 | 47 | 28.8 | 3 | 5.02
2.78 | 47 | 28.8 | 3.1 | 5.02
2.83 | 47 | 28.8 | 3.1 | 5.02
2.88 | 47 | 28.8 | 2.9 | 5.01
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
