PaolaCV14/IOT-SOFIA-2026/docs/experimental-data/datos_CHIDOS_DE_FORZADO.csv

Tiempo_s | Angulo_deg | Temperatura_C | Corriente_mA | Voltaje_V
1.03 | 0 | 31.1 | 184.1 | 4.94
1.08 | 0 | 31.1 | 192.7 | 4.95
1.13 | 0 | 31.1 | 168.4 | 4.97
1.18 | 0 | 31.1 | 166.5 | 4.97
1.23 | 0 | 31.1 | 191.4 | 4.98
1.28 | 0 | 31.1 | 197.4 | 4.95
1.33 | 0 | 31.1 | 193.4 | 4.96
1.38 | 0 | 31.1 | 268.1 | 4.98
1.43 | 0 | 31.1 | 191.1 | 4.95
1.48 | 0 | 31.1 | 63.1 | 4.92
1.53 | 0 | 31.1 | 155.8 | 4.97
1.58 | 0 | 31.1 | 179.5 | 4.96
1.63 | 0 | 31.1 | 186.4 | 4.96
1.68 | 0 | 31.1 | 177.6 | 4.96
1.73 | 0 | 31.1 | 178.3 | 4.96
1.78 | 0 | 31.1 | 186.7 | 4.96
1.83 | 0 | 31.1 | 179.1 | 4.96
1.88 | 0 | 31.1 | 178 | 4.96
1.93 | 0 | 31.1 | 178.1 | 4.96
1.98 | 0 | 31.1 | 255.8 | 4.95
2.03 | 0 | 31.2 | 156 | 4.98
2.08 | 0 | 31.2 | 108.5 | 4.96
2.13 | 0 | 31.2 | 109.8 | 4.96
2.18 | 0 | 31.2 | 171.6 | 4.93
2.23 | 0 | 31.2 | 253.9 | 4.95
2.28 | 0 | 31.2 | 173.6 | 4.96
2.33 | 0 | 31.2 | 246 | 4.96
2.38 | 0 | 31.2 | 178.5 | 4.97
2.43 | 0 | 31.2 | 104.5 | 4.94
2.48 | 0 | 31.2 | 170.9 | 4.97
2.53 | 0 | 31.2 | 209.6 | 4.95
2.58 | 0 | 31.2 | 174.6 | 4.96
2.63 | 0 | 31.2 | 130.5 | 4.97
2.68 | 0 | 31.2 | 202.4 | 4.98
2.73 | 0 | 31.2 | 170.8 | 4.95
2.78 | 0 | 31.2 | 167.5 | 4.96
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
