PaolaCV14/IOT-SOFIA-2026/paper/Equipo 1 - respuesta - segundo corte/figures/fig_characterization_6panels.pdf

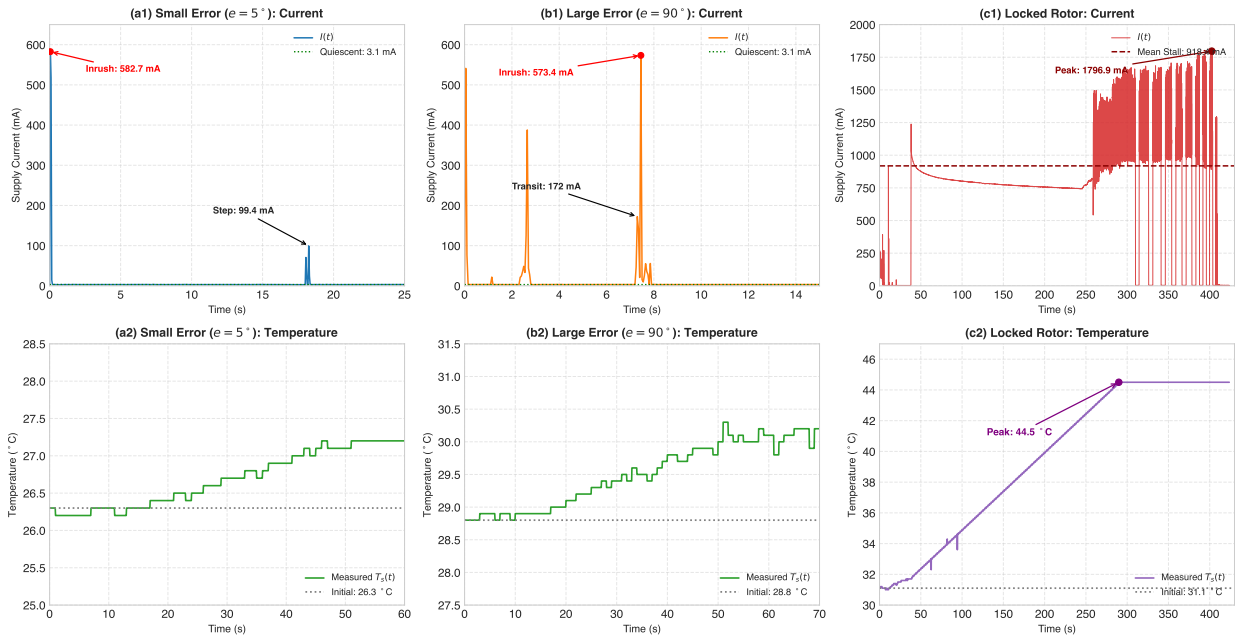
[picture p82: page 1]
Time (s); Inrush: 582.7 mA; (a1) Small Error (e = 5; ): Current; Quiescent: 3.1 mA; Inrush: 573.4 mA; (b1) Large Error (e = 90; Peak: 1796.9 mA; Temperature (; (a2) Small Error (e = 5; ): Temperature; (b2) Large Error (e = 90; Peak: 44.5

(c1) Locked Rotor: Current

Mean Stall: 918.4 mA

Supply Current (mA)

Transit: 172 mA

Step: 99.4 mA

(c2) Locked Rotor: Temperature

Measured Ts(t) Initial: 26.3 | ∘ C

Measured Ts(t) Initial: 28.8 | ∘ C

Measured Ts(t)
Initial: 31.1 | ∘ C
