PaolaCV14/IOT-SOFIA-2026/paper/Equipo 1 - respuesta - segundo corte/figures/fig_current_characterization.pdf

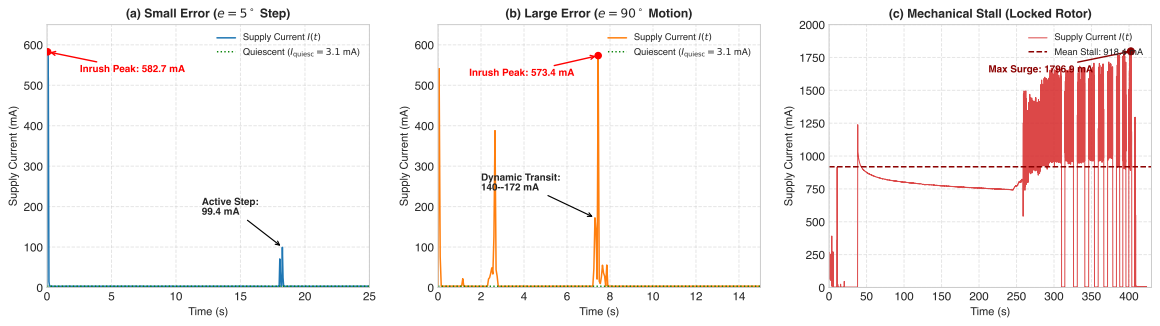
[picture p83: page 1]
Time (s); Active Step: 99.4 mA; (a) Small Error (e = 5; ∘ Step); Dynamic Transit: 140--172 mA; (b) Large Error (e = 90; ∘ Motion)

(c) Mechanical Stall (Locked Rotor)

Supply Current I(t)
Quiescent (Iquiesc = 3.1 mA)

Mean Stall: 918.4 mA

Inrush Peak: 582.7 mA

Max Surge: 1796.9 mA

Inrush Peak: 573.4 mA

Supply Current (mA)
