PaolaCV14/IOT-SOFIA-2026/paper/Equipo 1 - segundo corte/figures/fig_thermal_response.pdf

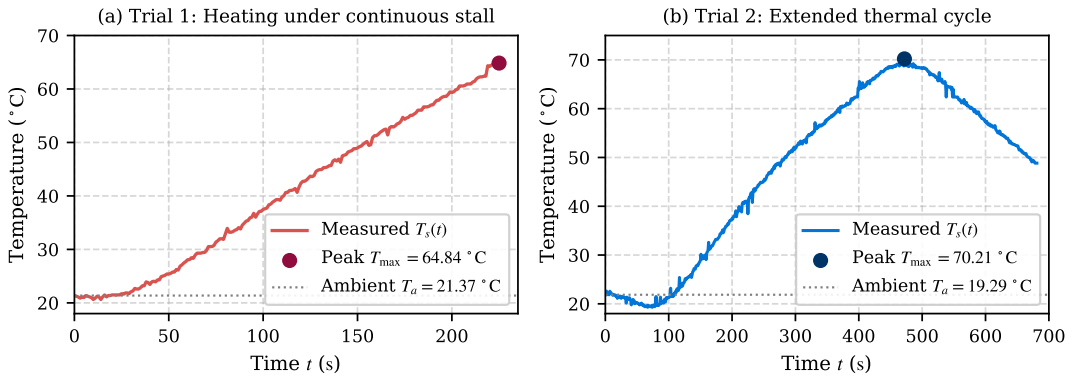
[picture p84: page 1]
Time t (s); Tem; perature (

(a) Trial 1: Heating under continuous stall

(b) Trial 2: Extended thermal cycle

Measured Ts(t)
Peak Tmax = 64.84 Ambient Ta = 21.37 | ∘ C

Measured Ts(t) Peak Tmax = 70.21 | ∘ C

Ambient Ta = 19.29 | ∘ C
