PaolaCV14/IOT-SOFIA-2026/docs/prototype-cad/Sofia003-E001-04.pdf

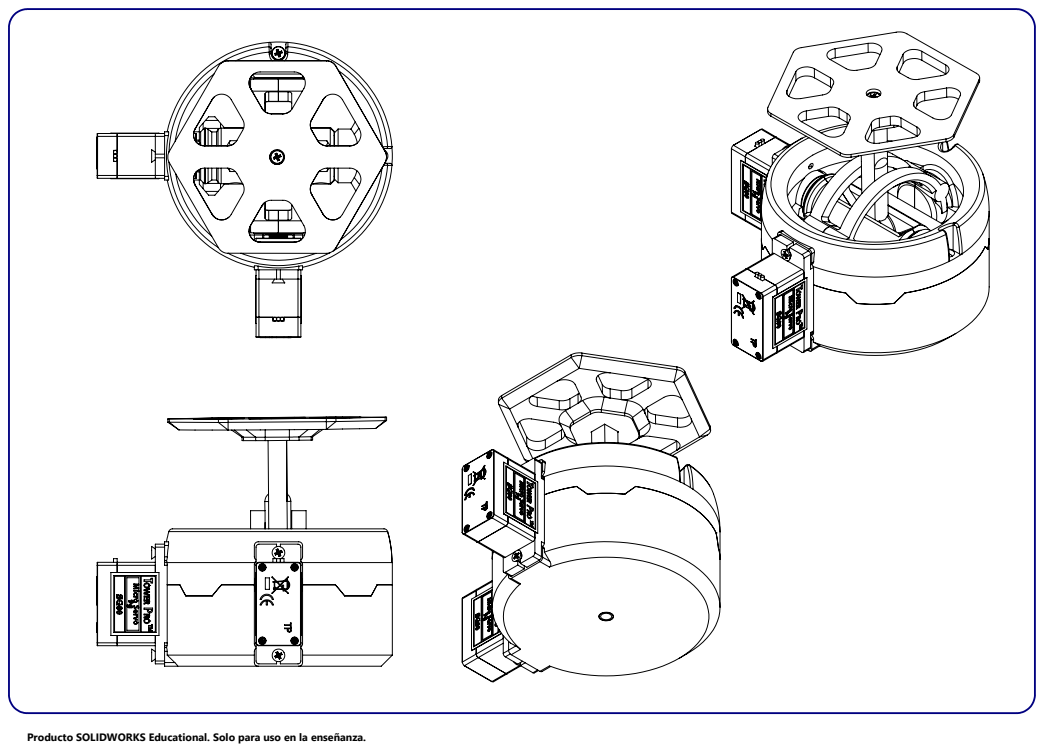
[picture p85: page 1]

Producto SOLIDWORKS Educational. Solo para uso en la enseñanza.
