PaolaCV14/IOT-SOFIA-2026/(commit log)

2026-08-31 Paper de SOFIA
2026-08-31 Figuras de simulacion
2026-09-04 update tracer con rotate matematico mejor
2026-09-20 docs(paper): add computer vision pipeline and custom PCB design specifications
2026-09-20 docs(paper): correct hardware stage to reflect breadboard prototype and present state
2026-09-25 feat(vision): 5 posturas (3 dinámicas + 2 estáticas), suavizado EMA y telemetría de benchmark en tiempo real
2026-09-25 docs: humanizar redaccion de reporte de gestos, simplificar explicacion y comentarios de codigo
2026-09-25 refactor(vision): humanizar comentarios y prints en todos los modulos .py para estilo escolar
2026-09-25 docs: actualizar README de tracking-vision con detalles del avance de posturas y suavizado
2026-09-25 docs: documentar el catalogo completo de 7 posturas (3 dinamicas y 4 estaticas)
2026-10-05 docs(paper): atender observaciones de revisores (R1.1-R1.6, R2.2-R2.4, R4.2, R4.4, R4.6) y actualizar carta de respuesta
    [servo_characterization.xlsx]
2026-10-07 connect whit unity by socket
2026-10-13 reconocimiento de hola ejecuta rutina
2026-10-14 rutinas de saludo y corazon
2026-10-15 my god a quedao el doc
2026-10-16 codigo arduino
